FilipaRibeiro2020/Invictus2.0_Hardware/Boards/Rocket Systems/OBC/Renders/OBC_front.png

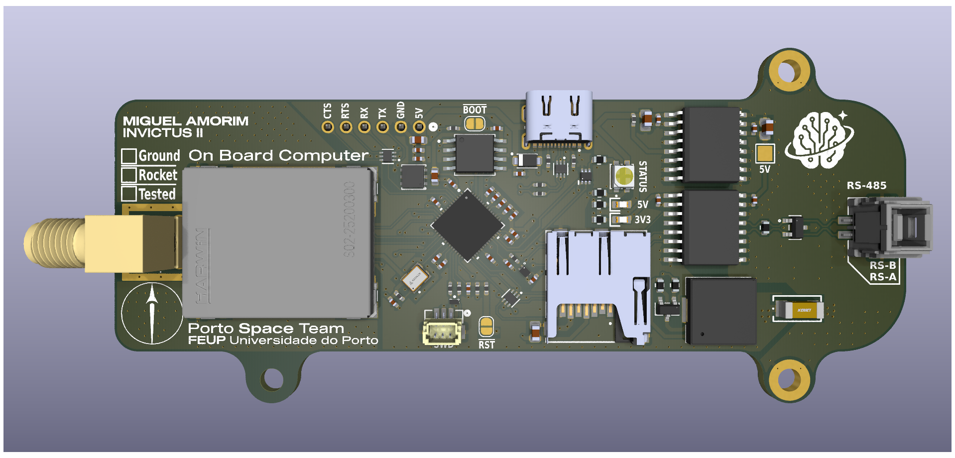
Boards/Rocket Systems/OBC/Renders/OBC_front.png
