FilipaRibeiro2020/Invictus2.0_Hardware/Boards/Rocket Systems/Elytra/Renders/Elytra_back.png

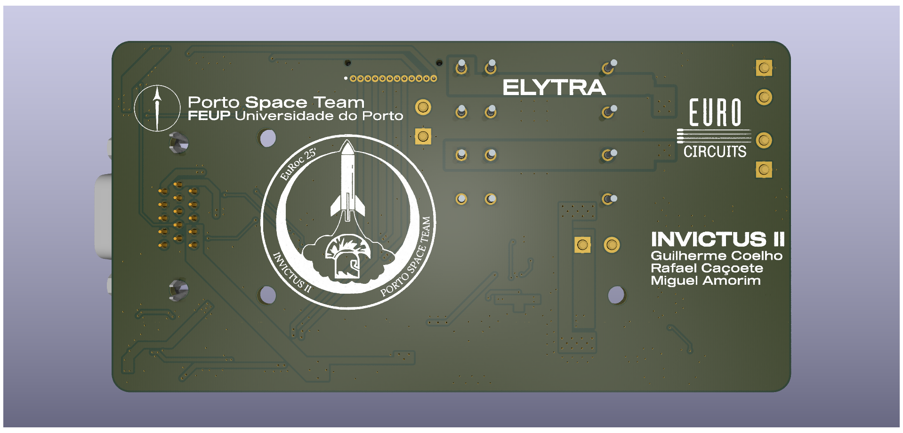
Boards/Rocket Systems/Elytra/Renders/Elytra_back.png
