FilipaRibeiro2020/Invictus2.0_Hardware/Boards/PayLoad/PocketSat/Renders/PocketSat_Front cropped.png

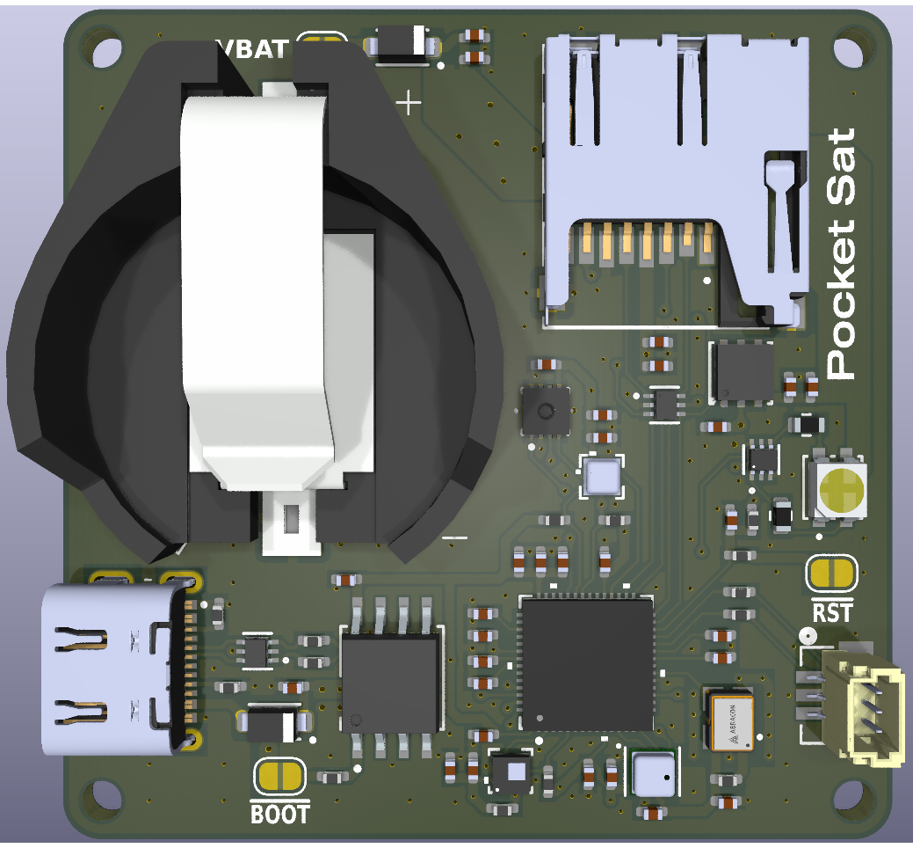
Boards/PayLoad/PocketSat/Renders/PocketSat_Front cropped.png
