FilipaRibeiro2020/Invictus2.0_Hardware/Boards/Rocket Systems/Elytra/Renders/Elytra_front.png

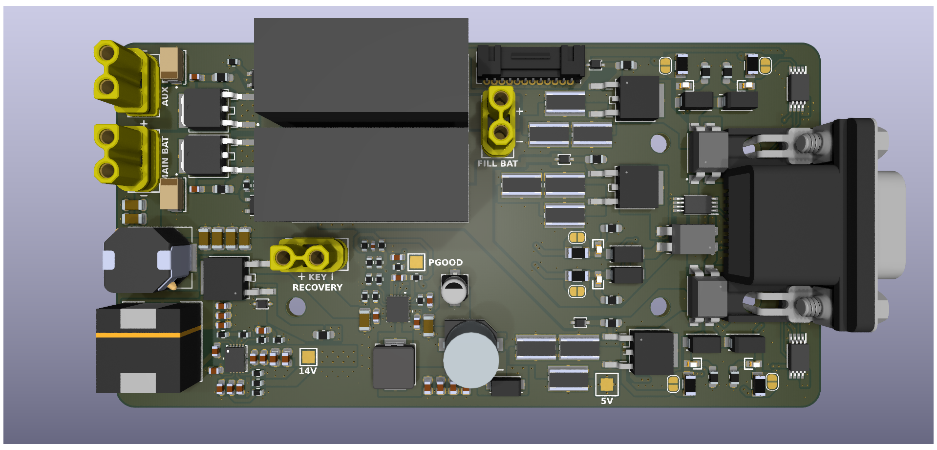
Boards/Rocket Systems/Elytra/Renders/Elytra_front.png
