FilipaRibeiro2020/Invictus2.0_Hardware/Boards/Rocket Systems/HYDRA/3D/HYDRA.png

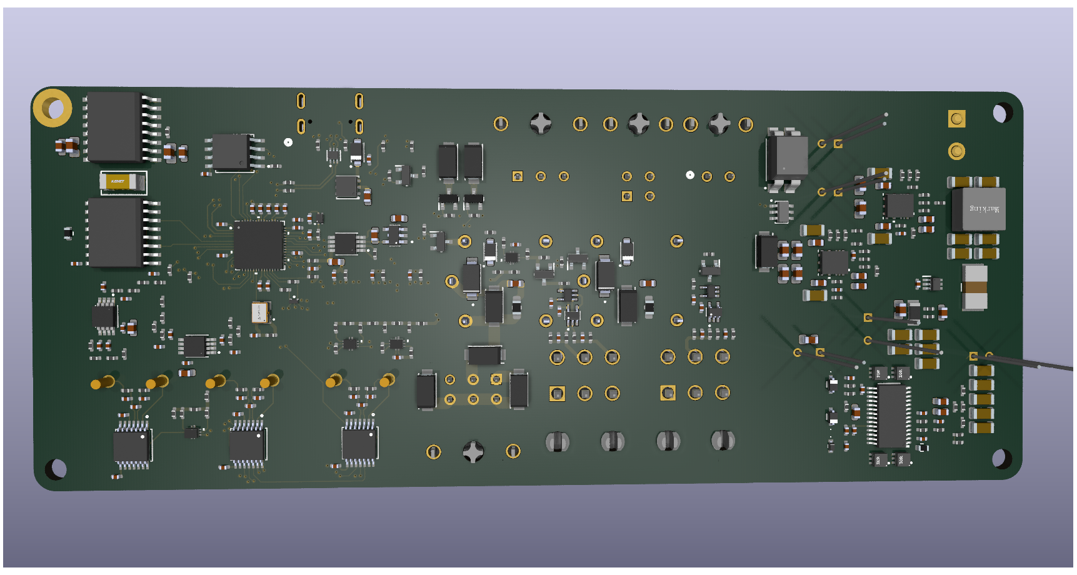
Boards/Rocket Systems/HYDRA/3D/HYDRA.png
