FilipaRibeiro2020/Invictus2.0_Hardware/Boards/Rocket Systems/Navigator/3D/Navigator_back.png

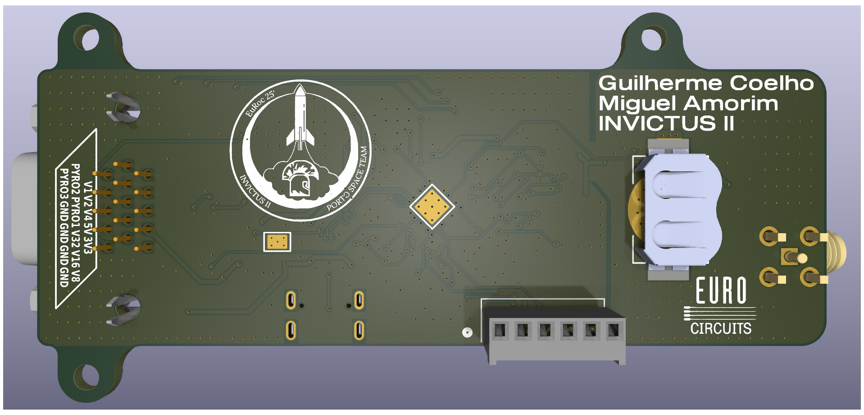
Boards/Rocket Systems/Navigator/3D/Navigator_back.png
