FilipaRibeiro2020/Invictus2.0_Hardware/Boards/Rocket Systems/Navigator/3D/Navigator_front.png

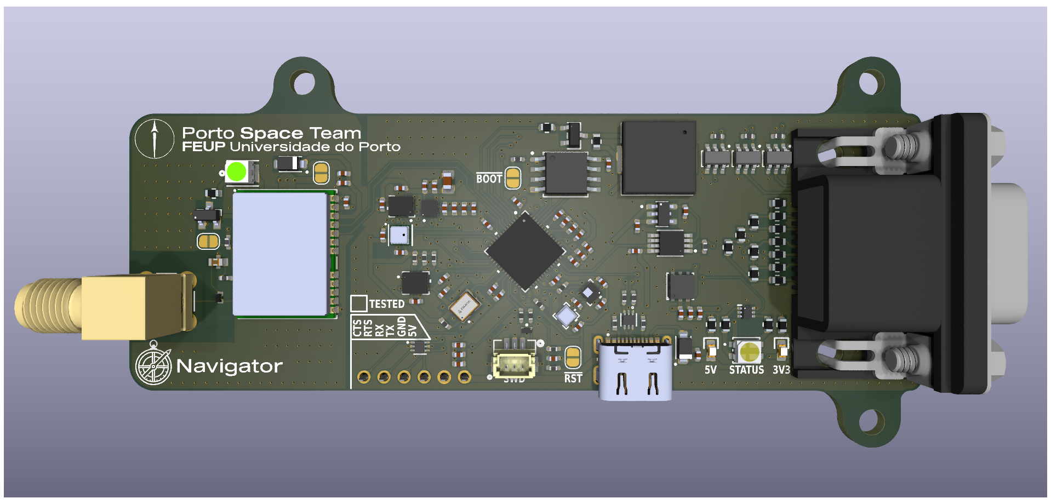
Boards/Rocket Systems/Navigator/3D/Navigator_front.png
