FilipaRibeiro2020/Invictus2.0_Hardware/Boards/Rocket Systems/OBC/Renders/OBC_back.png

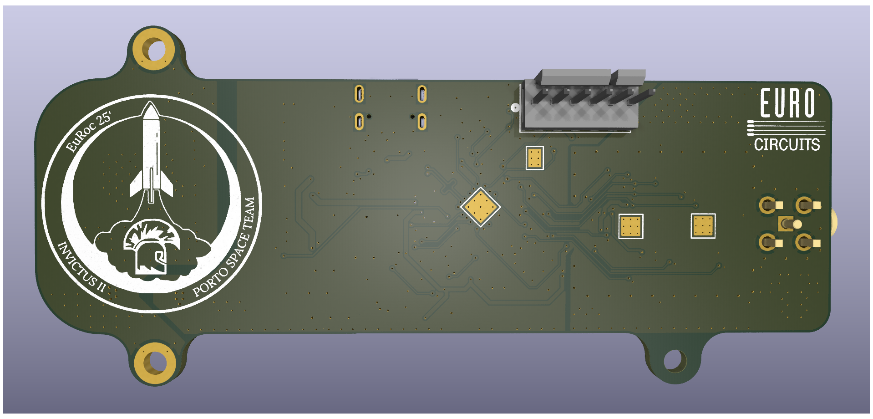
Boards/Rocket Systems/OBC/Renders/OBC_back.png
