FilipaRibeiro2020/Invictus2.0_Hardware/Boards/Rocket Systems/HYDRA/3D/HYDRA.step

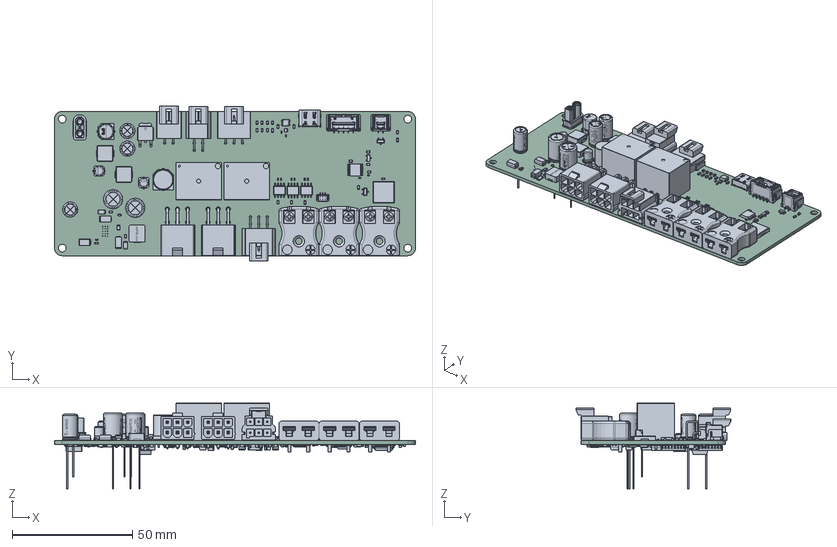
[picture p9: CAD file, 2025-10-10]
Boards/Rocket Systems/HYDRA/3D/HYDRA.step
150.0 x 64.2 x 35.6 mm
CAP_0603 x 31
FilletPin1 x 11
FilletPin2 x 11
RU-16_ADI
VLMY1300-GS08 x 5
RES_0402 x 115
標準品ケースΦ4x5.3L SIDE CODE B x 2
標準品座版Φ4 SIZE CODE B x 2
標準品リード線Φ4 SIZE CODE B x 4
BottomBlade x 6
Screw x 6
M2-Écrou x 6
TopBlade x 6
PKMCS0909E4000-R1
term1 x 14
term2 x 14
BODY-SO x 3
LEAD-SO x 24
THERMALPAD-SO x 3
STPS15L45CB
PinsArrayL x 7
FilletPinR x 6
XT30UPB-F
BZT52C8V2T-7 x 2
PR12-12V-360-1C x 2
CAP_0402 x 70
RC1206FR-0710RL x 3
VLMKG3400-GS08
Inductor-7.2mm-4u7
NSVT30010MXV6T1G
SOT23-3_LTF
BM03B-SRSS-TB-LF-SN
SRP 7028A series.stp x 2
Base
Pin1Fillet
Pin2Fillet
DX07S016JA1R1500
BC846BLT1G
EDK107M035S9HAA
CAP_0805 x 10
WQFN10_1P4X1P8_ONS x 4
QFN56_7X7_RPI
MAX31856MUD+T x 3
RES_2512
SN74AHC1G86DCKRE4 x 2
SOT23 lower body x 2
SOT23 Lead x 6
SOT23 Upper body x 2
PinsArrayR
ThermalPin
PinsArrayLR x 3
G3VM-DR_OMR
BODY-QFN_AF0 x 2
PIN1-ID x 2
ESD122DMYR
BODY-SOIC
LEAD-DW0016 x 16
PMEG2010ER x 3
SMAJ12A x 2
MSOP8_MC_MCH x 3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
