FilipaRibeiro2020/Invictus2.0_Hardware/Symbols Lib/Contacts&Switches/10-18-1041/10-18-1041.stp

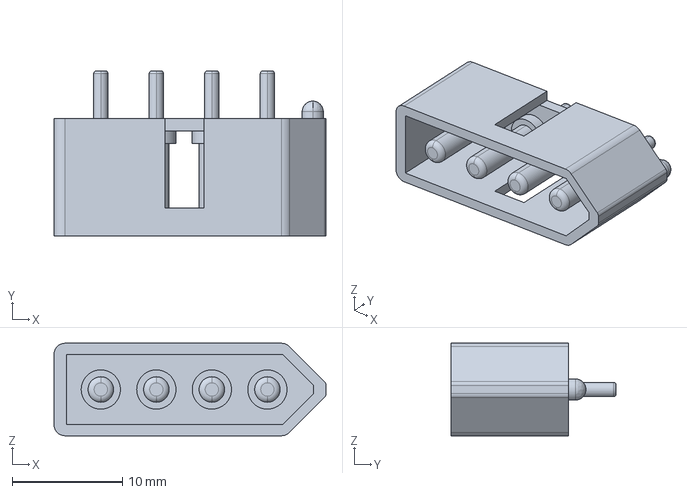
[picture p10: CAD file, 2025-10-10]
Symbols Lib/Contacts&Switches/10-18-1041/10-18-1041.stp
24.6 x 15.0 x 8.38 mm
