FilipaRibeiro2020/Invictus2.0_Hardware/Symbols Lib/Contacts&Switches/39-28-8080/39-28-8080.stp

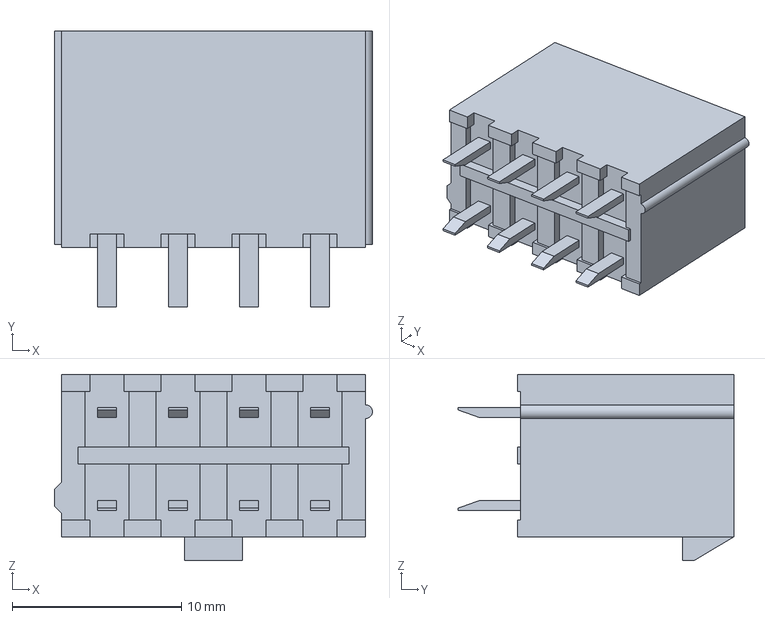
[picture p11: CAD file, 2025-10-10]
Symbols Lib/Contacts&Switches/39-28-8080/39-28-8080.stp
18.8 x 16.3 x 11.0 mm
