FilipaRibeiro2020/Invictus2.0_Hardware/Symbols Lib/Contacts&Switches/PR12-12V-360-1C/PR12-12V-360-1C.step

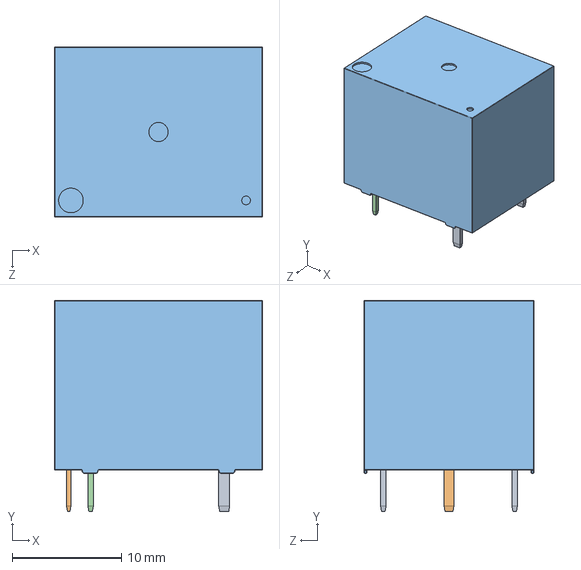
[picture p12: CAD file, 2025-10-10]
Symbols Lib/Contacts&Switches/PR12-12V-360-1C/PR12-12V-360-1C.step
19.0 x 19.3 x 15.5 mm
