FilipaRibeiro2020/Invictus2.0_Hardware/Symbols Lib/Contacts&Switches/PR30-12V-450-1C-E/PR30-12V-450-1C-E.step

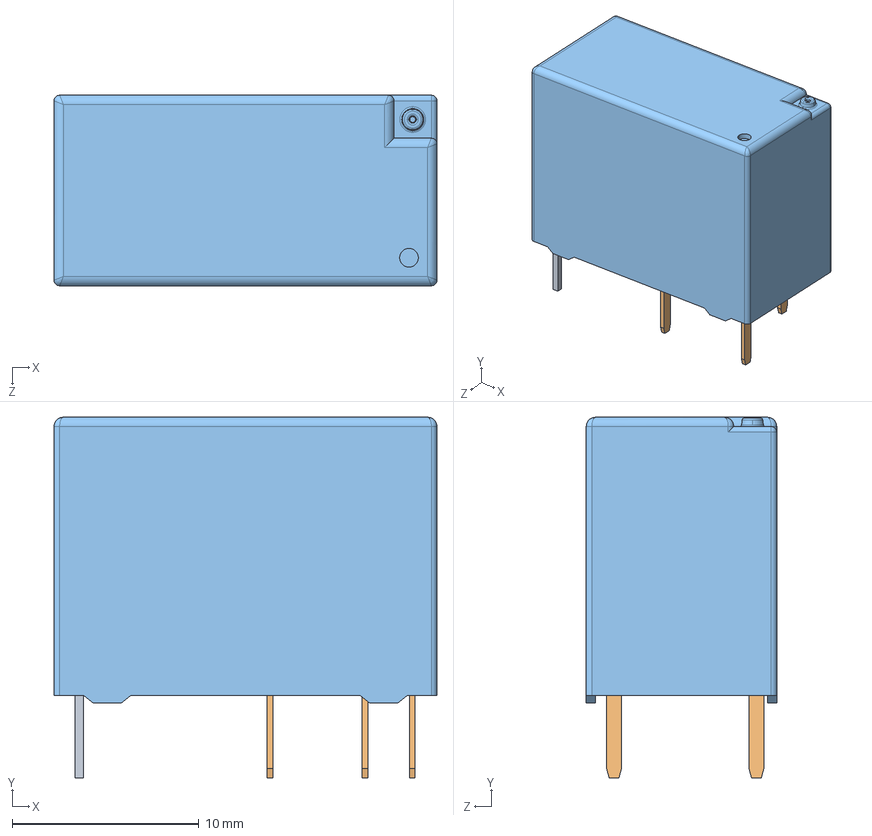
[picture p13: CAD file, 2025-10-10]
Symbols Lib/Contacts&Switches/PR30-12V-450-1C-E/PR30-12V-450-1C-E.step
20.5 x 19.3 x 10.2 mm
