FilipaRibeiro2020/Invictus2.0_Hardware/Symbols Lib/Contacts&Switches/ThermoPCBConnector/AM-K-PCB.step

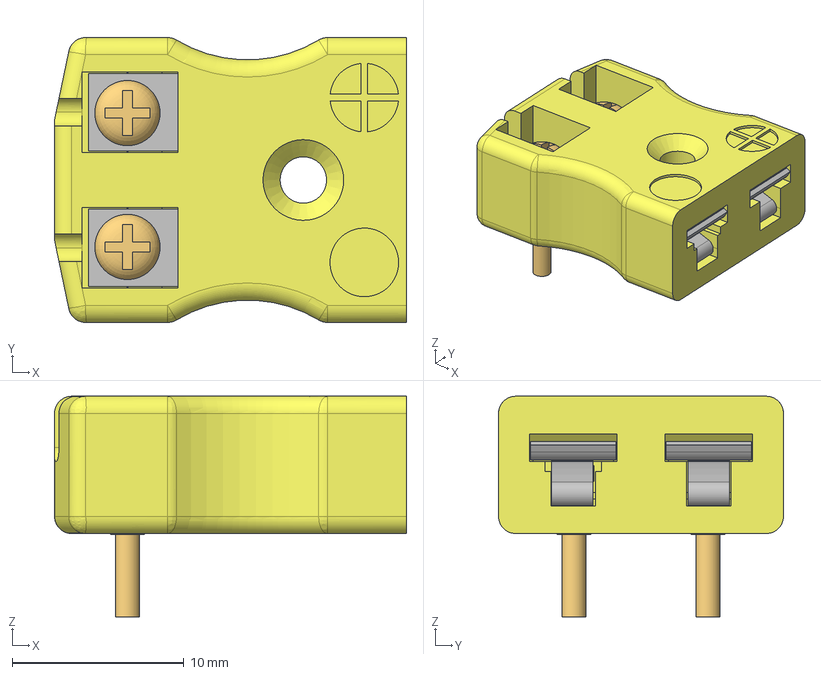
[picture p14: CAD file, 2025-08-11]
Symbols Lib/Contacts&Switches/ThermoPCBConnector/AM-K-PCB.step
20.5 x 16.6 x 12.9 mm
BottomBlade x 2
Screw x 2
M2-Écrou x 2
TopBlade x 2
