FilipaRibeiro2020/Invictus2.0_Hardware/Symbols Lib/Contacts&Switches/XT30UPB-F/XT30UPB-F.stp

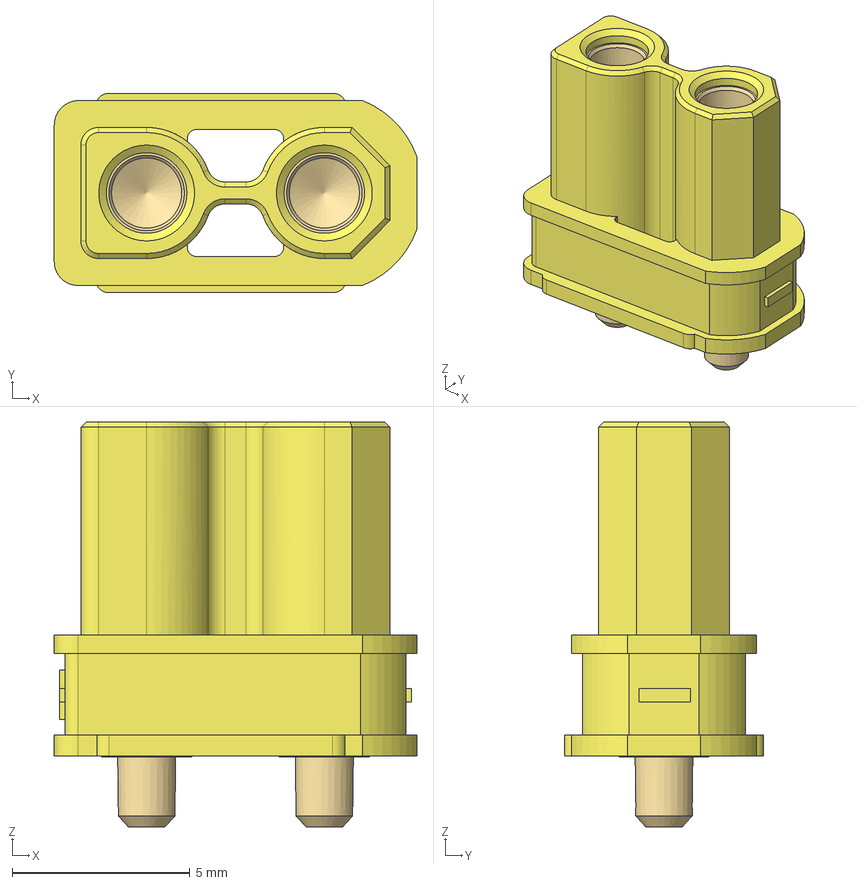
[picture p15: CAD file, 2025-08-11]
Symbols Lib/Contacts&Switches/XT30UPB-F/XT30UPB-F.stp
10.2 x 5.61 x 11.4 mm
