FilipaRibeiro2020/Invictus2.0_Hardware/Symbols Lib/ICs/2SCR375P5T100R/TRANS_2SA2071P_ROM.step

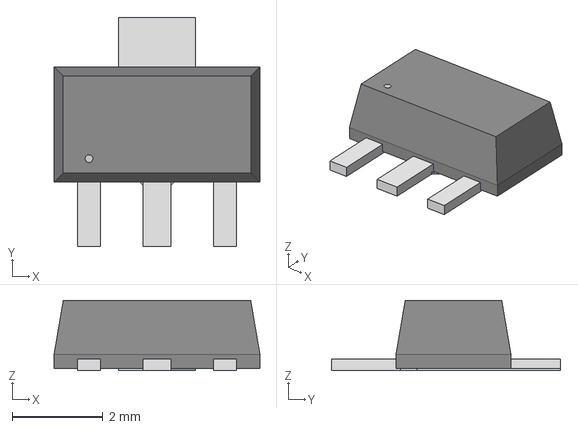
[picture p16: CAD file, 2025-10-10]
Symbols Lib/ICs/2SCR375P5T100R/TRANS_2SA2071P_ROM.step
4.55 x 5.05 x 1.55 mm
