FilipaRibeiro2020/Invictus2.0_Hardware/Symbols Lib/ICs/74AHC1G08SE-7/74AHC1G08SE-7.step

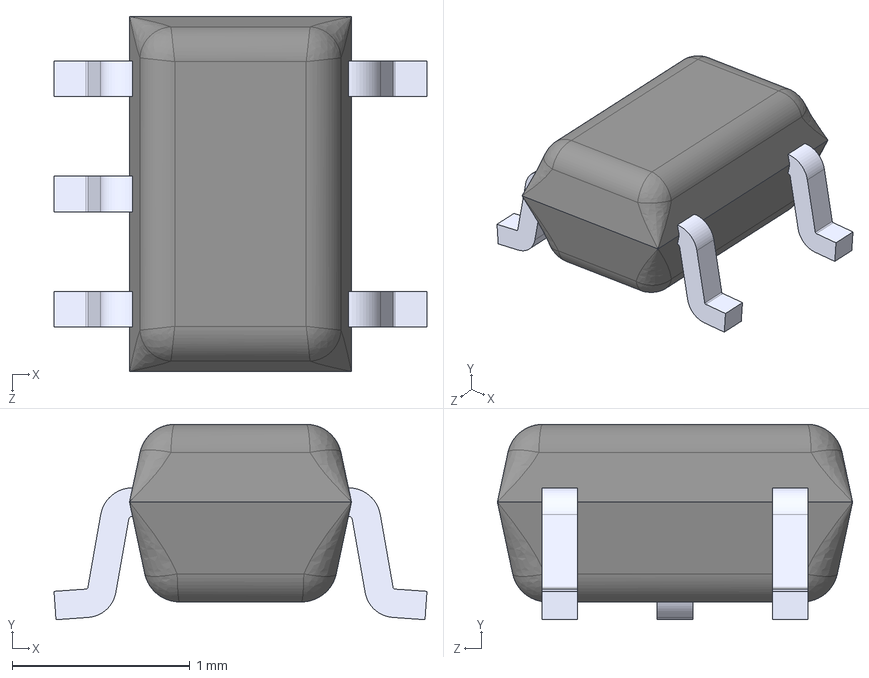
[picture p17: CAD file, 2025-10-10]
Symbols Lib/ICs/74AHC1G08SE-7/74AHC1G08SE-7.step
2.10 x 1.10 x 2.00 mm
