FilipaRibeiro2020/Invictus2.0_Hardware/Symbols Lib/ICs/BC846BLT1G/BC846BLT1G.step

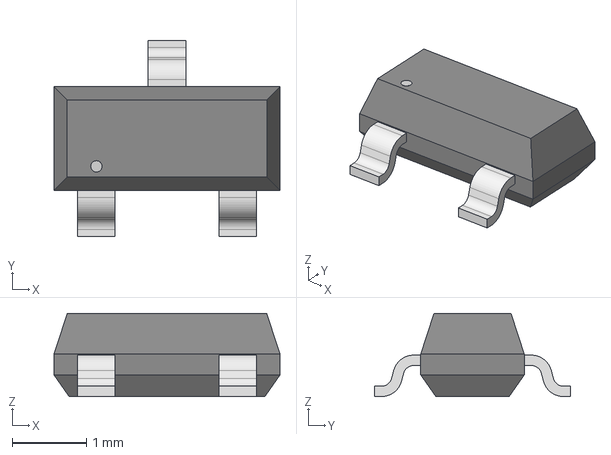
[picture p18: CAD file, 2025-08-11]
Symbols Lib/ICs/BC846BLT1G/BC846BLT1G.step
3.05 x 2.64 x 1.12 mm
