FilipaRibeiro2020/Invictus2.0_Hardware/Symbols Lib/ICs/BSS123/BSS123.stp

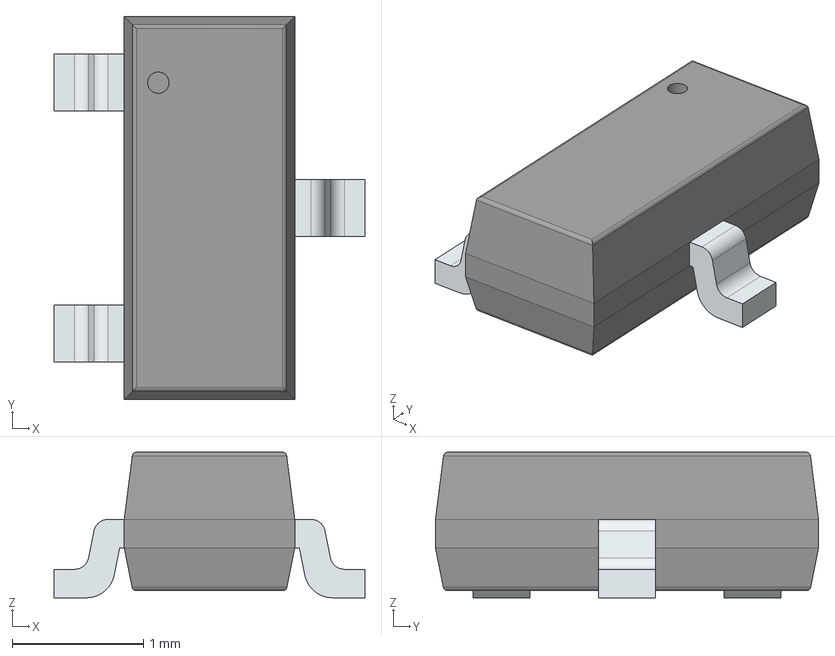
[picture p19: CAD file, 2025-10-10]
Symbols Lib/ICs/BSS123/BSS123.stp
2.37 x 2.92 x 1.11 mm
PinsArrayL
FilletPinR
