FilipaRibeiro2020/Invictus2.0_Hardware/Symbols Lib/ICs/IRLHS6242TRPBF/IRLHS6242TRPBF.stp

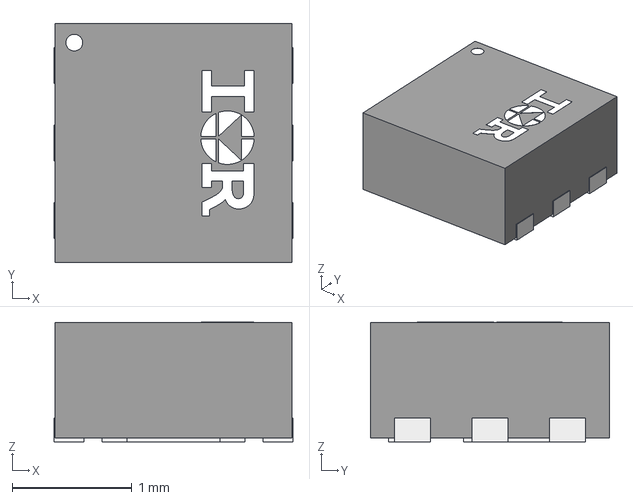
[picture p20: CAD file, 2025-10-10]
Symbols Lib/ICs/IRLHS6242TRPBF/IRLHS6242TRPBF.stp
2.00 x 2.00 x 1.00 mm
