FilipaRibeiro2020/Invictus2.0_Hardware/Symbols Lib/ICs/LM358BIPWR/LM358BIPWR.stp

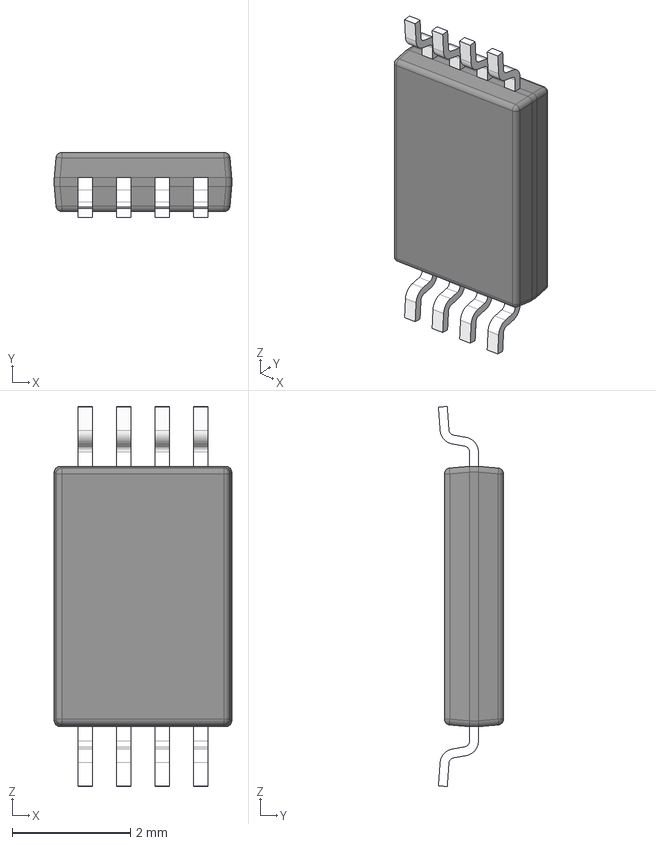
[picture p21: CAD file, 2025-08-19]
Symbols Lib/ICs/LM358BIPWR/LM358BIPWR.stp
3.00 x 1.10 x 6.42 mm
BODY-SO
LEAD-SO x 8
PIN1-ID
