FilipaRibeiro2020/Invictus2.0_Hardware/Symbols Lib/ICs/MCP6002-E-MS/MSOP8_MC_MCH.step

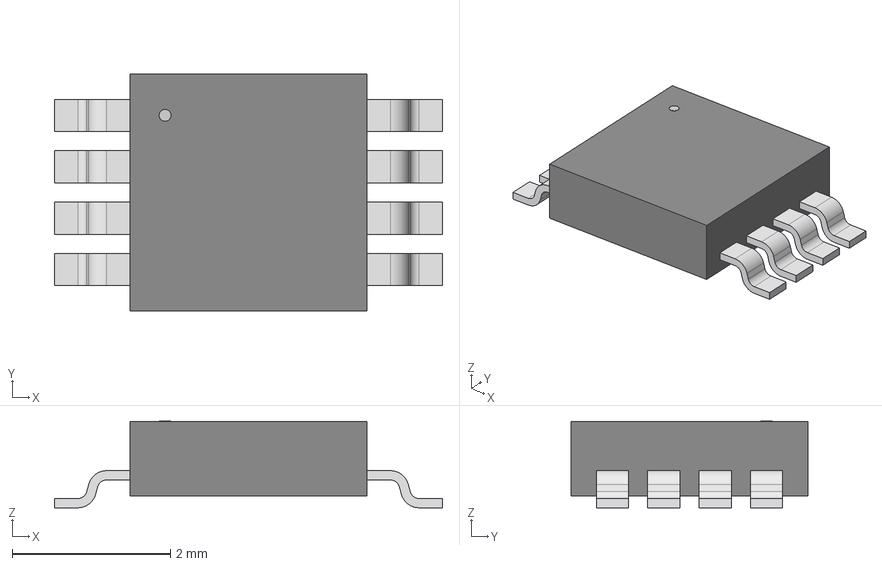
[picture p22: CAD file, 2025-08-11]
Symbols Lib/ICs/MCP6002-E-MS/MSOP8_MC_MCH.step
4.90 x 3.00 x 1.09 mm
