FilipaRibeiro2020/Invictus2.0_Hardware/Symbols Lib/ICs/NCV8114ASN165T1G/NCV8114ASN165T1G.step

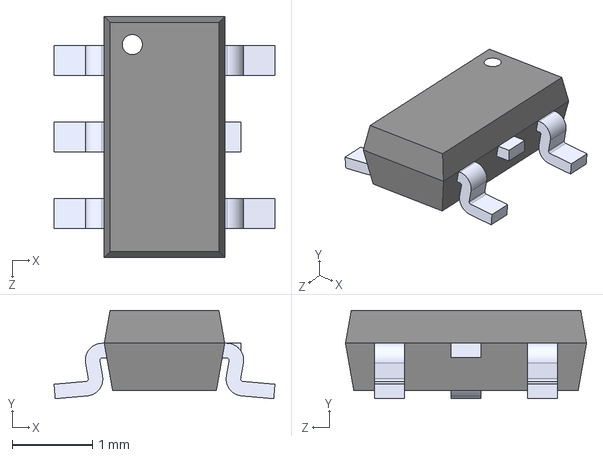
[picture p23: CAD file, 2025-08-11]
Symbols Lib/ICs/NCV8114ASN165T1G/NCV8114ASN165T1G.step
2.75 x 1.10 x 3.00 mm
