FilipaRibeiro2020/Invictus2.0_Hardware/Symbols Lib/ICs/NJD35N04T4G/DPAK-4_6P22X6P73_ONS.step

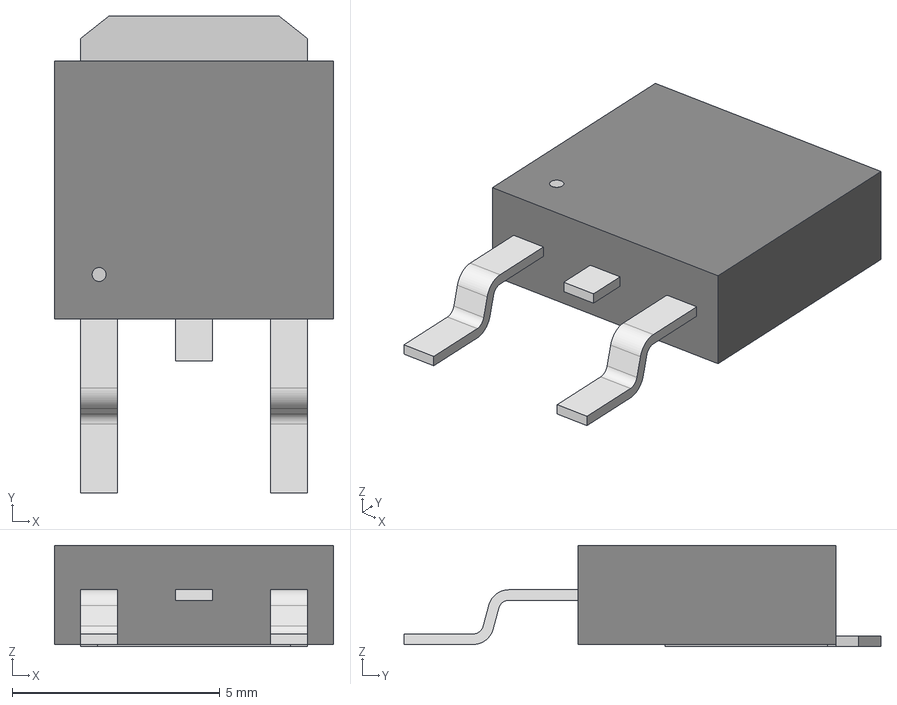
[picture p24: CAD file, 2025-08-19]
Symbols Lib/ICs/NJD35N04T4G/DPAK-4_6P22X6P73_ONS.step
6.73 x 11.5 x 2.44 mm
