FilipaRibeiro2020/Invictus2.0_Hardware/Symbols Lib/ICs/NLAS5223BMNR2G/WQFN10_1P4X1P8_ONS.step

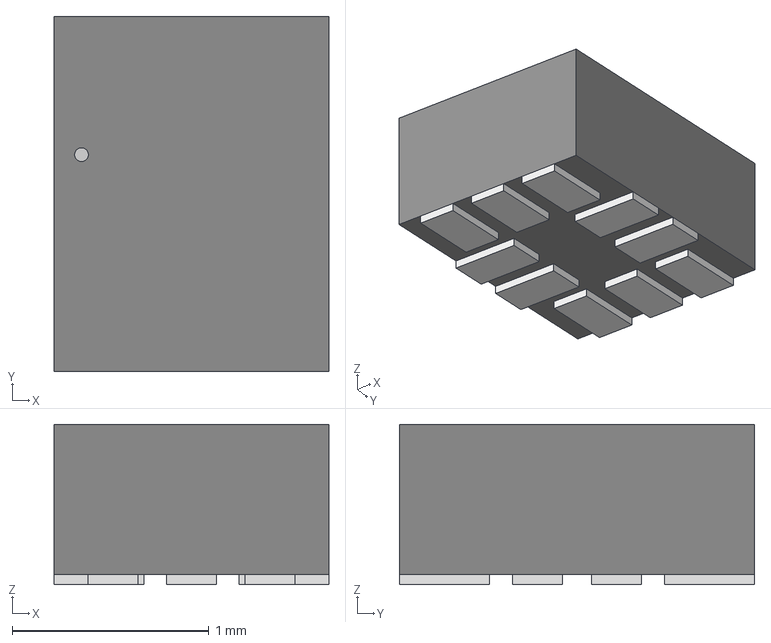
[picture p25: CAD file, 2025-08-11]
Symbols Lib/ICs/NLAS5223BMNR2G/WQFN10_1P4X1P8_ONS.step
1.40 x 1.80 x 0.815 mm
