FilipaRibeiro2020/Invictus2.0_Hardware/Symbols Lib/ICs/NSVT30010MXV6T1G/NSVT30010MXV6T1G.STEP

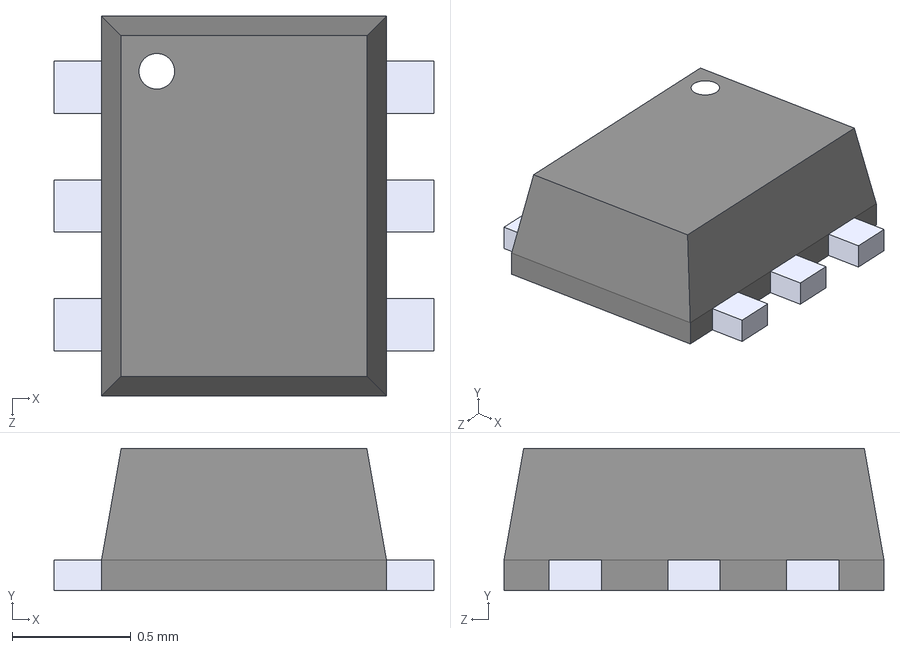
[picture p26: CAD file, 2025-08-19]
Symbols Lib/ICs/NSVT30010MXV6T1G/NSVT30010MXV6T1G.STEP
1.60 x 0.6 x 1.60 mm
