FilipaRibeiro2020/Invictus2.0_Hardware/Symbols Lib/ICs/PMV20XNER/PMV20XNER.stp

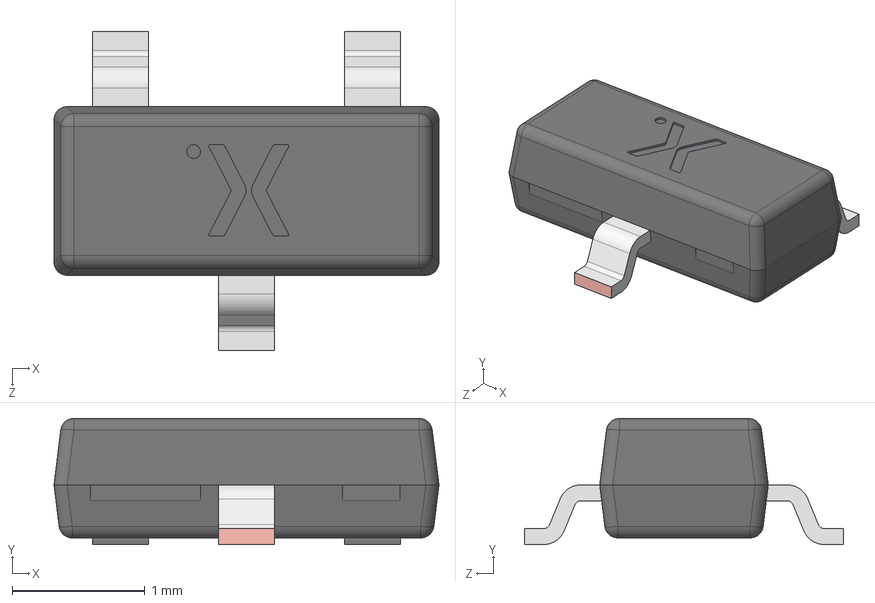
[picture p27: CAD file, 2025-10-10]
Symbols Lib/ICs/PMV20XNER/PMV20XNER.stp
2.90 x 0.95 x 2.40 mm
SOT23 lower body
SOT23 Lead x 3
SOT23 Upper body
