FilipaRibeiro2020/Invictus2.0_Hardware/Symbols Lib/ICs/SN74AHC1G86DCKRE4/SN74AHC1G86DCKRE4.step

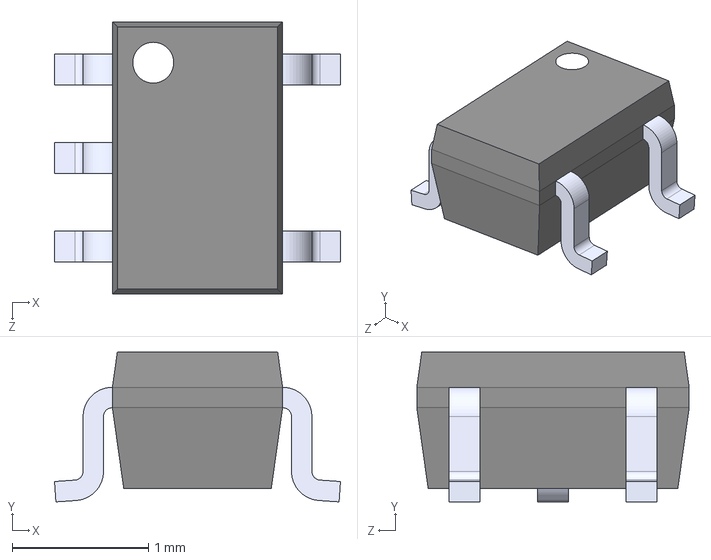
[picture p28: CAD file, 2025-10-10]
Symbols Lib/ICs/SN74AHC1G86DCKRE4/SN74AHC1G86DCKRE4.step
2.10 x 1.10 x 2.00 mm
