FilipaRibeiro2020/Invictus2.0_Hardware/Symbols Lib/ICs/STPS15L45CB/STPS15L45CB.stp

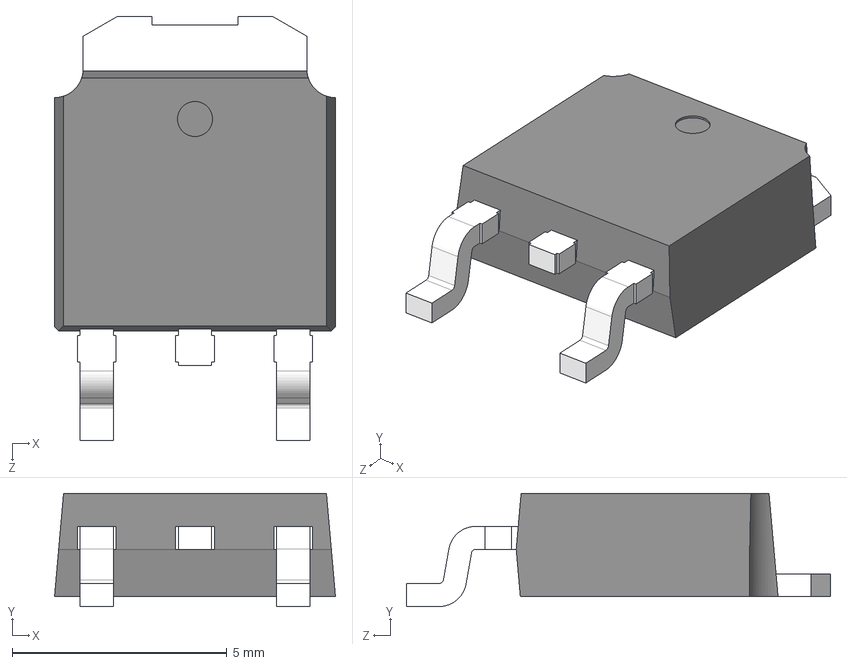
[picture p29: CAD file, 2025-08-19]
Symbols Lib/ICs/STPS15L45CB/STPS15L45CB.stp
6.54 x 2.63 x 9.88 mm
