FilipaRibeiro2020/Invictus2.0_Hardware/Symbols Lib/Passive Components/Capacitor-6.3mm/EDK107M035S9HAA.stp

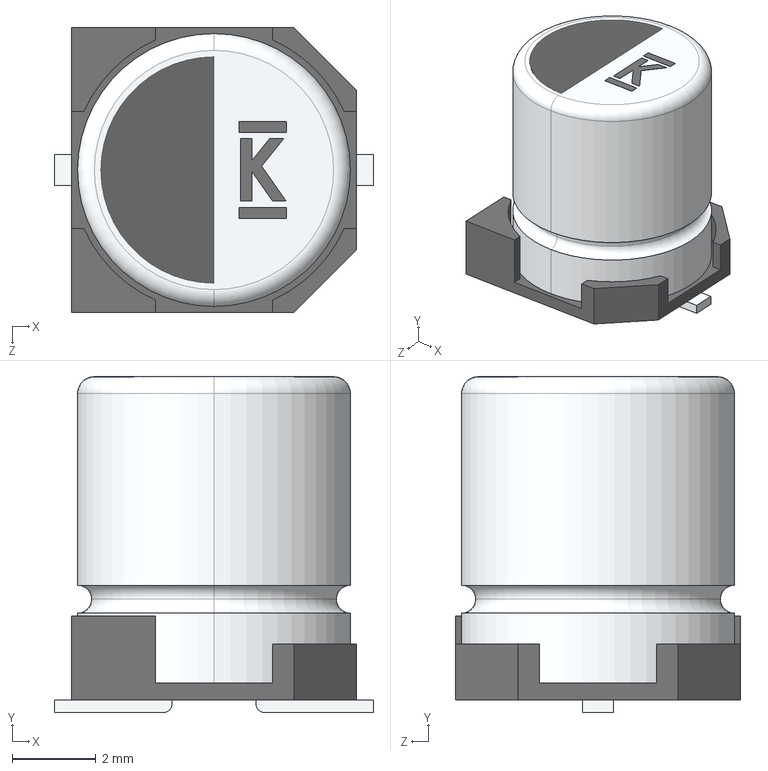
[picture p30: CAD file, 2025-10-10]
Symbols Lib/Passive Components/Capacitor-6.3mm/EDK107M035S9HAA.stp
7.60 x 8.01 x 6.80 mm
