FilipaRibeiro2020/Invictus2.0_Hardware/Symbols Lib/Passive Components/Capacitor-THT-6.3mm/Capacitor-6.3mm-THT.stp

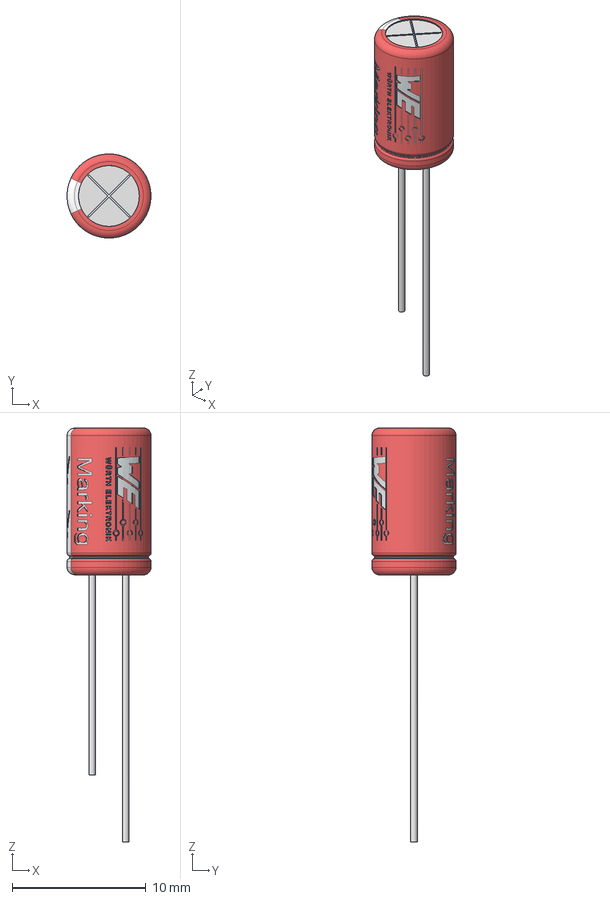
[picture p31: CAD file, 2025-08-19]
Symbols Lib/Passive Components/Capacitor-THT-6.3mm/Capacitor-6.3mm-THT.stp
6.29 x 6.30 x 31.0 mm
