FilipaRibeiro2020/Invictus2.0_Hardware/Symbols Lib/Passive Components/Capacitor-THT-8mm/Cap-8mm-THT.stp

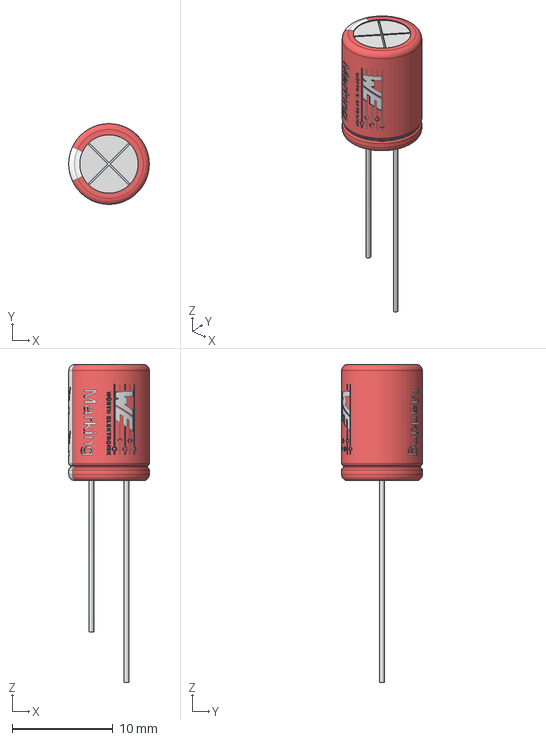
[picture p32: CAD file, 2025-08-19]
Symbols Lib/Passive Components/Capacitor-THT-8mm/Cap-8mm-THT.stp
7.99 x 8.00 x 31.5 mm
