FilipaRibeiro2020/Invictus2.0_Hardware/Symbols Lib/Passive Components/Diodo_BAS316,115/BAS316-115.STEP

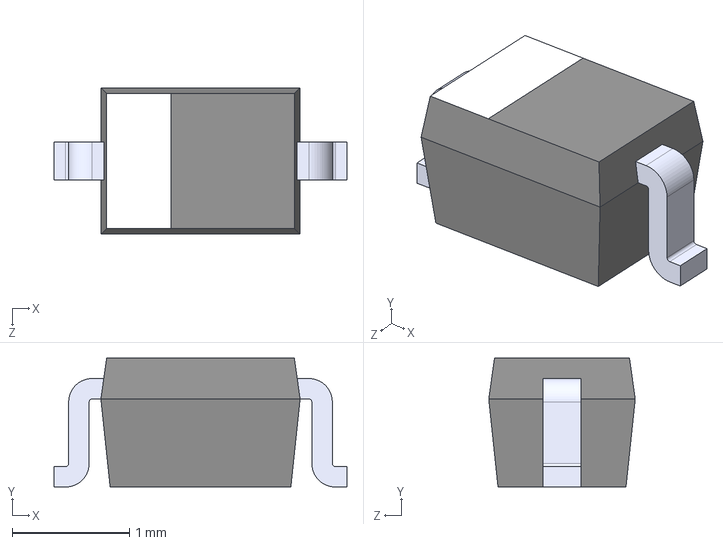
[picture p33: CAD file, 2025-10-10]
Symbols Lib/Passive Components/Diodo_BAS316,115/BAS316-115.STEP
2.50 x 1.10 x 1.25 mm
