FilipaRibeiro2020/Invictus2.0_Hardware/Symbols Lib/Passive Components/Diodo_BZT52C8V2T-7/BZT52C8V2T-7.STEP

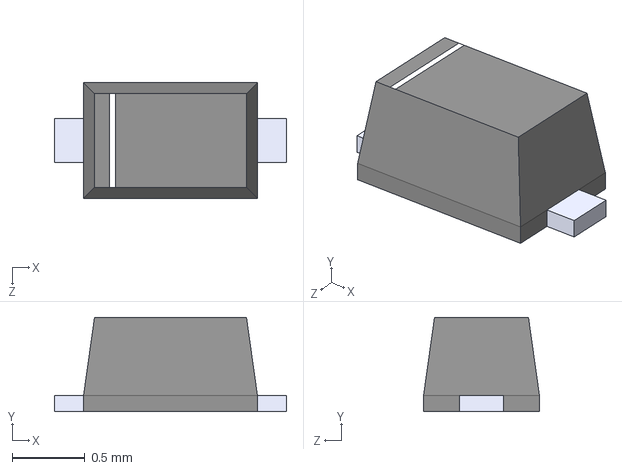
[picture p34: CAD file, 2025-10-10]
Symbols Lib/Passive Components/Diodo_BZT52C8V2T-7/BZT52C8V2T-7.STEP
1.60 x 0.65 x 0.8 mm
