FilipaRibeiro2020/Invictus2.0_Hardware/Symbols Lib/Passive Components/G2RL-1A4-E-DC12/G2RL-1A4-E-DC12.stp

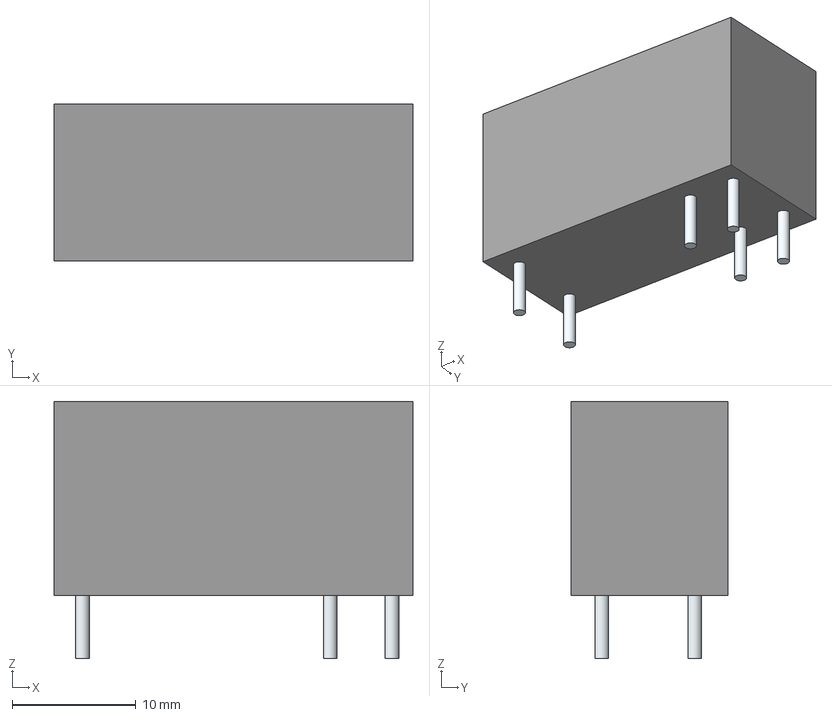
[picture p35: CAD file, 2025-08-11]
Symbols Lib/Passive Components/G2RL-1A4-E-DC12/G2RL-1A4-E-DC12.stp
29.0 x 12.7 x 20.8 mm
Leads x 6
