FilipaRibeiro2020/Invictus2.0_Hardware/Symbols Lib/Passive Components/Inductor-7.2mm-4u7/Inductor-7.2mm-4u7.step

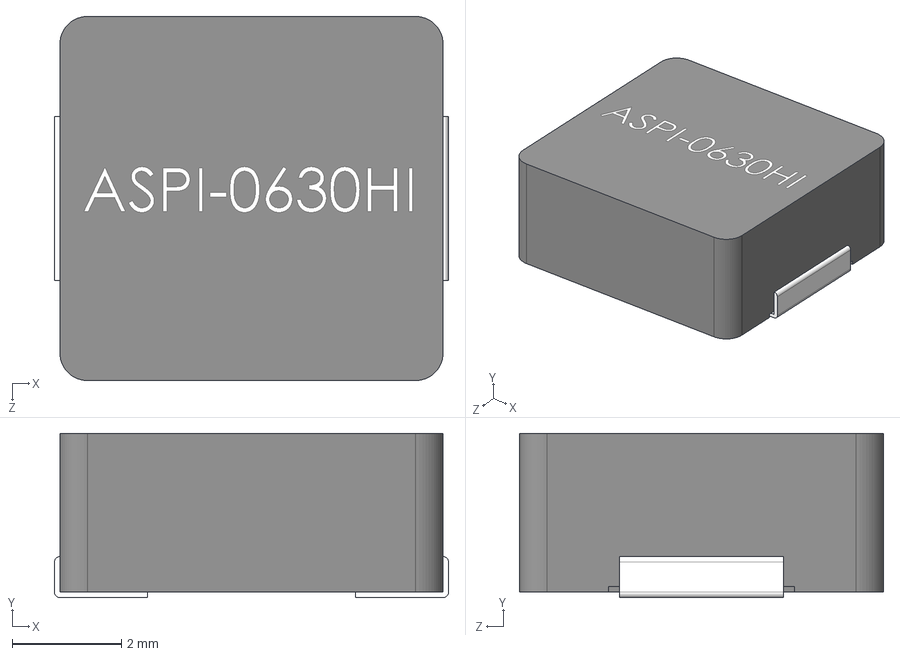
[picture p36: CAD file, 2025-10-10]
Symbols Lib/Passive Components/Inductor-7.2mm-4u7/Inductor-7.2mm-4u7.step
7.20 x 3.00 x 6.65 mm
