FilipaRibeiro2020/Invictus2.0_Hardware/Symbols Lib/Passive Components/Inductor-7.3mm-10u/Inductor-7.3mm-10u.stp

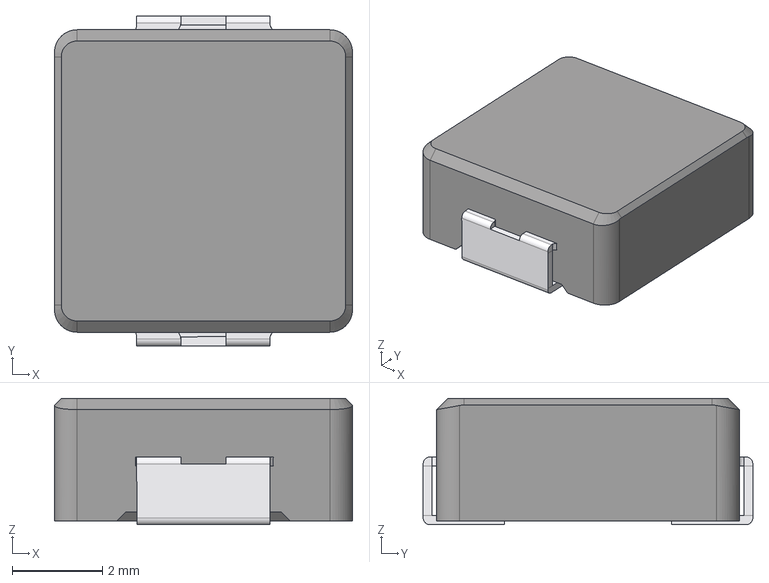
[picture p37: CAD file, 2025-10-10]
Symbols Lib/Passive Components/Inductor-7.3mm-10u/Inductor-7.3mm-10u.stp
6.60 x 7.30 x 2.80 mm
