FilipaRibeiro2020/Invictus2.0_Hardware/Symbols Lib/Passive Components/Inductor_SRP6030CA/SRP6030CA-2R2M.stp

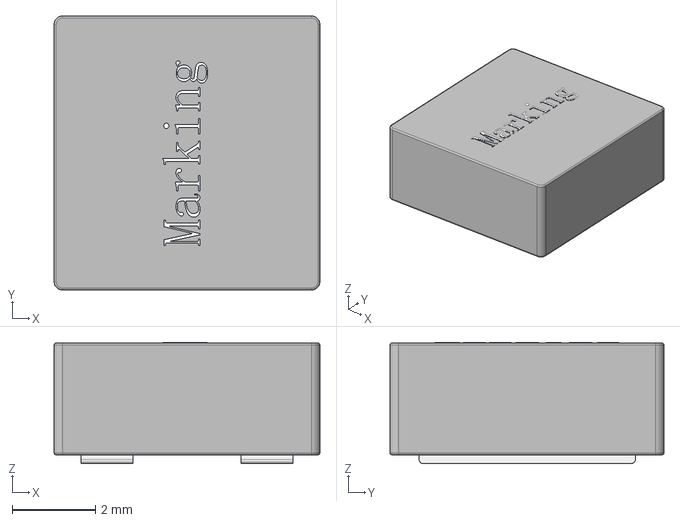
[picture p38: CAD file, 2025-10-10]
Symbols Lib/Passive Components/Inductor_SRP6030CA/SRP6030CA-2R2M.stp
6.40 x 6.60 x 2.92 mm
