FilipaRibeiro2020/Invictus2.0_Hardware/Symbols Lib/Passive Components/PFNF.035.2/PFNF.035.2.STEP

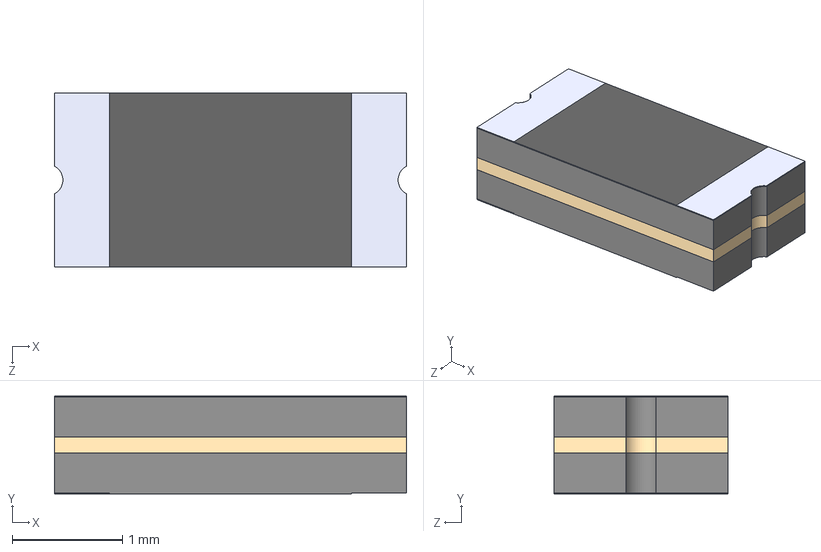
[picture p39: CAD file, 2025-08-19]
Symbols Lib/Passive Components/PFNF.035.2/PFNF.035.2.STEP
3.20 x 0.89 x 1.59 mm
