FilipaRibeiro2020/Invictus2.0_Hardware/Symbols Lib/Passive Components/Resistor-1206/RC1206FR-0710RL.stp

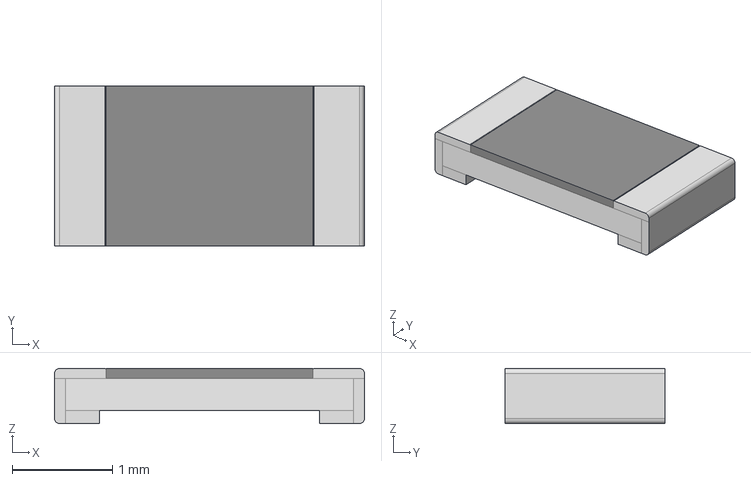
[picture p40: CAD file, 2025-08-19]
Symbols Lib/Passive Components/Resistor-1206/RC1206FR-0710RL.stp
3.10 x 1.60 x 0.55 mm
