FilipaRibeiro2020/Invictus2.0_Hardware/Symbols Lib/Passive Components/Resistor-2512/RES_2512.step

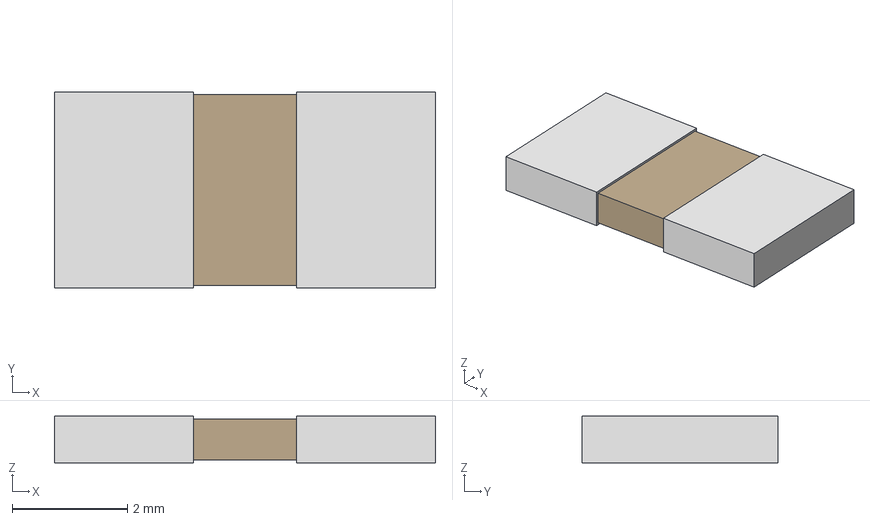
[picture p41: CAD file, 2025-10-10]
Symbols Lib/Passive Components/Resistor-2512/RES_2512.step
6.60 x 3.40 x 0.813 mm
