FilipaRibeiro2020/Invictus2.0_Hardware/Symbols Lib/Passive Components/SMAJ12A/SMAJ12A.step

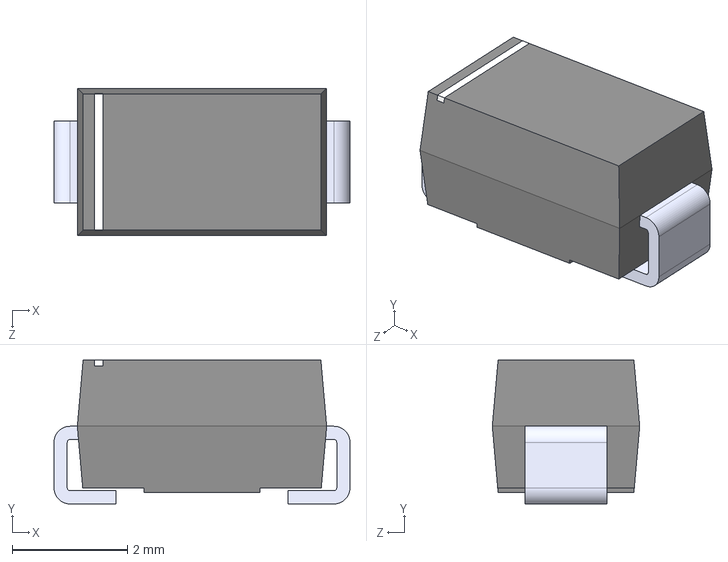
[picture p42: CAD file, 2025-10-10]
Symbols Lib/Passive Components/SMAJ12A/SMAJ12A.step
5.14 x 2.50 x 2.56 mm
