FilipaRibeiro2020/Invictus2.0_Hardware/Symbols Lib/Passive Components/SMAJ14A/SMASeries_LTF.step

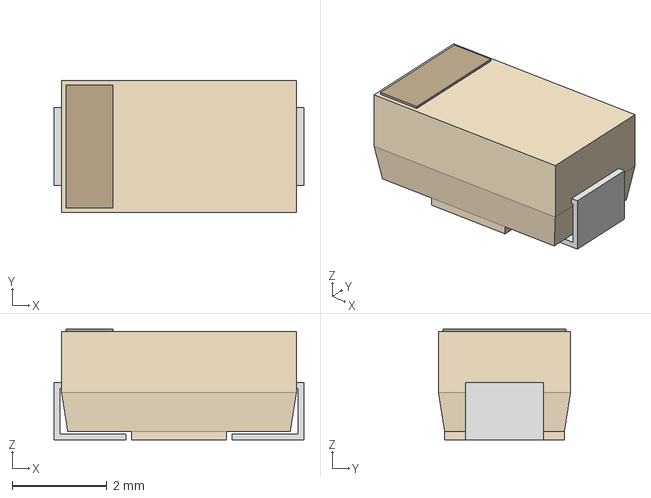
[picture p43: CAD file, 2025-08-11]
Symbols Lib/Passive Components/SMAJ14A/SMASeries_LTF.step
5.28 x 2.79 x 2.34 mm
