FilipaRibeiro2020/Invictus2.0_Hardware/Symbols Lib/Passive Components/VBT4045BP-E3-4W/DPAK_BP-E34W_VIS.step

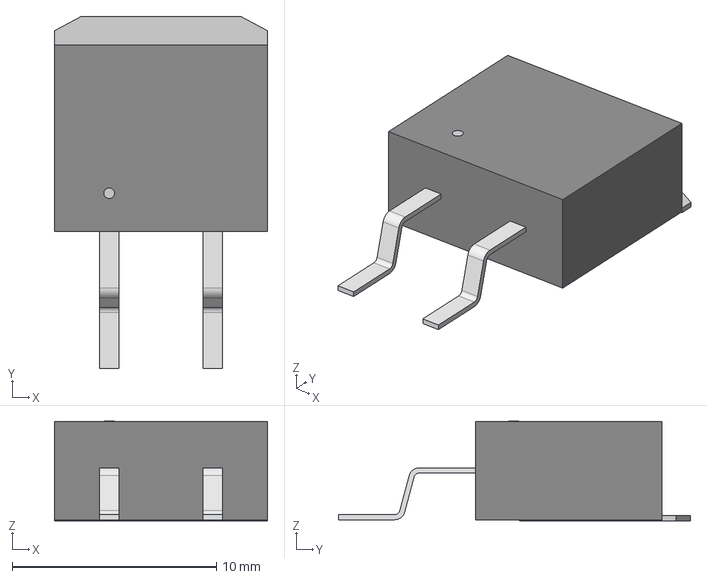
[picture p44: CAD file, 2025-08-11]
Symbols Lib/Passive Components/VBT4045BP-E3-4W/DPAK_BP-E34W_VIS.step
10.4 x 17.2 x 4.88 mm
