FilipaRibeiro2020/Invictus2.0_Hardware/(list of files, cad)

Other CAD files:
Symbols Lib/Contacts&Switches/1723103102/1723103102.step
Symbols Lib/Contacts&Switches/1723103103/1723103103.step
Symbols Lib/Contacts&Switches/1723163206/1723163206.step
Symbols Lib/Contacts&Switches/1723163304/1723163304.step
Symbols Lib/Contacts&Switches/26013116/26013116.step
Symbols Lib/Contacts&Switches/5024430270/5024430270.stp
Symbols Lib/Contacts&Switches/5024430570/5024430570.stp
Symbols Lib/Contacts&Switches/CONN02_532540270_MOL/532540270.stp
Symbols Lib/Contacts&Switches/CONN_5569-10A_MOL/0039300100.stp
Symbols Lib/Contacts&Switches/PB114012/PB114012.stp
Symbols Lib/ICs/ISL21010CFH325Z-TK/ISL21010CFH325Z-TK.stp
Symbols Lib/ICs/Thermocouple/MAX31856MUD+T.STEP
Symbols Lib/Passive Components/RES-2512 Reversed/RCL122516R0JNEG.step
