FilipaRibeiro2020/Invictus2.0_Hardware/Boards/Rocket Systems/HYDRA/Schematics/HYDRA.pdf

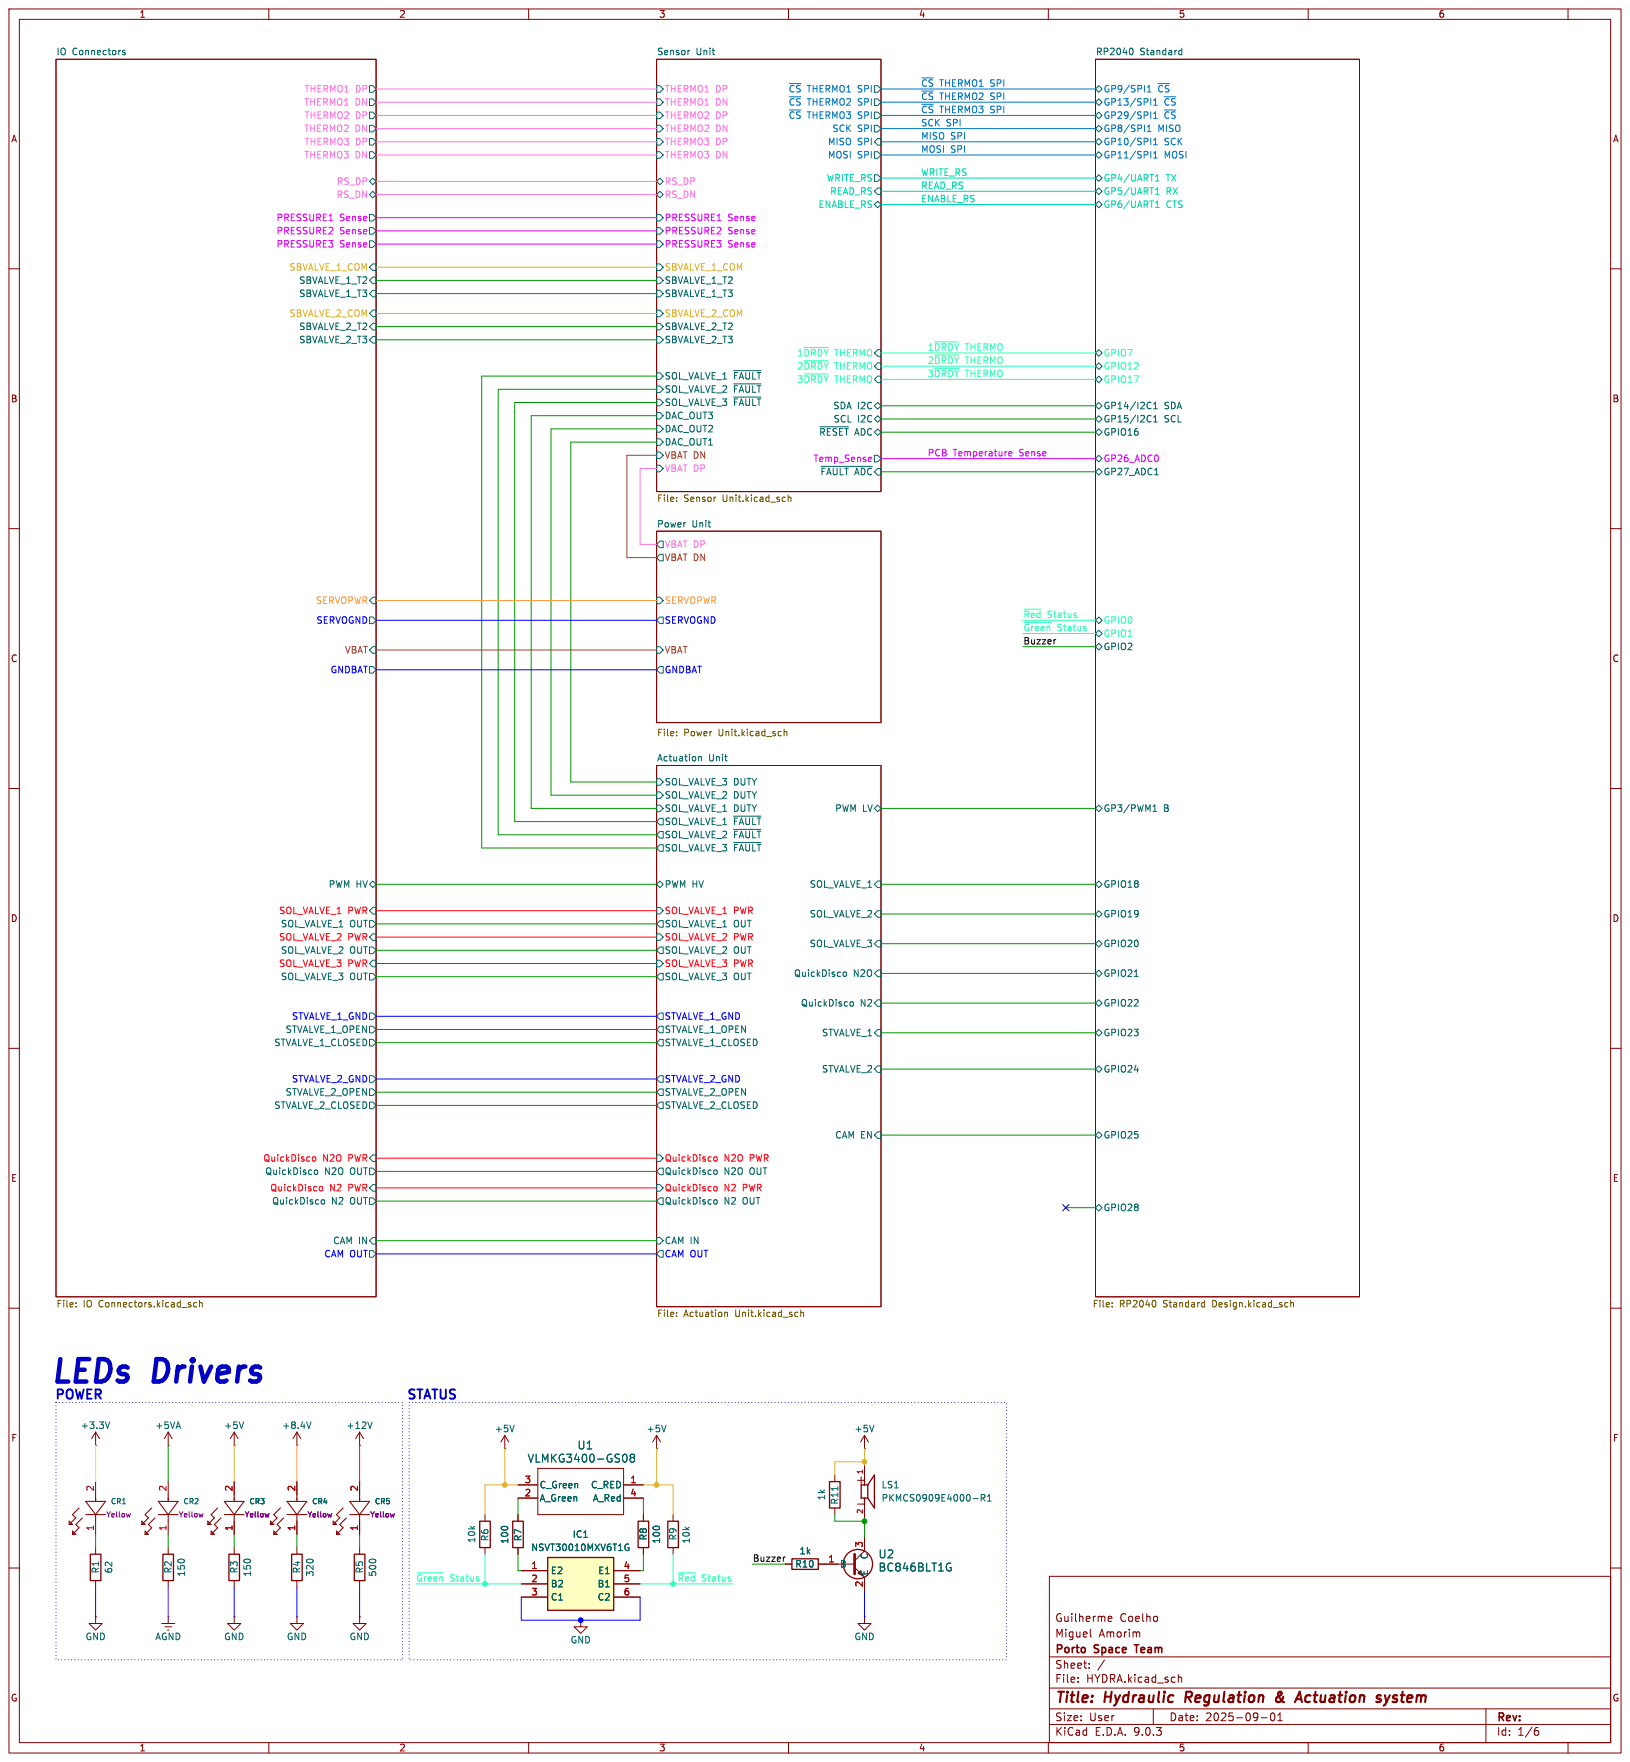
[picture p45: page 1]

SCK SPI 1~{DRDY}THERMO
~{Green}Status Buzzer WRITE_RS
SBVALVE_2_T2 SBVALVE_2_T3 SOL_VALVE_1 ~{FAULT} SOL_VALVE_2 ~{FAULT} SOL_VALVE_3 ~{FAULT} DAC_OUT1 RS_DP RS_DN

RP2040 Standard
~{CS}THERMO2 SPI ~{CS}THERMO3 SPI MISO SPI SCK SPI ~{CS}THERMO1 SPI 1~{DRDY}THERMO

~{CS}THERMO1 SPI THERMO3 DP
~{CS}THERMO2 SPI 3~{DRDY}THERMO MOSI SPI MISO SPI ~{CS}THERMO3 SPI THERMO1 DN
THERMO2 DP
THERMO2 DN

VBAT DP
VBAT GNDBAT VBAT DN

Id: 1/6 Title: Hydraulic Regulation & Actuation system

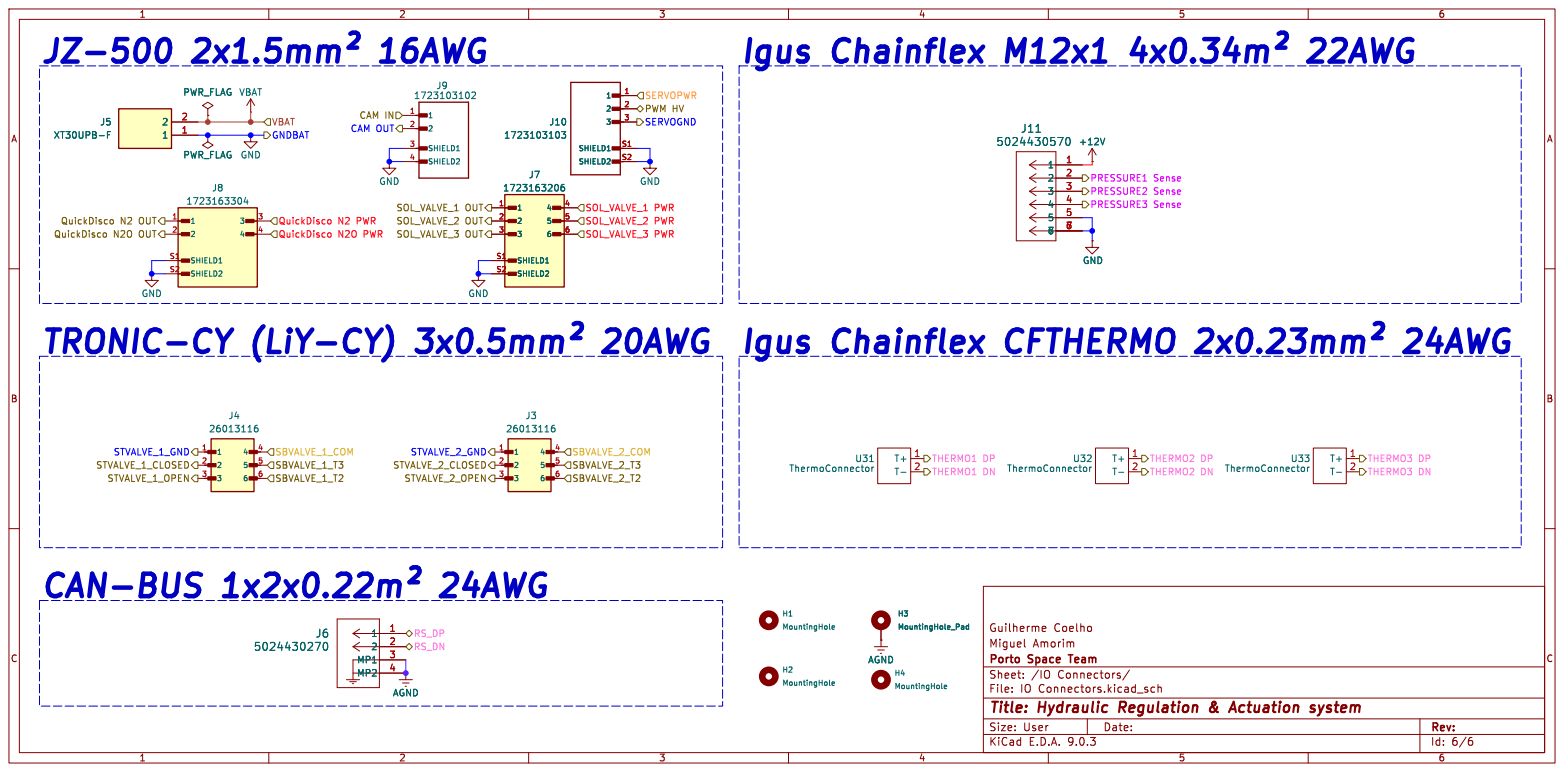
[picture p46: page 2]

Igus Chainflex CFTHERMO þÿ2x0.23mm² 24AWG

Id: 6/6 Title: Hydraulic Regulation & Actuation system

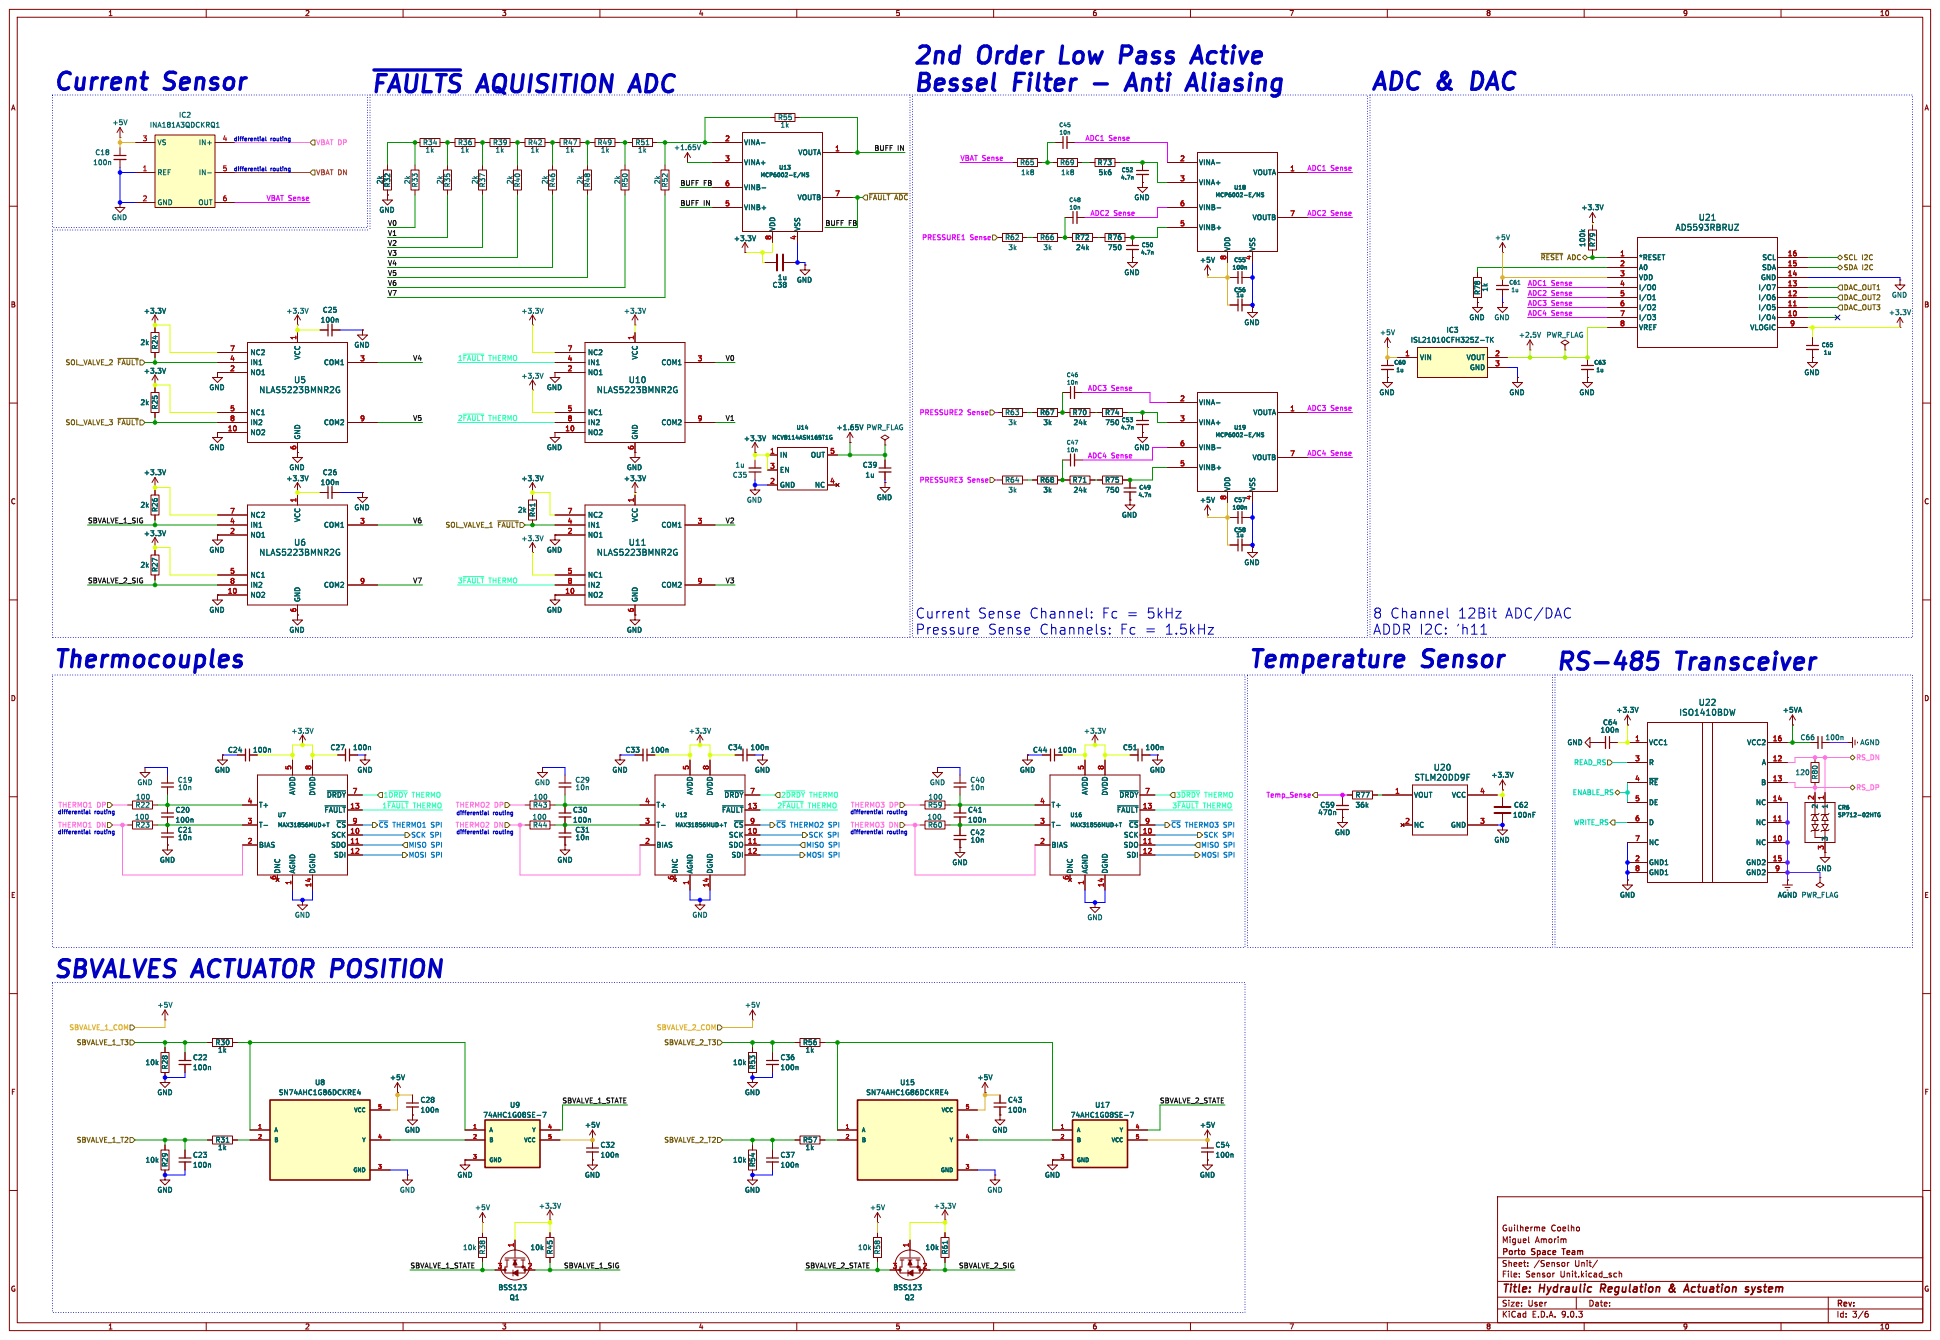
[picture p47: page 3]

2nd Order Low Pass Active
Bessel Filter - Anti Aliasing

ADC1 Sense ADC4 Sense BUFF FB

4 VOUTA 1 VOUTB 7 U18 MCP6002-E/MS GND

Current Sense Channel: Fc = 5kHz
Pressure Sense Channels: Fc = 1.5kHz

~{DRDY}7 ~{FAULT}13 ~{CS}9 SCK 10 SDO 11 SDI 12 U7 MAX31856MUD+T C20

~{DRDY}7 ~{FAULT}13 ~{CS}9 SCK 10 SDO 11 SDI 12 C20

~{DRDY}7 ~{FAULT}13 ~{CS}9 SCK 10 SDO 11 SDI 12 C31

6 AVDD
~{DRDY}7 ~{FAULT}13 ~{CS}9 SCK 10 SDO 11 SDI 12 U12 MAX31856MUD+T

~{DRDY}7 ~{FAULT}13 ~{CS}9 SCK 10 SDO 11 SDI 12 U16 MAX31856MUD+T

3~{DRDY}THERMO MISO SPI THERMO1 DN

Id: 3/6 Title: Hydraulic Regulation & Actuation system

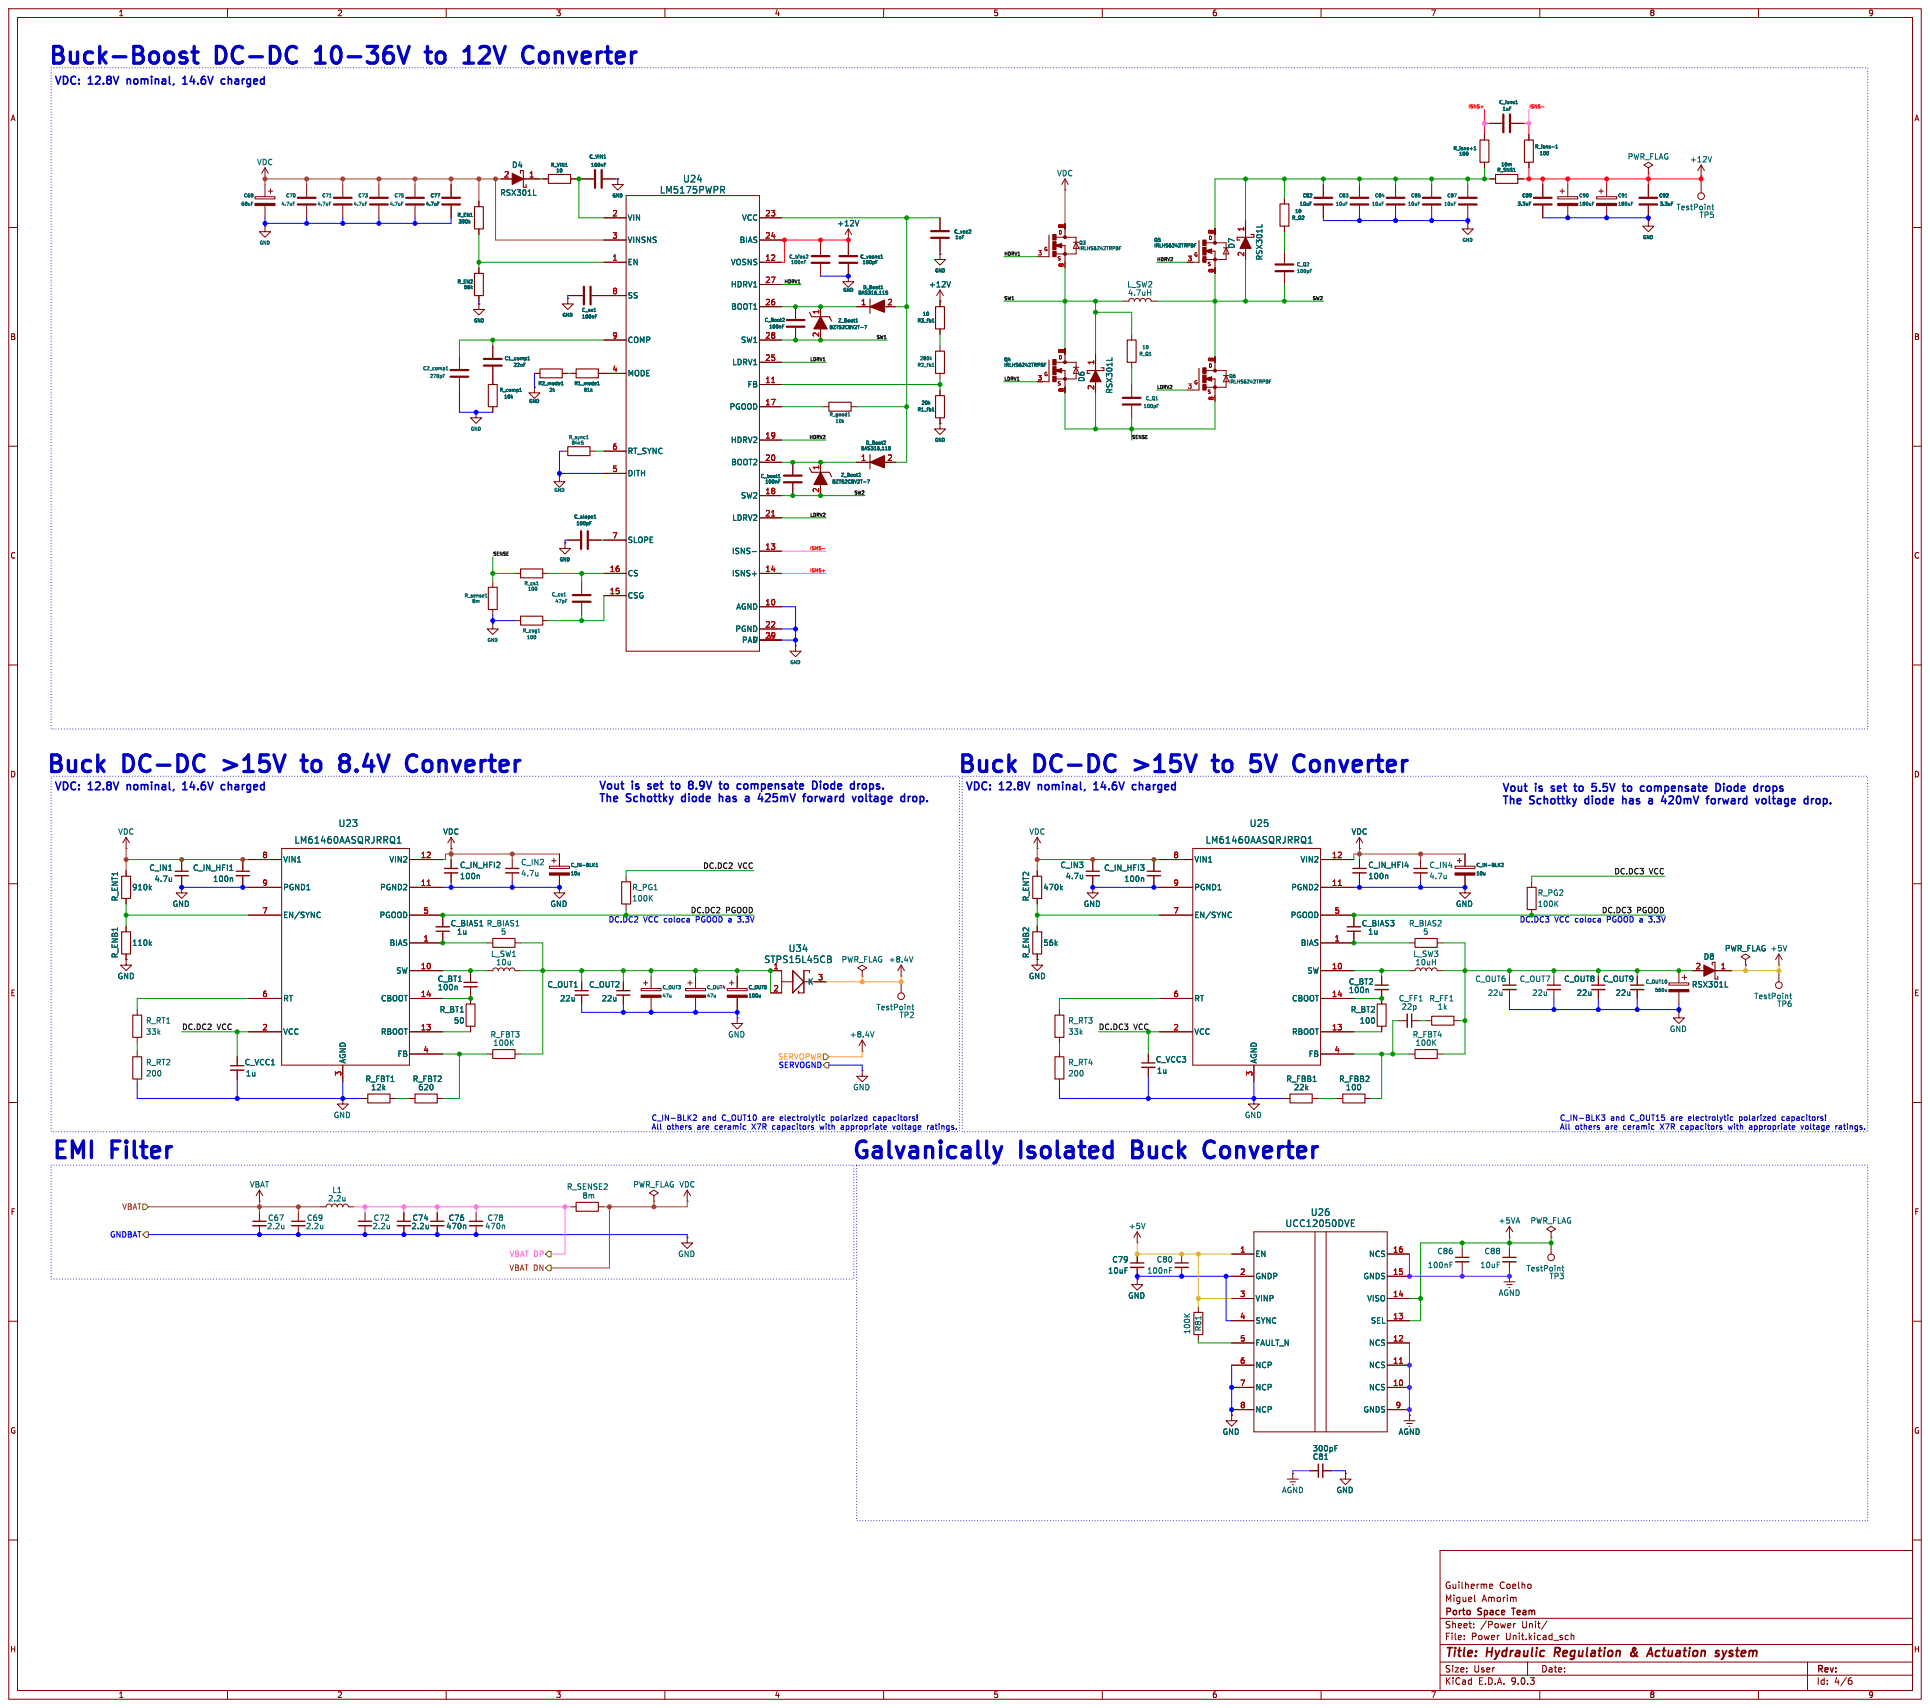
[picture p48: page 4]

Vout is set to 8.9V to compensate Diode drops.
The Schottky diode has a 425mV forward voltage drop.

Vout is set to 5.5V to compensate Diode drops
The Schottky diode has a 420mV forward voltage drop. C_OUT8

Id: 4/6 Title: Hydraulic Regulation & Actuation system

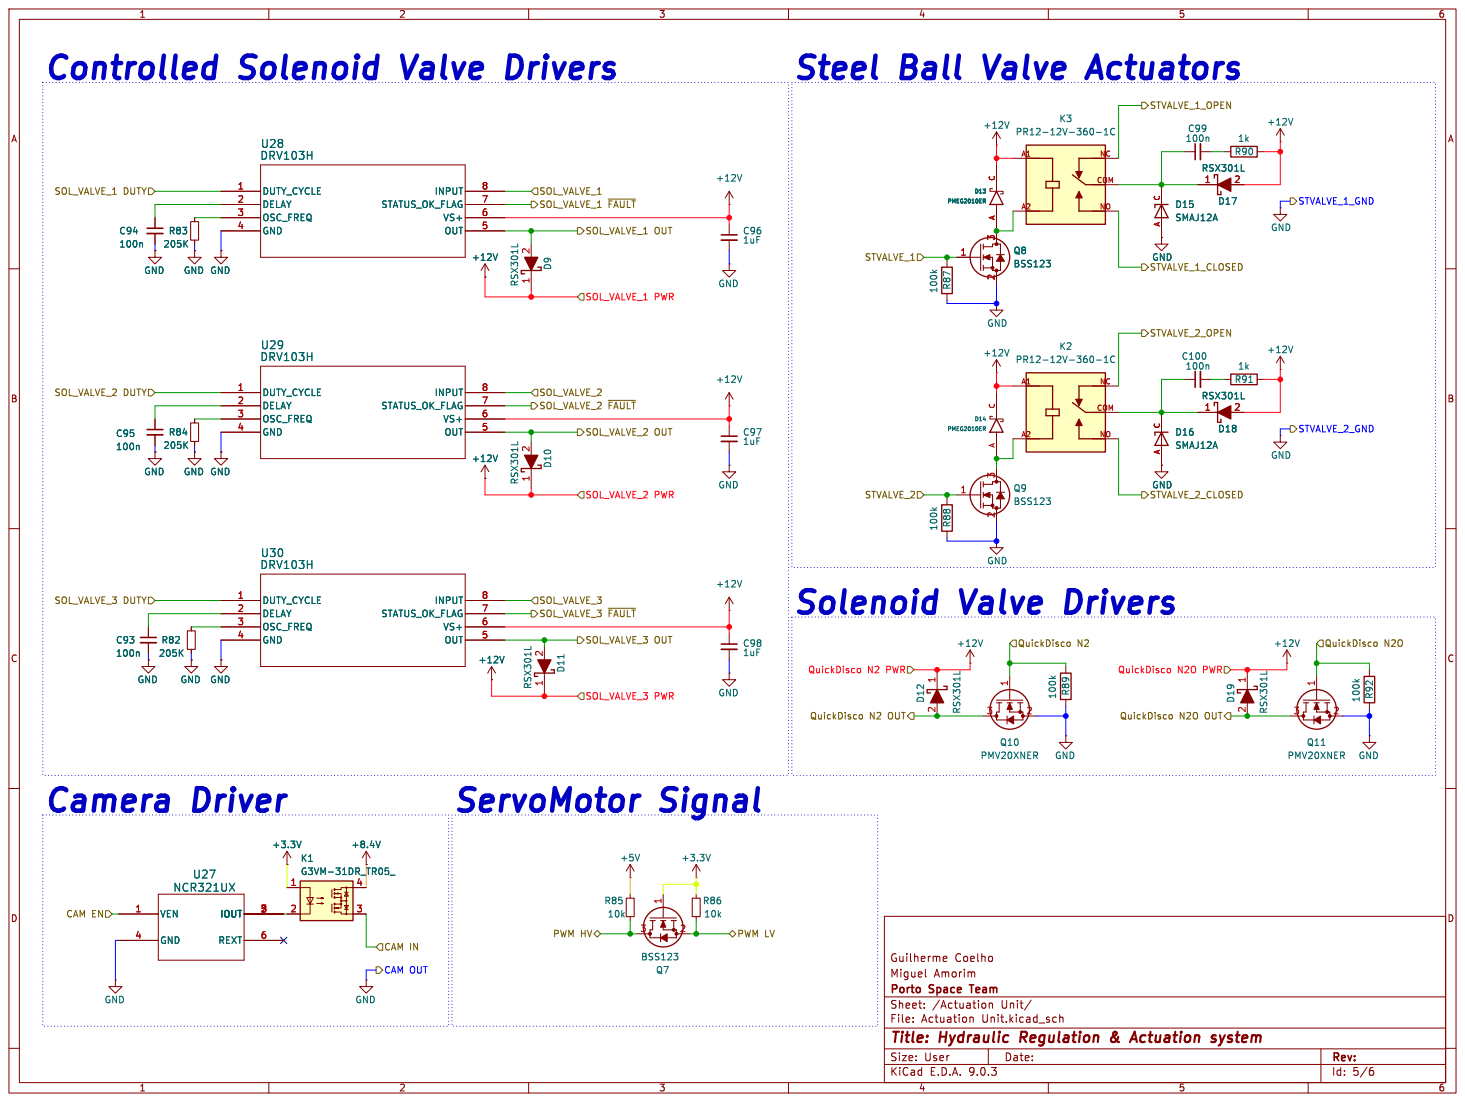
[picture p49: page 5]

PWM HV CAM IN

Id: 5/6 Title: Hydraulic Regulation & Actuation system

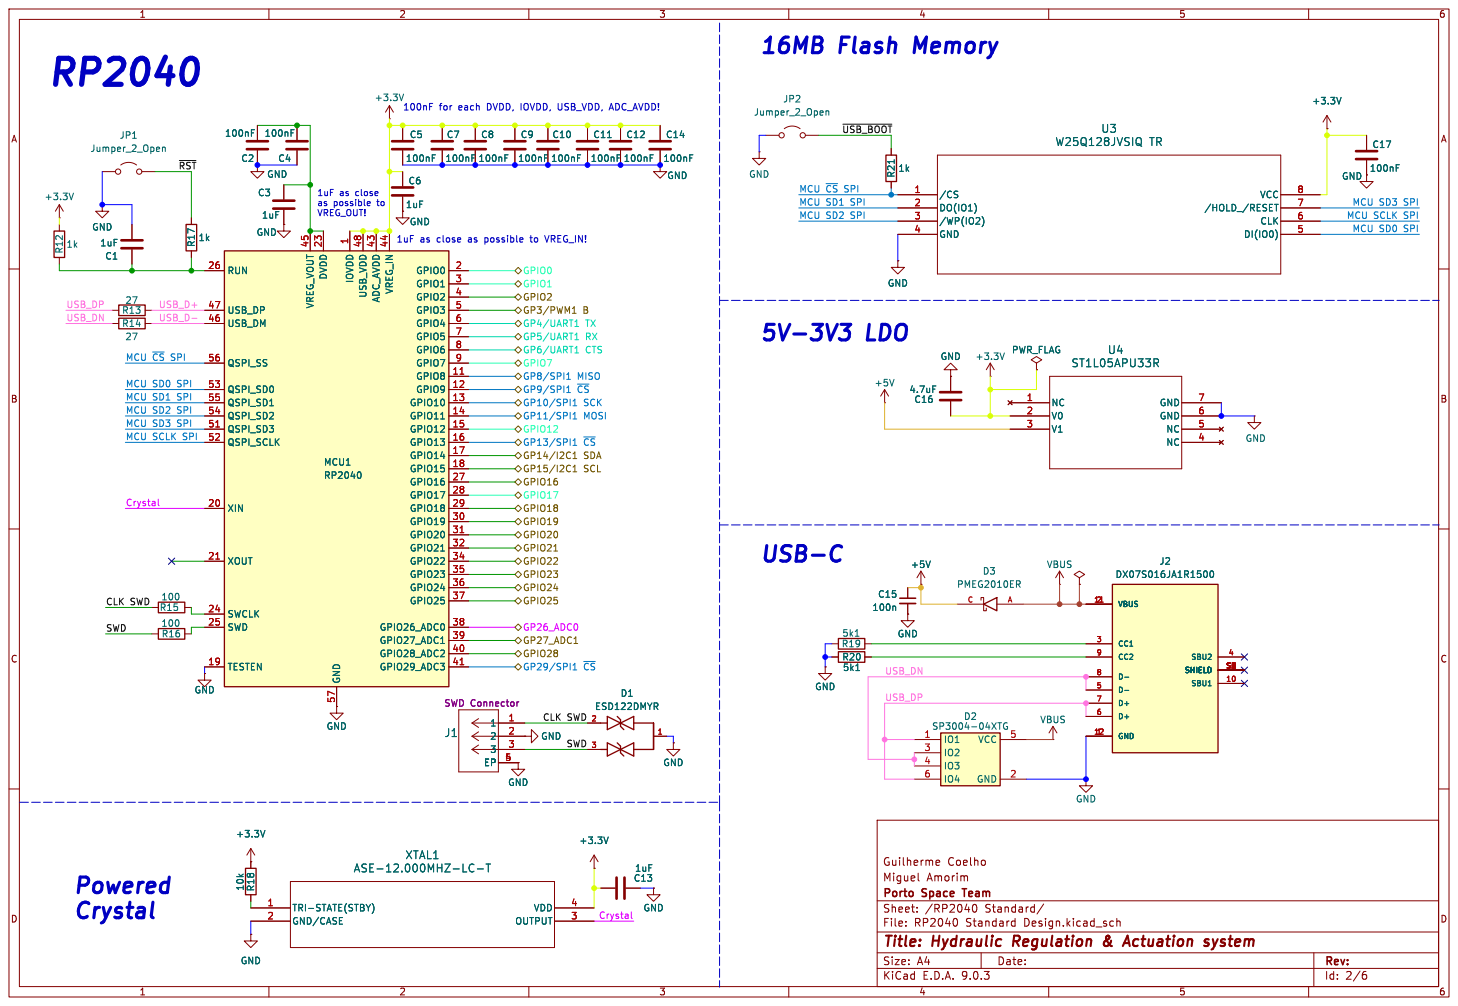
[picture p50: page 6]

Id: 2/6 Title: Hydraulic Regulation & Actuation system
