FilipaRibeiro2020/Invictus2.0_Hardware/Boards/Rocket Systems/HYDRA/HYDRA.kicad_pcb

## KiCad design Boards/Rocket Systems/HYDRA/HYDRA.kicad_pcb (2025-10-10)

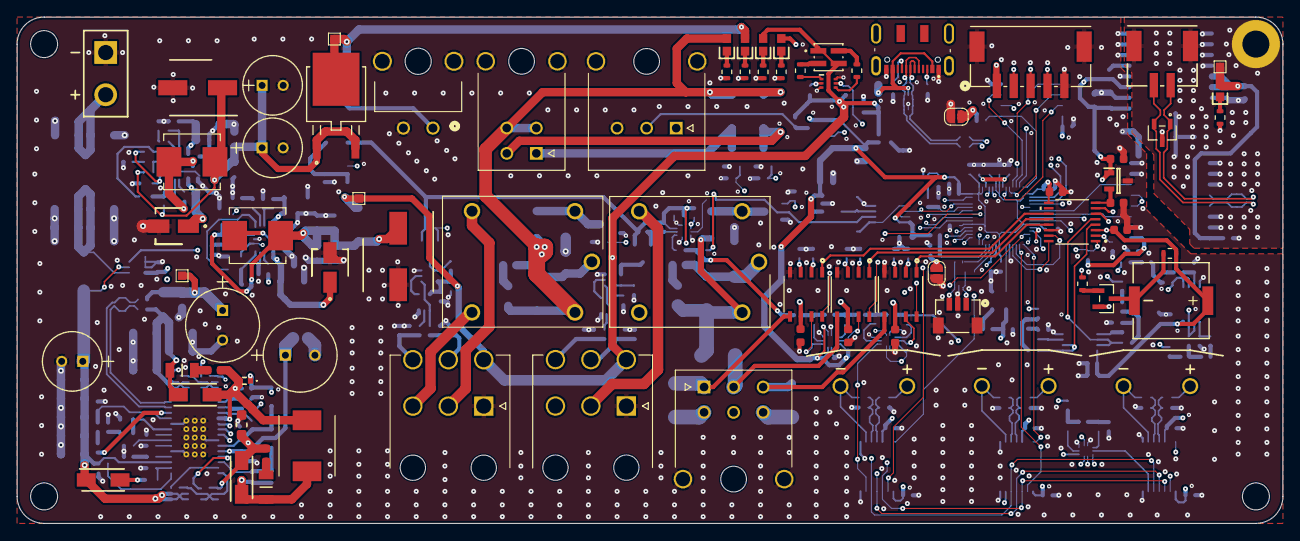
[picture p51: board HYDRA.kicad_pcb from above]

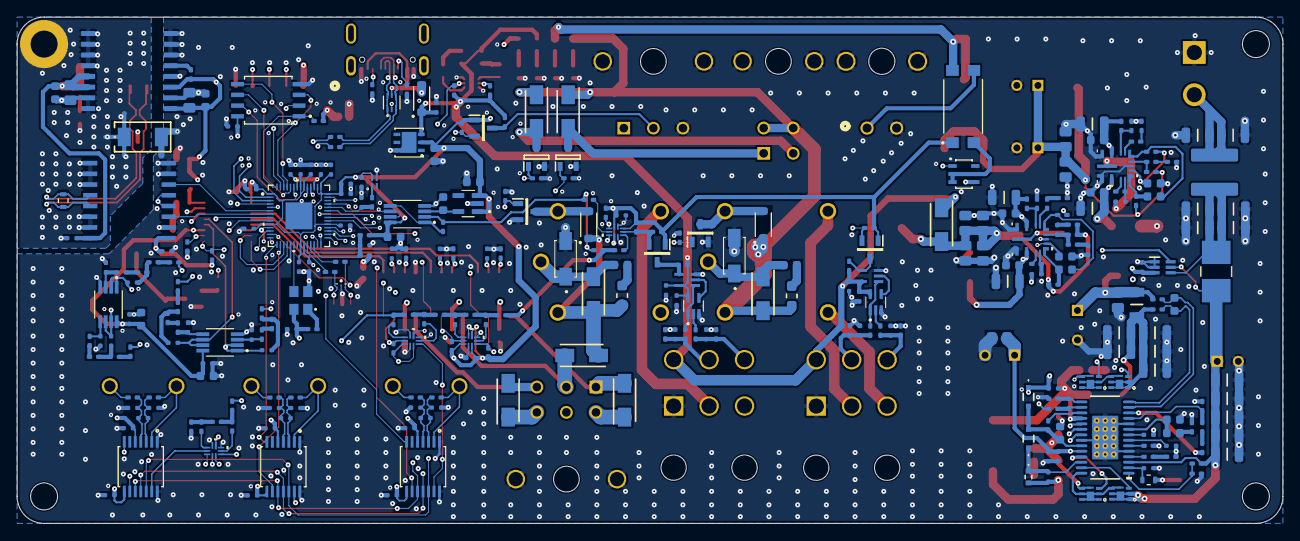
[picture p52: board HYDRA.kicad_pcb from below]

Board: 6 copper layers, 150.0 x 60.0 mm, 381 parts (302 on the bottom side), 234 nets.

Parts:
C1, C3, C6, C13: 1uF; Capacitor_0402
C1_comp1: 22nF; Capacitor_0603
C2, C4, C5, C7, C8, C9, C10, C11, C12, C14, C17, C62: 100nF; Capacitor_0402
C2_comp1: 270pF; Capacitor_0603
C15, C18, C20, C22, C23, C24, C25, C26, C27, C28, C30, C32, C33, C34, C36, C37, C41, C43, C44, C51, C54, C55, C57, C64, C66, C93, C94, C95: 100n; Capacitor_0402
C16: 4.7uF; Capacitor_0603
C19, C21, C29, C31, C40, C42, C45, C46, C47, C48: 10n; Capacitor_0402
C35, C38, C39, C56, C58, C60, C61, C63, C65: 1u; Capacitor_0603
C49, C50, C52, C53: 4.7n; Capacitor_0402
C59: 470n; Capacitor_0402
C67, C69, C72, C74: 2.2u; Capacitor_1206
C68: 68uF; CAP_WCAP-ATG8_6.3x11_WRE
C70, C71, C73, C75, C77: 4.7uF; Capacitor_1206
C76, C78: 470n; Capacitor_1206
C79, C88: 10uF; Capacitor_0805
C80, C86: 100nF; Capacitor_0603
C81: 300pF; C1808
C82, C83, C84, C85, C87: 10uF; Capacitor_1206
C89, C92: 3.3uF; Capacitor_0805
C90, C91: 180uF; CAP_WCAP-ATG8_8x11.5_WRE
C96, C97, C98: 1uF; Capacitor_0603
C99, C100: 100n; Capacitor_0603
CR1, CR2, CR3, CR4, CR5: VLMY1300-GS08; LEDC1608X100N
CR6: SP712-02HTG; SOT23-3_LTF
C_BIAS1, C_BIAS3: 1u; Capacitor_0603
C_BT1, C_BT2: 100n; Capacitor_0402
C_Boot2: 100nF; Capacitor_0402
C_FF1: 22p; Capacitor_0402
C_IN1, C_IN2, C_IN3, C_IN4: 4.7u; Capacitor_1206
C_IN-BLK1, C_IN-BLK2: 10u; Capacitor_4mm
C_IN_HFI1, C_IN_HFI2, C_IN_HFI3, C_IN_HFI4: 100n; Capacitor_0603
C_OUT1, C_OUT2, C_OUT6, C_OUT7, C_OUT8, C_OUT9: 22u; Capacitor_0805
C_OUT3, C_OUT4: 47u; CAP_WCAP-ATG8_6.3x11_WRE
C_OUT5: 100u; Capacitor-6.3mm
C_OUT10: 560u; Capacitor_8mm
C_Q1, C_Q2: 100pF; Capacitor_0603
C_VCC1, C_VCC3: 1u; Capacitor_0603
C_VIN1: 100nF; Capacitor_0402
C_bias2: 100nF; Capacitor_0402
C_boot1: 100nF; Capacitor_0402
C_cs1: 47pF; Capacitor_0402
C_isns1: 1uF; Capacitor_0603
C_slope1: 100pF; Capacitor_0402
C_ss1: 100nF; Capacitor_0402
C_vcc2: 1uF; Capacitor_0603
C_vosns1: 100pF; Capacitor_0402
D1: ESD122DMYR; DIO_ESD122DMYR
D2: SP3004-04XTG; SOT563_LTF
D3, D13, D14: PMEG2010ER; SODFL3517X110N
D4, D6, D7, D8, D9, D10, D11, D12, D17, D18, D19: RSX301L; DIOM5026X220N
D15, D16: SMAJ12A; DIOM4325X250N
D_Boot1, D_Boot2: BAS316,115; BAS316115
H1, H2, H4: MountingHole; MountingHole_3.2mm_M3_ISO7380
H3: MountingHole_Pad; MountingHole_3.2mm_M3_ISO7380_Pad
IC1: NSVT30010MXV6T1G; SOTFL50P160X60-6N
IC2: INA181A3QDCKRQ1; SOT65P210X110-6N
IC3: ISL21010CFH325Z-TK; SOT95P237X112-3N
J1: BM03B-SRSS-TBLFSN; CONN_BM03B-SRSS-TBLFSN_JST
J2: DX07S016JA1R1500; JAE_DX07S016JA1R1500
J3, J4: 26013116; MOLEX_26013116
J5: XT30UPB-F; XT30UPBF
J6: 5024430270; CONN_502443-02xx_MOL
J7: 1723163206; MOLEX_1723163206
J8: 1723163304; MOLEX_1723163304
J9: 1723103102; CONN02_1723103102_MOL
J10: 1723103103; MOLEX_1723103103
J11: 5024430570; CONN_502443-05xx_MOL
JP1, JP2: Jumper_2_Open; SolderJumper-2_P1.3mm_Open_RoundedPad1.0x1.5mm
K1: G3VM-31DR_TR05_; G3VM31DRTR05
K2, K3: PR12-12V-360-1C; RELAY_PR12-12V-360-1C
L1: 2.2u; SRP6030CA-2R2M
LS1: PKMCS0909E4000-R1; SPKR_PKMCS0909E4000-R1
L_SW1: 10u; Inductor-7.3mm-10u
L_SW2: 4.7uH; Inductor-7.2mm-4u7
L_SW3: 10uH; Inductor-7.3mm-10u
MCU1: RP2040; QFN56_7X7_RPI
Q1, Q2, Q7, Q8, Q9: BSS123; SOT96P237X111-3N
Q3, Q4, Q5, Q6: IRLHS6242TRPBF; QFN65P200X200X100-8N
Q10, Q11: PMV20XNER; SOT95P230X110-3N
R1: 62; RES_0603
R1_fb1: 20k; RES_0402
R1_mode1: 91k; RES_0402
R2, R3: 150; RES_0603
R2_fb1: 280k; RES_0402
R2_mode1, R24, R25, R26, R27, R32, R33, R35, R37, R40, R41, R46, R48, R50, R52: 2k; RES_0402
R3_fb1: 10; RES_0402
R4: 320; RES_0603
R5: 500; RES_0603
R6, R9, R18, R28, R29, R38, R45, R53, R54, R58, R61, R85, R86: 10k; RES_0402
R7, R8: 100; RES_0603
R10, R11: 1k; RES_0603
R12, R17, R21, R30, R31, R34, R36, R39, R42, R47, R49, R51, R55, R56, R57, R78: 1k; RES_0402
R13, R14: 27; RES_0402
R15, R16, R22, R23, R43, R44, R59, R60: 100; RES_0402
R19, R20: 5k1; RES_0402
R62, R63, R64, R66, R67, R68: 3k; RES_0402
R65, R69: 1k8; RES_0402
R70, R71, R72: 24k; RES_0402
R73: 5k6; RES_0402
R74, R75, R76: 750; RES_0402
R77: 36k; RES_0402
R79, R87, R88, R89, R92: 100k; RES_0402
R80: 120; RES_0603
R81: 100K; RES_0402
R82, R83, R84: 205K; RES_0402
R90, R91: 1k; RES_0805
R_BIAS1, R_BIAS2: 5; RES_0402
R_BT1: 50; RES_0402
R_BT2: 100; RES_0402
R_EN1: 390k; RES_0402
R_EN2: 56k; RES_0402
R_ENB1: 110k; RES_0402
R_ENB2: 56k; RES_0402
R_ENT1: 910k; RES_0402
R_ENT2: 470k; RES_0402
R_FBB1: 22k; RES_0402
R_FBB2: 100; RES_0402
R_FBT1: 12k; RES_0402
R_FBT2: 620; RES_0402
R_FBT3, R_FBT4: 100K; RES_0402
R_FF1: 1k; RES_0402
R_PG1, R_PG2: 100K; RES_0402
R_Q1, R_Q2: 10; RES_1206
R_RT1, R_RT3: 33k; RES_0402
R_RT2, R_RT4: 200; RES_0402
R_SENSE2: 8m; RES_2512
R_SNS1: 10m; RES_1206
R_VIN1: 10; RES_0603
R_comp1: 10k; RES_0402
R_cs1: 100; RES_0402
R_csg1: 100; RES_0402
R_good1: 10k; RES_0402
R_isns+1: 100; RES_0402
R_isns-1: 100; RES_0402
R_sense1: 8m; RES_0805
R_sync1: 84k5; RES_0402
TP2, TP3, TP5, TP6: TestPoint; TestPoint_Pad_1.0x1.0mm
U1: VLMKG3400-GS08; SMT_00-GS08_VIS
U2: BC846BLT1G; SOT-23_ONS
U3: W25Q128JVSIQ TR; SOIC_208MIL_WIN
U4: ST1L05APU33R; DFN_5APU33R_STM
U5, U6, U10, U11: NLAS5223BMNR2G; WQFN10_1P4X1P8_ONS
U7, U12, U16: MAX31856MUD+T; 21-0066J_14_MXM
U8, U15: SN74AHC1G86DCKRE4; SOT65P210X110-5N
U9, U17: 74AHC1G08SE-7; SOT65P210X110-5N
U13, U18, U19: MCP6002-E/MS; MSOP8_MC_MCH
U14: NCV8114ASN165T1G; SOT95P275X120-5N
U20: STLM20DD9F; UDFN-4L_STM
U21: AD5593RBRUZ; RU-16_ADI-L
U22: ISO1410BDW; DW0016B_L
U23, U25: LM61460AASQRJRRQ1; VQFN-HR14_RJR_TEX
U24: LM5175PWPR; PWP0028F_L
U26: UCC12050DVE; DVE0016A
U27: NCR321UX; TSOP6_SOT457_NEX
U28, U29, U30: DRV103H; DDA8-L
U31, U32, U33: ThermoConnector; Thermo Type K PCB Connector
U34: STPS15L45CB; DPAK_STM
XTAL1: ASE-12.000MHZ-LC-T; ASE24576MHZLCT
Z_Boot1, Z_Boot2: BZT52C8V2T-7; BZT52C8V2T7

Connections:
+1.65V: C39.1, U13.3 (VINA+), U14.5 (OUT)
+2.5V: C63.1, IC3.2 (VOUT), U21.8 (VREF)
+3.3V: C5.1, C6.1, C7.1, C8.1, C9.1, C10.1, C11.1, C12.1, C13.1, C14.1, C16.2, C17.1, C24.1, C25.1, C26.1, C27.2, C33.1, C34.2, C35.2, C38.1, C44.1, C51.2, C62.1, C64.1, C65.1, CR1.2, K1.1, MCU1.1 (IOVDD), MCU1.10 (IOVDD), MCU1.22 (IOVDD), MCU1.33 (IOVDD), MCU1.42 (IOVDD), MCU1.43 (ADC_AVDD), MCU1.44 (VREG_IN), MCU1.48 (USB_VDD), MCU1.49 (IOVDD), Q1.1 (G), Q2.1 (G), Q7.1 (G), R12.1, R18.2, R24.1, R25.1, R26.1, R27.1, R41.1, R45.1, R61.1, R79.1, R86.1, U3.8 (VCC), U4.2 (V0), U5.1 (VCC), U5.5 (NC1), U5.7 (NC2), U6.1 (VCC), U6.5 (NC1), U6.7 (NC2), U7.5 (AVDD), U7.8 (DVDD), U10.1 (VCC), U10.5 (NC1), U10.7 (NC2), U11.1 (VCC), U11.5 (NC1), U11.7 (NC2), U12.5 (AVDD), U12.8 (DVDD), U13.8 (VDD), U14.1 (IN), U14.3 (EN), U16.5 (AVDD), U16.8 (DVDD), U20.4 (VCC), U21.9 (VLOGIC), U22.1 (VCC1), XTAL1.4 (VDD)
+5V: C15.1, C18.1, C28.1, C32.1, C43.1, C54.1, C55.2, C56.1, C57.2, C58.1, C60.1, C61.1, C79.1, C80.1, CR3.2, D3.C, D8.1 (K), IC2.3 (VS), IC3.1 (VIN), J3.4, J4.4, LS1.1, R6.1, R9.2, R11.1, R38.1, R58.1, R81.1, R85.1, TP6.1, U1.1 (C_RED), U1.3 (C_Green), U4.3 (V1), U8.5 (VCC), U9.5 (VCC), U15.5 (VCC), U17.5 (VCC), U18.8 (VDD), U19.8 (VDD), U21.3 (VDD), U26.1 (EN), U26.3 (VINP)
+5VA: C66.2, C86.1, C88.1, CR2.2, TP3.1, U22.16 (VCC2), U26.13 (SEL), U26.14 (VISO)
+8.4V: CR4.2, J10.1, K1.4, TP2.1, U34.3 (K)
+12V: C89.2, C90.1, C91.1, C92.2, C96.1, C97.1, C98.1, CR5.2, C_bias2.1, C_vosns1.1, D9.1 (K), D10.1 (K), D11.1 (K), D12.1 (K), D13.C, D14.C, D17.2 (A), D18.2 (A), D19.1 (K), J7.4, J7.5, J7.6, J8.3, J8.4, J11.1, K2.A1, K3.A1, R3_fb1.1, R90.1, R91.1, R_SNS1.2, R_isns-1.1, TP5.1, U24.12 (VOSNS), U24.24 (BIAS), U28.6 (VS+), U29.6 (VS+), U30.6 (VS+)
/1~DRDY THERMO: MCU1.9 (GPIO7), U7.7 (~DRDY)
/2~DRDY THERMO: MCU1.15 (GPIO12), U12.7 (~DRDY)
/3~DRDY THERMO: MCU1.28 (GPIO17), U16.7 (~DRDY)
/Actuation Unit/CAM EN: MCU1.37 (GPIO25), U27.1 (VEN)
/Actuation Unit/CAM IN: J9.1, K1.3
/Actuation Unit/PWM HV: J10.2, Q7.3 (D), R85.2
/Actuation Unit/PWM LV: MCU1.5 (GPIO3), Q7.2 (S), R86.2
/Actuation Unit/QuickDisco N2: MCU1.34 (GPIO22), Q10.1 (G), R89.1
/Actuation Unit/QuickDisco N2 OUT: D12.2 (A), J8.1, Q10.3 (D)
/Actuation Unit/QuickDisco N2O: MCU1.32 (GPIO21), Q11.1 (G), R92.1
/Actuation Unit/QuickDisco N2O OUT: D19.2 (A), J8.2, Q11.3 (D)
/Actuation Unit/SOL_VALVE_1: MCU1.29 (GPIO18), U28.8 (INPUT)
/Actuation Unit/SOL_VALVE_1 DUTY: U21.11 (I/O5), U28.1 (DUTY_CYCLE)
/Actuation Unit/SOL_VALVE_1 OUT: D9.2 (A), J7.1, U28.5 (OUT)
/Actuation Unit/SOL_VALVE_1 ~FAULT: R25.2, U5.8 (IN2), U28.7 (STATUS_OK_FLAG)
/Actuation Unit/SOL_VALVE_2: MCU1.30 (GPIO19), U29.8 (INPUT)
/Actuation Unit/SOL_VALVE_2 DUTY: U21.12 (I/O6), U29.1 (DUTY_CYCLE)
/Actuation Unit/SOL_VALVE_2 OUT: D10.2 (A), J7.2, U29.5 (OUT)
/Actuation Unit/SOL_VALVE_2 ~FAULT: R24.2, U5.4 (IN1), U29.7 (STATUS_OK_FLAG)
/Actuation Unit/SOL_VALVE_3: MCU1.31 (GPIO20), U30.8 (INPUT)
/Actuation Unit/SOL_VALVE_3 DUTY: U21.13 (I/O7), U30.1 (DUTY_CYCLE)
/Actuation Unit/SOL_VALVE_3 OUT: D11.2 (A), J7.3, U30.5 (OUT)
/Actuation Unit/SOL_VALVE_3 ~FAULT: R41.2, U11.4 (IN1), U30.7 (STATUS_OK_FLAG)
/Actuation Unit/STVALVE_1: MCU1.35 (GPIO23), Q8.1 (G), R87.1
/Actuation Unit/STVALVE_1_CLOSED: J4.2, K3.NO
/Actuation Unit/STVALVE_1_OPEN: J4.3, K3.NC
/Actuation Unit/STVALVE_2: MCU1.36 (GPIO24), Q9.1 (G), R88.1
/Actuation Unit/STVALVE_2_CLOSED: J3.2, K2.NO
/Actuation Unit/STVALVE_2_OPEN: J3.3, K2.NC
/Buzzer: MCU1.4 (GPIO2), R10.2
/ENABLE_RS: MCU1.8 (GPIO6), U22.4 (~RE), U22.5 (DE)
/IO Connectors/PRESSURE1 Sense: J11.2, R62.1
/IO Connectors/PRESSURE2 Sense: J11.3, R63.1
/IO Connectors/PRESSURE3 Sense: J11.4, R64.1
/IO Connectors/RS_DN: CR6.1, J6.2, R80.1, U22.12 (A)
/IO Connectors/RS_DP: CR6.2, J6.1, R80.2, U22.13 (B)
/IO Connectors/SBVALVE_1_T2: C23.1, J4.6, R29.1, R31.2
/IO Connectors/SBVALVE_1_T3: C22.1, J4.5, R28.1, R30.2
/IO Connectors/SBVALVE_2_T2: C37.1, J3.6, R54.1, R57.2
/IO Connectors/SBVALVE_2_T3: C36.1, J3.5, R53.1, R56.2
/IO Connectors/THERMO1 DN: R23.2, U7.2 (BIAS), U31.2 (T-)
/IO Connectors/THERMO1 DP: R22.2, U31.1 (T+)
/IO Connectors/THERMO2 DN: R44.2, U12.2 (BIAS), U32.2 (T-)
/IO Connectors/THERMO2 DP: R43.2, U32.1 (T+)
/IO Connectors/THERMO3 DN: R60.2, U16.2 (BIAS), U33.2 (T-)
/IO Connectors/THERMO3 DP: R59.2, U33.1 (T+)
/MISO SPI: MCU1.11 (GPIO8), U7.11 (SDO), U12.11 (SDO), U16.11 (SDO)
/MOSI SPI: MCU1.14 (GPIO11), U7.12 (SDI), U12.12 (SDI), U16.12 (SDI)
/PCB Temperature Sense: C59.2, MCU1.38 (GPIO26_ADC0), R77.1
/Power Unit/DC.DC2 PGOOD: C_BIAS1.2, R_PG1.2, U23.5 (PGOOD)
/Power Unit/DC.DC2 VCC: C_VCC1.1, R_PG1.1, U23.2 (VCC)
/Power Unit/DC.DC3 PGOOD: C_BIAS3.2, R_PG2.2, U25.5 (PGOOD)
/Power Unit/DC.DC3 VCC: C_VCC3.1, R_PG2.1, U25.2 (VCC)
/Power Unit/HDRV1: Q3.3, U24.27 (HDRV1)
/Power Unit/HDRV2: Q5.3, U24.19 (HDRV2)
/Power Unit/ISNS+: C_isns1.2, R_isns+1.2, U24.14 (ISNS+)
/Power Unit/ISNS-: C_isns1.1, R_isns-1.2, U24.13 (ISNS-)
/Power Unit/LDRV1: Q4.3, U24.25 (LDRV1)
/Power Unit/LDRV2: Q6.3, U24.21 (LDRV2)
/Power Unit/SENSE: C_Q1.2, D6.2 (A), Q4.4, Q4.8, Q6.4, Q6.8, R_cs1.1, R_sense1.2
/Power Unit/SW1: C_Boot2.2, D6.1 (K), L_SW2.1, Q3.4, Q3.8, Q4.1, Q4.2, Q4.5, Q4.6, Q4.7, R_Q1.1, U24.28 (SW1), Z_Boot1.2 (A)
/Power Unit/SW2: C_Q2.2, C_boot1.2, D7.2 (A), L_SW2.2, Q5.4, Q5.8, Q6.1, Q6.2, Q6.5, Q6.6, Q6.7, U24.18 (SW2), Z_Boot2.2 (A)
/Power Unit/VBAT DP: C72.1, C74.1, C76.1, C78.1, IC2.4 (IN+), L1.2, R_SENSE2.1
/READ_RS: MCU1.7 (GPIO5), U22.3 (R)
/RP2040 Standard/CLK SWD: D1.2, J1.1, R15.1
/RP2040 Standard/Crystal: MCU1.20 (XIN), XTAL1.3 (OUTPUT)
/RP2040 Standard/GP14/I2C1 SDA: MCU1.17 (GPIO14), U21.15 (SDA)
/RP2040 Standard/GP15/I2C1 SCL: MCU1.18 (GPIO15), U21.16 (SCL)
/RP2040 Standard/GPIO16: MCU1.27 (GPIO16), R79.2, U21.1 (*RESET)
/RP2040 Standard/MCU SCLK SPI: MCU1.52 (QSPI_SCLK), U3.6 (CLK)
/RP2040 Standard/MCU SD0 SPI: MCU1.53 (QSPI_SD0), U3.5 (DI(IO0))
/RP2040 Standard/MCU SD1 SPI: MCU1.55 (QSPI_SD1), U3.2 (DO(IO1))
/RP2040 Standard/MCU SD2 SPI: MCU1.54 (QSPI_SD2), U3.3 (/WP(IO2))
/RP2040 Standard/MCU SD3 SPI: MCU1.51 (QSPI_SD3), U3.7 (/HOLD_/RESET)
/RP2040 Standard/MCU ~CS SPI: MCU1.56 (QSPI_SS), R21.2, U3.1 (/CS)
/RP2040 Standard/SWD: D1.3, J1.3, R16.1
/RP2040 Standard/USB_D+: MCU1.47 (USB_DP), R13.2
/RP2040 Standard/USB_D-: MCU1.46 (USB_DM), R14.2
/RP2040 Standard/USB_DN: D2.3 (IO2), D2.4 (IO3), J2.5 (D-), J2.8 (D-), R14.1
/RP2040 Standard/USB_DP: D2.1 (IO1), D2.6 (IO4), J2.6 (D+), J2.7 (D+), R13.1
/RP2040 Standard/~RST: JP1.2 (B), R17.1
/RP2040 Standard/~USB_BOOT: JP2.2 (B), R21.1
/SCK SPI: MCU1.13 (GPIO10), U7.10 (SCK), U12.10 (SCK), U16.10 (SCK)
/Sensor Unit/1~FAULT THERMO: U7.13 (~FAULT), U10.4 (IN1)
/Sensor Unit/2~FAULT THERMO: U10.8 (IN2), U12.13 (~FAULT)
/Sensor Unit/3~FAULT THERMO: U11.8 (IN2), U16.13 (~FAULT)
/Sensor Unit/ADC1 Sense: C45.2, U18.1 (VOUTA), U18.2 (VINA-), U21.4 (I/O0)
/Sensor Unit/ADC2 Sense: C48.2, U18.6 (VINB-), U18.7 (VOUTB), U21.5 (I/O1)
/Sensor Unit/ADC3 Sense: C46.2, U19.1 (VOUTA), U19.2 (VINA-), U21.6 (I/O2)
/Sensor Unit/ADC4 Sense: C47.2, U19.6 (VINB-), U19.7 (VOUTB), U21.7 (I/O3)
/Sensor Unit/BUFF FB: MCU1.39 (GPIO27_ADC1), U13.6 (VINB-), U13.7 (VOUTB)
/Sensor Unit/BUFF IN: R55.1, U13.1 (VOUTA), U13.5 (VINB+)
/Sensor Unit/SBVALVE_1_SIG: Q1.2 (S), R26.2, R45.2, U6.4 (IN1)
/Sensor Unit/SBVALVE_1_STATE: Q1.3 (D), R38.2, U9.4 (Y)
/Sensor Unit/SBVALVE_2_SIG: Q2.2 (S), R27.2, R61.2, U6.8 (IN2)
/Sensor Unit/SBVALVE_2_STATE: Q2.3 (D), R58.2, U17.4 (Y)
/Sensor Unit/V0: R33.1, U10.3 (COM1)
/Sensor Unit/V1: R35.1, U10.9 (COM2)
/Sensor Unit/V2: R37.1, U11.3 (COM1)
/Sensor Unit/V3: R40.1, U11.9 (COM2)
/Sensor Unit/V4: R46.1, U5.3 (COM1)
/Sensor Unit/V5: R48.1, U5.9 (COM2)
/Sensor Unit/V6: R50.1, U6.3 (COM1)
/Sensor Unit/V7: R52.1, U6.9 (COM2)
/Sensor Unit/VBAT Sense: IC2.6 (OUT), R65.1
/WRITE_RS: MCU1.6 (GPIO4), U22.6 (D)
/~CS THERMO1 SPI: MCU1.12 (GPIO9), U7.9 (~CS)
/~CS THERMO2 SPI: MCU1.16 (GPIO13), U12.9 (~CS)
/~CS THERMO3 SPI: MCU1.41 (GPIO29_ADC3), U16.9 (~CS)
/~Green Status: IC1.2 (B2), MCU1.3 (GPIO1), R6.2
/~Red Status: IC1.5 (B1), MCU1.2 (GPIO0), R9.1
AGND: C66.1, C81.1, C86.2, C88.2, CR6.3, H3.1, J6.3 (MP1), J6.4 (MP2), R2.1, U22.9 (GND2), U22.10 (NC), U22.11 (NC), U22.14 (NC), U22.15 (GND2), U26.9 (GNDS), U26.10 (NCS), U26.11 (NCS), U26.12 (NCS), U26.15 (GNDS), U26.16 (NCS)
GND: C1.2, C2.1, C2_comp1.1, C3.2, C4.1, C5.2, C6.2, C7.2, C8.2, C9.2, C10.2, C11.2, C12.2, C13.2, C14.2, C15.2, C16.1, C17.2, C18.2, C19.1, C21.2, C22.2, C23.2, C24.2, C25.2, C26.2, C27.1, C28.2, C29.1, C31.2, C32.2, C33.2, C34.1, C35.1, C36.2, C37.2, C38.2, C39.2, C40.1, C42.2, C43.2, C44.2, C49.2, C50.2, C51.1, C52.2, C53.2, C54.2, C55.1, C56.2, C57.1, C58.2, C59.1, C60.2, C61.2, C62.2, C63.2, C64.2, C65.2, C67.2, C68.2, C69.2, C70.1, C71.1, C72.2, C73.1, C74.2, C75.1, C76.2, C77.1, C78.2, C79.2, C80.2, C81.2, C82.1, C83.1, C84.1, C85.1, C87.1, C89.1, C90.2, C91.2, C92.1, C93.2, C94.2, C95.2, C96.2, C97.2, C98.2, C_IN1.2, C_IN2.2, C_IN3.2, C_IN4.2, C_IN-BLK1.2, C_IN-BLK2.2, C_IN_HFI1.2, C_IN_HFI2.2, C_IN_HFI3.2, C_IN_HFI4.2, C_OUT1.2, C_OUT2.2, C_OUT3.2, C_OUT4.2, C_OUT5.2, C_OUT6.2, C_OUT7.2, C_OUT8.2, C_OUT9.2, C_OUT10.2, C_VCC1.2, C_VCC3.2, C_VIN1.2, C_bias2.2, C_slope1.2, C_ss1.2, C_vcc2.2, C_vosns1.2, D1.1, D2.2 (GND), D15.A, D16.A, IC1.3 (C1), IC1.6 (C2), IC2.1 (REF), IC2.2 (GND), IC3.3 (GND), J1.2, J1.4 (EP), J1.5 (EP), J2.1 (GND), J2.12 (GND), J3.1, J4.1, J5.1, J7.S1 (SHIELD1), J7.S2 (SHIELD2), J8.S1 (SHIELD1), J8.S2 (SHIELD2), J9.2, J9.3 (SHIELD1), J9.4 (SHIELD2), J10.3, J10.S1 (SHIELD1), J10.S2 (SHIELD2), J11.5, J11.6, J11.7, JP1.1 (A), JP2.1 (A), MCU1.19 (TESTEN), MCU1.57 (GND), Q8.2 (S), Q9.2 (S), Q10.2 (S), Q11.2 (S), R1.1, R1_fb1.2, R2_mode1.1, R3.1, R4.1, R5.1, R19.1, R20.2, R28.2, R29.2, R32.1, R53.2, R54.2, R78.1, R82.2, R83.2, R84.2, R87.2, R88.2, R89.2, R92.2, R_EN2.2, R_ENB1.1, R_ENB2.1, R_FBB1.1, R_FBT1.2, R_RT2.1, R_RT4.1, R_comp1.2, R_csg1.1, R_sense1.1, R_sync1.2, U2.2 (E), U3.4 (GND), U4.6 (GND), U4.7 (GND), U5.2 (NO1), U5.6 (GND), U5.10 (NO2), U6.2 (NO1), U6.6 (GND), U6.10 (NO2), U7.1 (AGND), U7.14 (DGND), U8.3 (GND), U9.3 (GND), U10.2 (NO1), U10.6 (GND), U10.10 (NO2), U11.2 (NO1), U11.6 (GND), U11.10 (NO2), U12.1 (AGND), U12.14 (DGND), U13.4 (VSS), U14.2 (GND), U15.3 (GND), U16.1 (AGND), U16.14 (DGND), U17.3 (GND), U18.4 (VSS), U19.4 (VSS), U20.3 (GND), U21.14 (GND), U22.2 (GND1), U22.7 (NC), U22.8 (GND1), U23.3 (AGND), U23.9 (PGND1), U23.11 (PGND2), U24.5 (DITH), U24.10 (AGND), U24.22 (PGND), U24.29 (PAD), U24.V, U25.3 (AGND), U25.9 (PGND1), U25.11 (PGND2), U26.2 (GNDP), U26.4 (SYNC), U26.6 (NCP), U26.7 (NCP), U26.8 (NCP), U27.4 (GND), U28.4 (GND), U29.4 (GND), U30.4 (GND), XTAL1.2 (GND/CASE)
unnamed: C1_comp1.1, R_comp1.1
unnamed: C45.1, R65.2, R69.1
unnamed: C46.1, R67.2, R70.1
unnamed: C47.1, R68.2, R71.1
unnamed: C48.1, R66.2, R72.1
unnamed: C99.2, R90.2
unnamed: C100.2, R91.2
unnamed: CR1.1, R1.2
unnamed: CR2.1, R2.2
unnamed: CR3.1, R3.2
unnamed: CR4.1, R4.2
unnamed: CR5.1, R5.2
unnamed: C_FF1.1, R_FF1.2
unnamed: C_OUT1.1, C_OUT2.1, C_OUT3.1, C_OUT4.1, C_OUT5.1, L_SW1.2, R_BIAS1.2, R_FBT3.1, U34.1, U34.2
unnamed: C_Q1.1, R_Q1.2
unnamed: C_Q2.1, R_Q2.2
unnamed: D4.2 (A), R_VIN1.1
unnamed: C82.2, C83.2, C84.2, C85.2, C87.2, D7.1 (K), Q5.1, Q5.2, Q5.5, Q5.6, Q5.7, R_Q2.1, R_SNS1.1, R_isns+1.1
unnamed: C_OUT6.1, C_OUT7.1, C_OUT8.1, C_OUT9.1, C_OUT10.1, D8.2 (A), L_SW3.2, R_BIAS2.2, R_FBT4.1, R_FF1.1
unnamed: C99.1, D15.C, D17.1 (K), K3.COM
unnamed: C100.1, D16.C, D18.1 (K), K2.COM
unnamed: C_vcc2.1, D_Boot1.2 (A), D_Boot2.2 (A), R_good1.2, U24.23 (VCC)
unnamed: C_Boot2.1, D_Boot1.1 (K), U24.26 (BOOT1), Z_Boot1.1 (K)
unnamed: C_boot1.1, D_Boot2.1 (K), U24.20 (BOOT2), Z_Boot2.1 (K)
unnamed: IC1.4 (E1), R8.1
unnamed: IC1.1 (E2), R7.2
unnamed: J2.3 (CC1), R19.2
unnamed: J2.9 (CC2), R20.1
unnamed: K1.2, U27.2 (IOUT), U27.3 (IOUT), U27.5 (IOUT)
unnamed: C1.1, MCU1.26 (RUN), R12.2, R17.2
unnamed: MCU1.24 (SWCLK), R15.2
unnamed: MCU1.25 (SWD), R16.2
unnamed: C2.2, C3.1, C4.2, MCU1.23 (DVDD), MCU1.45 (VREG_VOUT), MCU1.50 (DVDD)
unnamed: D13.A, K3.A2, Q8.3 (D)
unnamed: D14.A, K2.A2, Q9.3 (D)
unnamed: R1_mode1.1, R2_mode1.2
unnamed: R2_fb1.1, R3_fb1.2
unnamed: R32.2, R33.2, R34.2
unnamed: R34.1, R35.2, R36.2
unnamed: R36.1, R37.2, R39.2
unnamed: R39.1, R40.2, R42.2
unnamed: R42.1, R46.2, R47.2
unnamed: R47.1, R48.2, R49.1
unnamed: R49.2, R50.2, R51.2
unnamed: R62.2, R66.1
unnamed: R63.2, R67.1
unnamed: R64.2, R68.1
unnamed: R69.2, R73.1
unnamed: R70.2, R74.1
unnamed: R71.2, R75.1
unnamed: R72.2, R76.1
unnamed: R_FBB1.2, R_FBB2.1
unnamed: R_FBT1.1, R_FBT2.2
unnamed: R_RT1.1, R_RT2.2
unnamed: R_RT3.1, R_RT4.2
unnamed: R7.1, U1.2 (A_Green)
unnamed: R8.2, U1.4 (A_Red)
unnamed: R10.1, U2.1 (B)
unnamed: LS1.2, R11.2, U2.3 (C)
unnamed: C19.2, C20.1, R22.1, U7.4 (T+)
unnamed: C20.2, C21.1, R23.1, U7.3 (T-)
unnamed: R30.1, U8.1 (A), U9.1 (A)
unnamed: R31.1, U8.2 (B)
unnamed: U8.4 (Y), U9.2 (B)
unnamed: C29.2, C30.1, R43.1, U12.4 (T+)
unnamed: C30.2, C31.1, R44.1, U12.3 (T-)
unnamed: R51.1, R52.2, R55.2, U13.2 (VINA-)
unnamed: R56.1, U15.1 (A), U17.1 (A)
unnamed: R57.1, U15.2 (B)
unnamed: U15.4 (Y), U17.2 (B)
unnamed: C40.2, C41.1, R59.1, U16.4 (T+)
unnamed: C41.2, C42.1, R60.1, U16.3 (T-)
unnamed: C52.1, R73.2, U18.3 (VINA+)
unnamed: C50.1, R76.2, U18.5 (VINB+)
unnamed: C53.1, R74.2, U19.3 (VINA+)
unnamed: C49.1, R75.2, U19.5 (VINB+)
unnamed: R77.2, U20.1 (VOUT)
unnamed: R78.2, U21.2 (A0)
unnamed: C_BIAS1.1, R_BIAS1.1, U23.1 (BIAS)
unnamed: C_BT1.2, R_BT1.1, U23.14 (CBOOT)
unnamed: R_ENB1.2, R_ENT1.1, U23.7 (EN/SYNC)
unnamed: R_FBT2.1, R_FBT3.2, U23.4 (FB)
unnamed: R_BT1.2, U23.13 (RBOOT)
unnamed: R_RT1.2, U23.6 (RT)
unnamed: C_BT1.1, L_SW1.1, U23.10 (SW)
unnamed: C1_comp1.2, C2_comp1.2, U24.9 (COMP)
unnamed: C_cs1.2, R_cs1.2, U24.16 (CS)
unnamed: C_cs1.1, R_csg1.2, U24.15 (CSG)
unnamed: R_EN1.2, R_EN2.1, U24.1 (EN)
unnamed: R1_fb1.1, R2_fb1.2, U24.11 (FB)
unnamed: R1_mode1.2, U24.4 (MODE)
unnamed: R_good1.1, U24.17 (PGOOD)
unnamed: R_sync1.1, U24.6 (RT_SYNC)
unnamed: C_slope1.1, U24.7 (SLOPE)
unnamed: C_ss1.1, U24.8 (SS)
unnamed: C_VIN1.1, R_VIN1.2, U24.2 (VIN)
unnamed: C_BIAS3.1, R_BIAS2.1, U25.1 (BIAS)
unnamed: C_BT2.2, R_BT2.1, U25.14 (CBOOT)
unnamed: R_ENB2.2, R_ENT2.1, U25.7 (EN/SYNC)
unnamed: C_FF1.2, R_FBB2.2, R_FBT4.2, U25.4 (FB)
unnamed: R_BT2.2, U25.13 (RBOOT)
unnamed: R_RT3.2, U25.6 (RT)
unnamed: C_BT2.1, L_SW3.1, U25.10 (SW)
unnamed: R81.2, U26.5 (FAULT_N)
unnamed: C94.1, U28.2 (DELAY)
unnamed: R83.1, U28.3 (OSC_FREQ)
unnamed: C95.1, U29.2 (DELAY)
unnamed: R84.1, U29.3 (OSC_FREQ)
unnamed: C93.1, U30.2 (DELAY)
unnamed: R82.1, U30.3 (OSC_FREQ)
unnamed: R18.1, XTAL1.1 (TRI-STATE(STBY))
VBAT: C67.1, C69.1, J5.2, L1.1
VBUS: D2.5 (VCC), D3.A, J2.2 (VBUS), J2.11 (VBUS)
VDC: C68.1, C70.2, C71.2, C73.2, C75.2, C77.2, C_IN1.1, C_IN2.1, C_IN3.1, C_IN4.1, C_IN-BLK1.1, C_IN-BLK2.1, C_IN_HFI1.1, C_IN_HFI2.1, C_IN_HFI3.1, C_IN_HFI4.1, D4.1 (K), IC2.5 (IN-), Q3.1, Q3.2, Q3.5, Q3.6, Q3.7, R_EN1.1, R_ENT1.2, R_ENT2.2, R_SENSE2.2, U23.8 (VIN1), U23.12 (VIN2), U24.3 (VINSNS), U25.8 (VIN1), U25.12 (VIN2)
