FilipaRibeiro2020/Invictus2.0_Hardware/Boards/Electrical Harness/Electrical Harness.kicad_pcb

## KiCad design Boards/Electrical Harness/Electrical Harness.kicad_pcb (2025-10-10)

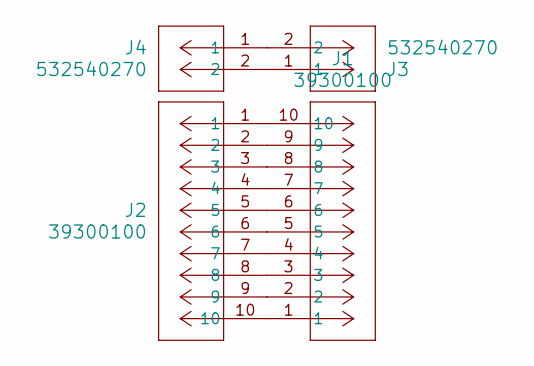
[picture p53: schematic Electrical Harness.kicad_sch]

Parts:
J1, J2: 39300100; CONN_5569-10A_MOL
J3, J4: 532540270; CONN02_532540270_MOL

Connections:
unnamed: J1.1, J2.10
unnamed: J1.2, J2.9
unnamed: J1.3, J2.8
unnamed: J1.4, J2.7
unnamed: J1.5, J2.6
unnamed: J1.6, J2.5
unnamed: J1.7, J2.4
unnamed: J1.8, J2.3
unnamed: J1.9, J2.2
unnamed: J1.10, J2.1
unnamed: J3.1, J4.2
unnamed: J3.2, J4.1

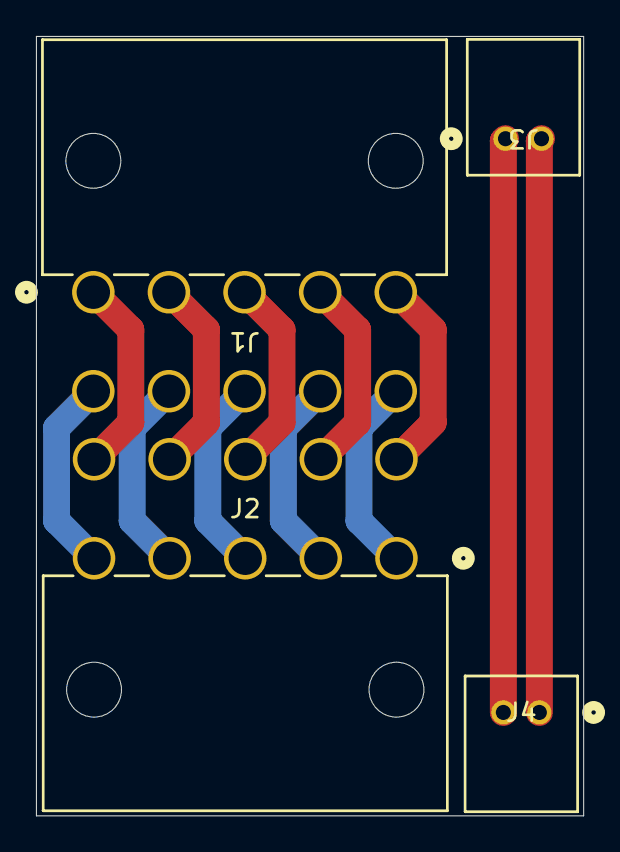
[picture p54: board Electrical Harness.kicad_pcb from above]

Board: 4 copper layers, 30.4 x 43.3 mm, 4 parts (0 on the bottom side), 12 nets.
