FilipaRibeiro2020/Invictus2.0_Hardware/Boards/Rocket Systems/Elytra/Elytra.kicad_pcb

## KiCad design Boards/Rocket Systems/Elytra/Elytra.kicad_pcb (2025-10-10)

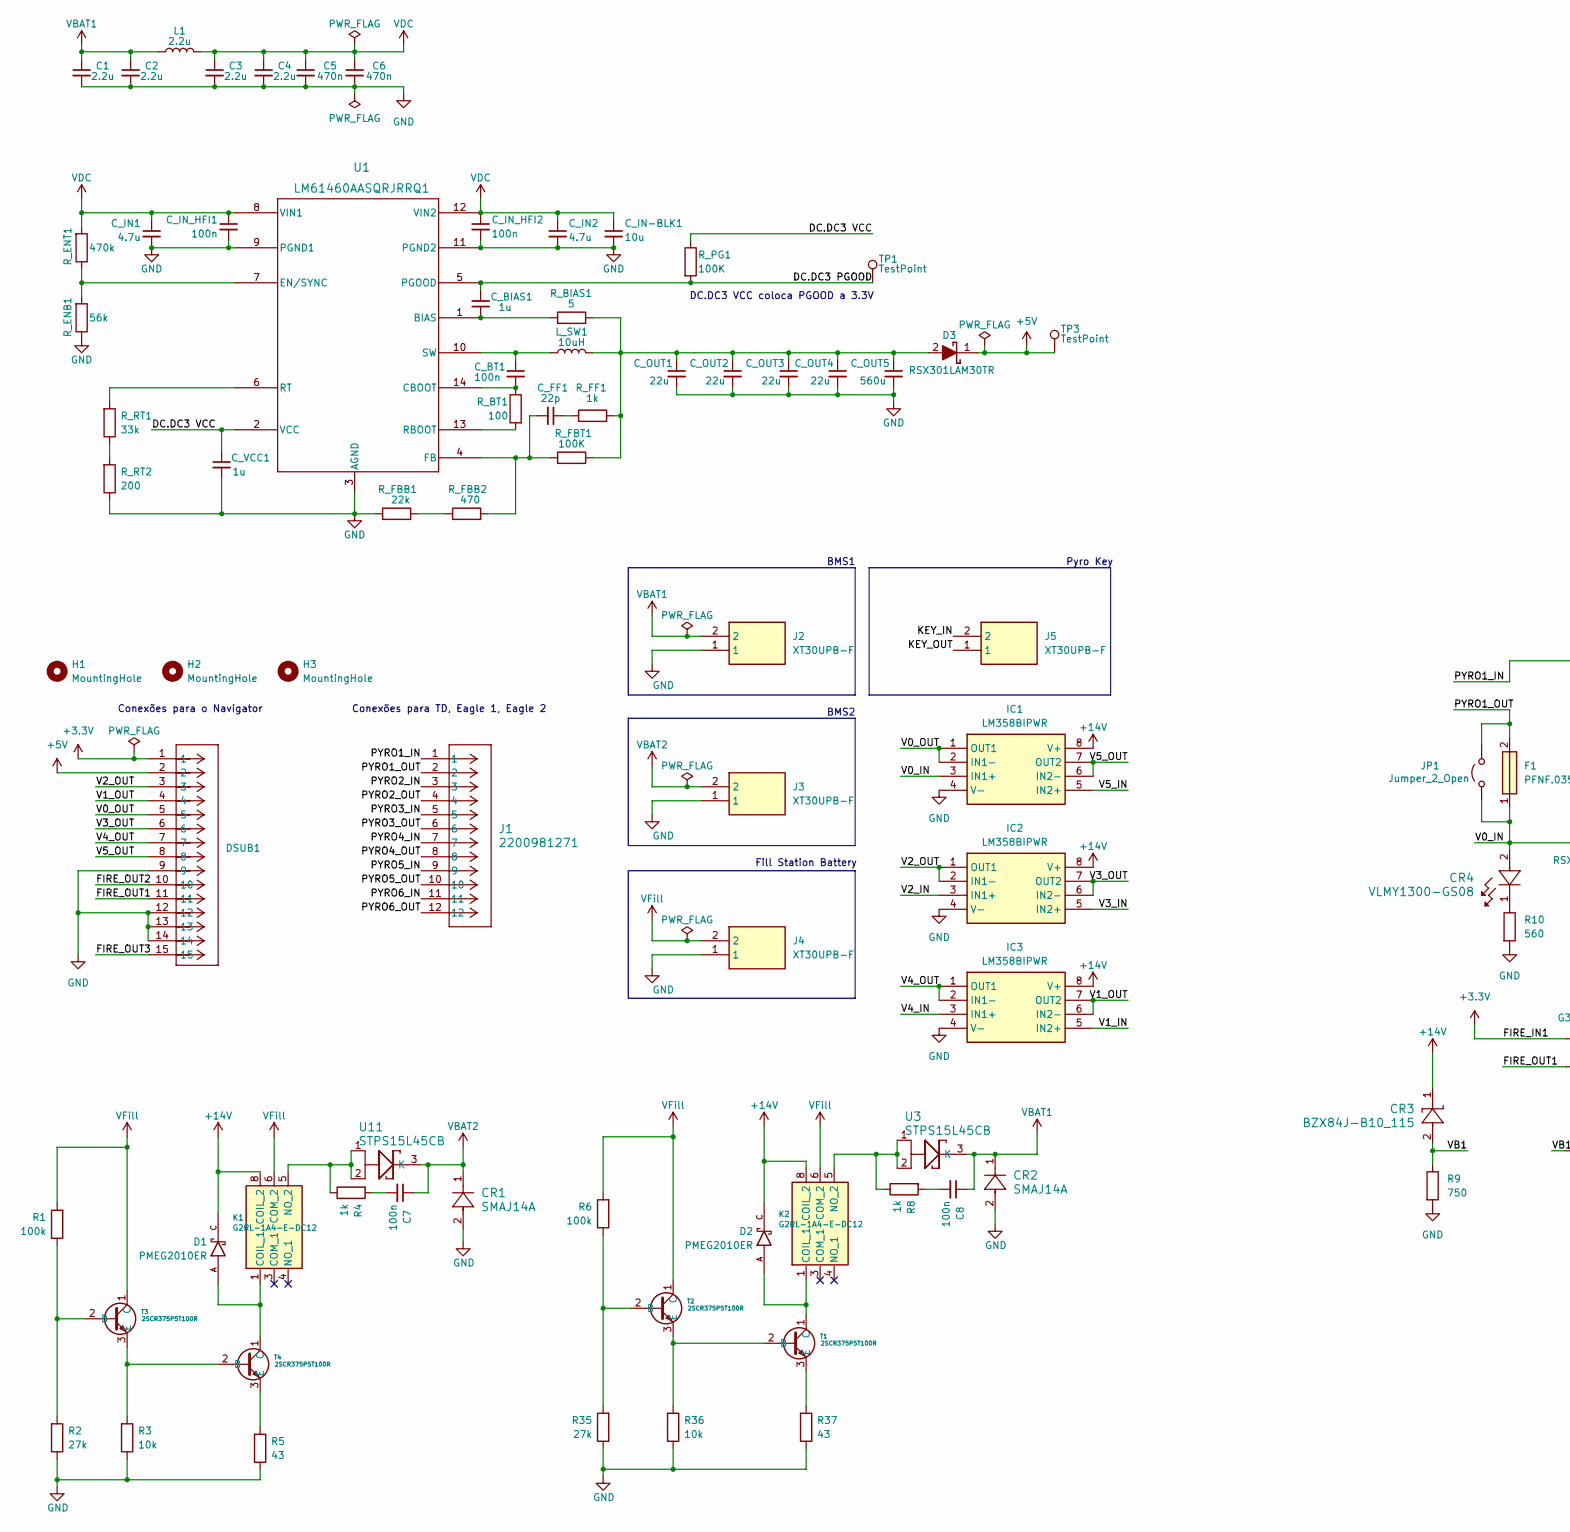
[picture p55: schematic Elytra.kicad_sch, Power Delivery Unit - Elytra, part in row 1, column 1]

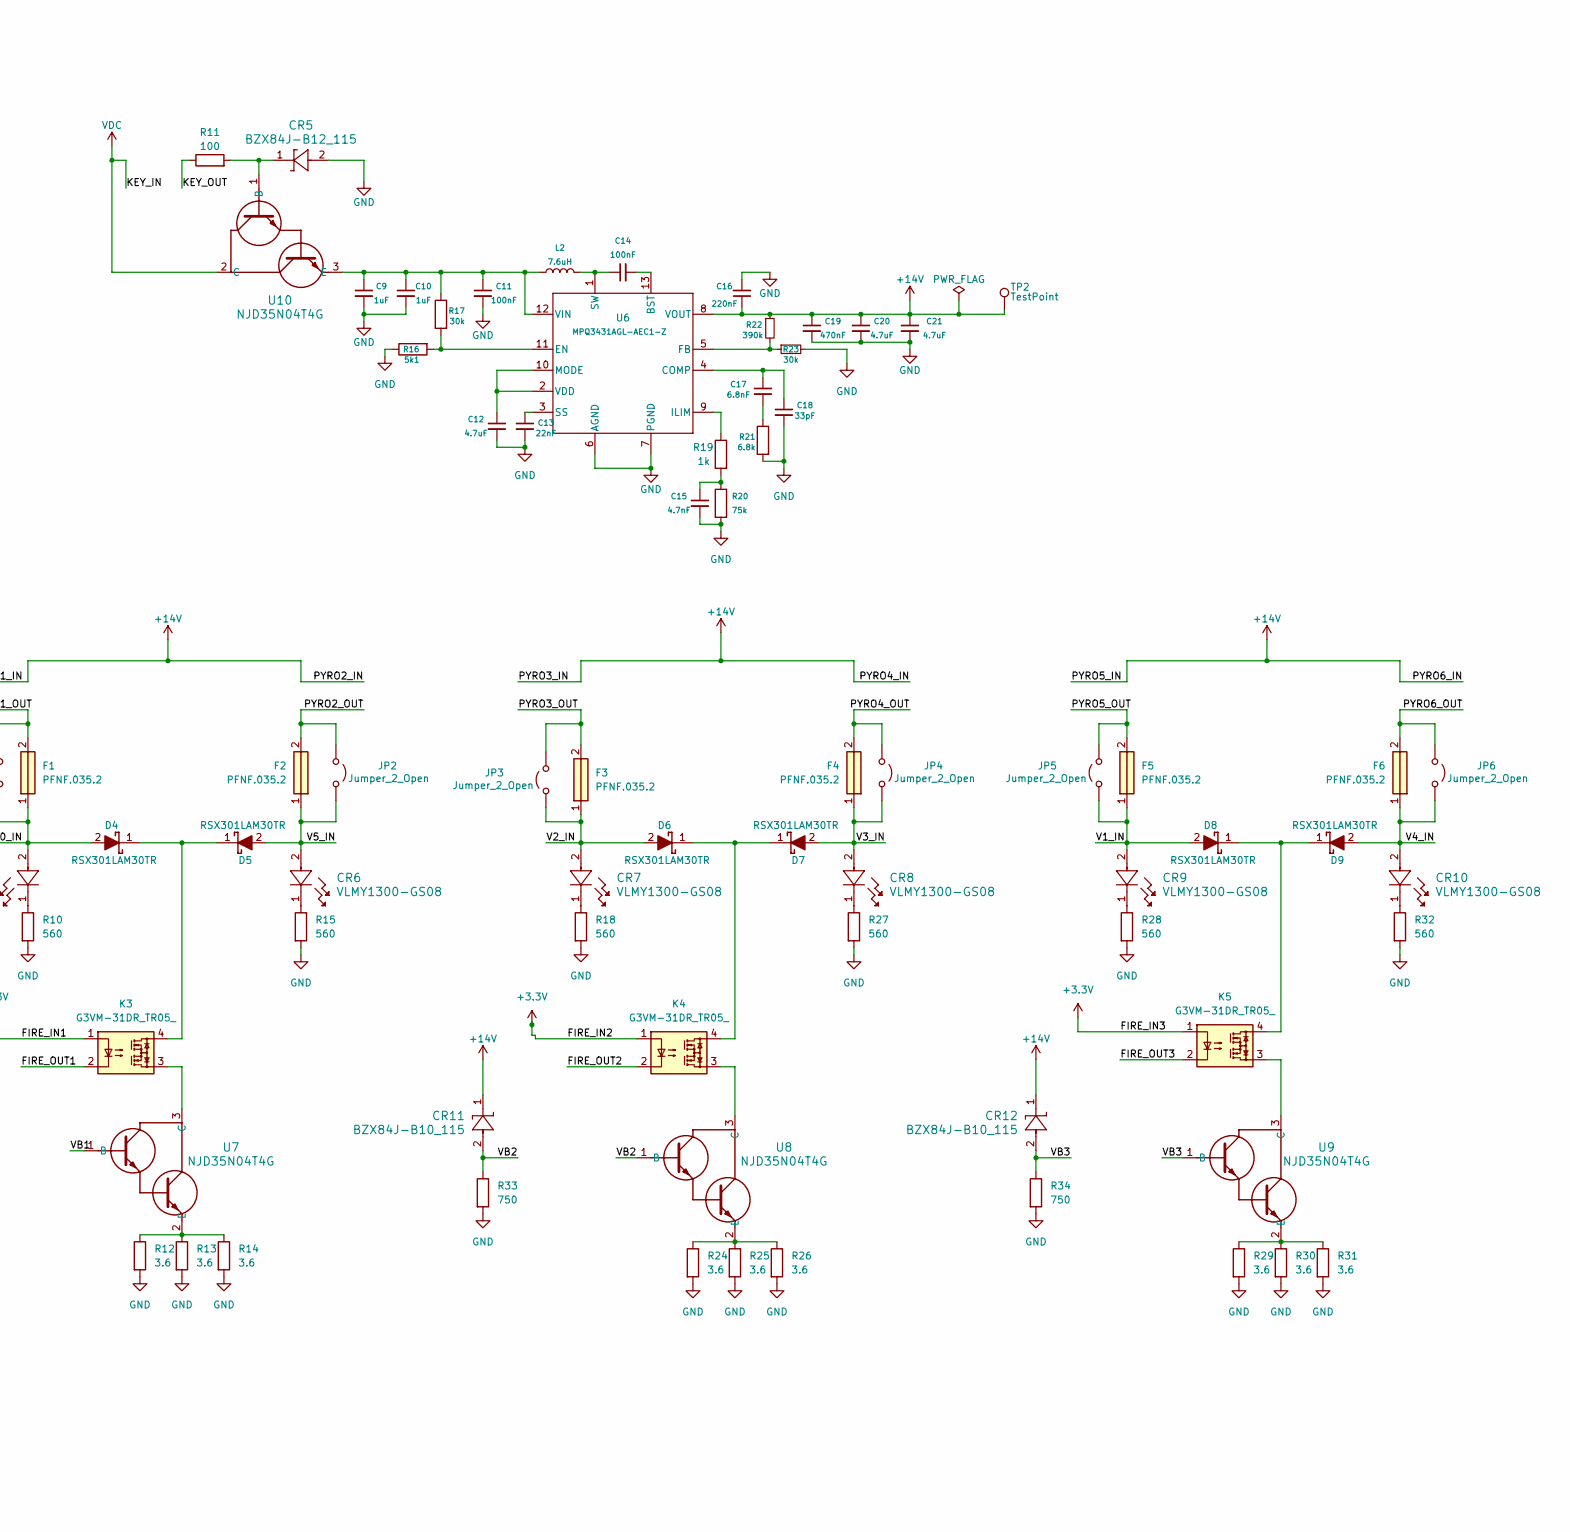
[picture p56: schematic Elytra.kicad_sch, Power Delivery Unit - Elytra, part in row 1, column 2]

Parts:
C1, C2, C3, C4: 2.2u; Capacitor_1206
C5, C6: 470n; Capacitor_1206
C7, C8: 100n; Capacitor_0603
C9, C10: 1uF; Capacitor_0603
C11, C14: 100nF; Capacitor_0603
C12: 4.7uF; Capacitor_0603
C13: 22nF; Capacitor_0603
C15: 4.7nF; Capacitor_0603
C16: 220nF; Capacitor_0603
C17: 6.8nF; Capacitor_0603
C18: 33pF; Capacitor_0603
C19: 470nF; Capacitor_0603
C20, C21: 4.7uF; Capacitor_0805
CR1, CR2: SMAJ14A; SMASeries_LTF
CR3, CR11, CR12: BZX84J-B10_115; CR_SC-90_NEX
CR4, CR6, CR7, CR8, CR9, CR10: VLMY1300-GS08; LEDC1608X100N
CR5: BZX84J-B12_115; CR_SC-90_NEX
C_BIAS1: 1u; Capacitor_0603
C_BT1: 100n; Capacitor_0603
C_FF1: 22p; Capacitor_0402
C_IN1, C_IN2: 4.7u; Capacitor_1206
C_IN-BLK1: 10u; Capacitor_4mm
C_IN_HFI1, C_IN_HFI2: 100n; Capacitor_0603
C_OUT1, C_OUT2, C_OUT3, C_OUT4: 22u; Capacitor_0805
C_OUT5: 560u; Capacitor_8mm
C_VCC1: 1u; Capacitor_0603
D1, D2: PMEG2010ER; SODFL3517X110N; PARTREV 01
D3, D4, D5, D6, D7, D8, D9: RSX301LAM30TR; DIOM5026X220N; Mouser Part Number 755-RSX301L-30DDTE25
DSUB1: HDL15-SL-B
F1, F2, F3, F4, F5, F6: PFNF.035.2; FUS1206_24N_SCH; Mouser Part Number 693-PFNF.035.2
H1, H2, H3: MountingHole; MountingHole_3.2mm_M3_ISO7380
IC1, IC2, IC3: LM358BIPWR; SOP65P640X120-8N; Mouser Part Number 595-LM358BIPWR
J1: 2200981271; CONN_2200980000-SD_12_MOL
J2, J3, J4, J5: XT30UPB-F; XT30UPBF; Manufacturer_Part_Number XT30UPB-F
JP1, JP2, JP3, JP4, JP5, JP6: Jumper_2_Open; SolderJumper-2_P1.3mm_Open_RoundedPad1.0x1.5mm
K1, K2: G2RL-1A4-E-DC12; G2RL1A4EDC12; Mouser Part Number 653-G2RL-1A4-E-DC12
K3, K4, K5: G3VM-31DR_TR05_; G3VM31DRTR05; Mouser Part Number 653-G3VM-31DR(TR05)
L1: 2.2u; IND_SPM10065VT-2R2M-D
L2: 7.6uH; IND_BOURNS_SRR1260
L_SW1: 10uH; SRP7028A3R3M
R1, R6: 100k; RES_0603
R2, R35: 27k; RES_0603
R3, R36: 10k; RES_0603
R4, R8: 1k; RES_0805
R5, R37: 43; RES_0603
R9, R33, R34: 750; RES_0805
R10, R15, R18, R27, R28, R32: 560; RES_0805
R11: 100; RES_0805
R12, R13, R14, R24, R25, R26, R29, R30, R31: 3.6; RESC3263X80N
R16: 5k1; RES_0603
R17, R23: 30k; RES_0603
R19: 1k; RES_0603
R20: 75k; RES_0603
R21: 6.8k; RES_0603
R22: 390k; RES_0603
R_BIAS1: 5; RES_0603
R_BT1: 100; RES_0603
R_ENB1: 56k; RES_0603
R_ENT1: 470k; RES_0603
R_FBB1: 22k; RES_0603
R_FBB2: 470; RES_0603
R_FBT1: 100K; RES_0603
R_FF1: 1k; RES_0603
R_PG1: 100K; RES_0603
R_RT1: 33k; RES_0603
R_RT2: 200; RES_0603
T1, T2, T3, T4: 2SCR375P5T100R; TRANS_2SA2071P_ROM
TP1, TP2, TP3: TestPoint; TestPoint_Pad_2.0x2.0mm
U1: LM61460AASQRJRRQ1; VQFN-HR14_RJR_TEX
U3, U11: STPS15L45CB; DPAK_STM
U6: MPQ3431AGL-AEC1-Z; QFN-13_MPQ3431A_MNP
U7, U8, U9, U10: NJD35N04T4G; DPAK-4_6P22X6P73_ONS

Connections:
+3.3V: DSUB1.1, K3.1, K4.1, K5.1
+5V: D3.1 (K), DSUB1.2, TP3.1
+14V: C16.1, C19.1, C20.1, C21.1, CR3.1, CR11.1, CR12.1, D1.C, D2.C, IC1.8 (V+), IC2.8 (V+), IC3.8 (V+), J1.1, J1.3, J1.5, J1.7, J1.9, J1.11, K1.8 (COIL_2), K2.8 (COIL_2), R22.1, TP2.1, U6.8 (VOUT)
/DC.DC3 PGOOD: C_BIAS1.2, R_PG1.2, TP1.1, U1.5 (PGOOD)
/DC.DC3 VCC: C_VCC1.1, R_PG1.1, U1.2 (VCC)
/FIRE_OUT1: DSUB1.11, K3.2
/FIRE_OUT2: DSUB1.10, K4.2
/FIRE_OUT3: DSUB1.15, K5.2
/KEY_OUT: J5.1, R11.1
/PYRO1_OUT: F1.2, J1.2, JP1.2 (B)
/PYRO2_OUT: F2.2, J1.4, JP2.2 (B)
/PYRO3_OUT: F3.2, J1.6, JP3.2 (B)
/PYRO4_OUT: F4.2, J1.8, JP4.2 (B)
/PYRO5_OUT: F5.2, J1.10, JP5.2 (B)
/PYRO6_OUT: F6.2, J1.12, JP6.2 (B)
/V0_IN: CR4.2, D4.2 (A), F1.1, IC1.3 (IN1+), JP1.1 (A)
/V0_OUT: DSUB1.5, IC1.1 (OUT1), IC1.2 (IN1-)
/V1_IN: CR9.2, D8.2 (A), F5.1, IC3.5 (IN2+), JP5.1 (A)
/V1_OUT: DSUB1.4, IC3.6 (IN2-), IC3.7 (OUT2)
/V2_IN: CR7.2, D6.2 (A), F3.1, IC2.3 (IN1+), JP3.1 (A)
/V2_OUT: DSUB1.3, IC2.1 (OUT1), IC2.2 (IN1-)
/V3_IN: CR8.2, D7.2 (A), F4.1, IC2.5 (IN2+), JP4.1 (A)
/V3_OUT: DSUB1.6, IC2.6 (IN2-), IC2.7 (OUT2)
/V4_IN: CR10.2, D9.2 (A), F6.1, IC3.3 (IN1+), JP6.1 (A)
/V4_OUT: DSUB1.7, IC3.1 (OUT1), IC3.2 (IN1-)
/V5_IN: CR6.2, D5.2 (A), F2.1, IC1.5 (IN2+), JP2.1 (A)
/V5_OUT: DSUB1.8, IC1.6 (IN2-), IC1.7 (OUT2)
/VB1: CR3.2, R9.1, U7.1 (B)
/VB2: CR11.2, R33.1, U8.1 (B)
/VB3: CR12.2, R34.1, U9.1 (B)
GND: C1.2, C2.2, C3.2, C4.2, C5.2, C6.2, C9.2, C10.2, C11.2, C12.2, C13.2, C15.2, C16.2, C18.2, C19.2, C20.2, C21.2, CR1.2, CR2.2, CR5.2, C_IN1.2, C_IN2.2, C_IN-BLK1.2, C_IN_HFI1.2, C_IN_HFI2.2, C_OUT1.2, C_OUT2.2, C_OUT3.2, C_OUT4.2, C_OUT5.2, C_VCC1.2, DSUB1.9, DSUB1.12, DSUB1.13, DSUB1.14, IC1.4 (V-), IC2.4 (V-), IC3.4 (V-), J2.1, J3.1, J4.1, R2.1, R3.1, R5.1, R9.2, R10.2, R12.2, R13.2, R14.2, R15.2, R16.1, R18.2, R20.2, R21.2, R23.2, R24.2, R25.2, R26.2, R27.2, R28.2, R29.2, R30.2, R31.2, R32.2, R33.2, R34.2, R35.1, R36.1, R37.1, R_ENB1.1, R_FBB1.1, R_RT2.1, U1.3 (AGND), U1.9 (PGND1), U1.11 (PGND2), U6.6 (AGND), U6.7 (PGND)
unnamed: C7.2, R4.2
unnamed: C8.2, R8.2
unnamed: C15.1, R19.2, R20.1
unnamed: C17.2, R21.1
unnamed: CR4.1, R10.1
unnamed: CR6.1, R15.1
unnamed: CR7.1, R18.1
unnamed: CR8.1, R27.1
unnamed: CR9.1, R28.1
unnamed: CR10.1, R32.1
unnamed: C_FF1.1, R_FF1.2
unnamed: C_OUT1.1, C_OUT2.1, C_OUT3.1, C_OUT4.1, C_OUT5.1, D3.2 (A), L_SW1.2, R_BIAS1.2, R_FBT1.1, R_FF1.1
unnamed: D4.1 (K), D5.1 (K), K3.4
unnamed: D6.1 (K), D7.1 (K), K4.4
unnamed: D8.1 (K), D9.1 (K), K5.4
unnamed: D1.A, K1.1 (COIL_1), T4.1 (C)
unnamed: K1.5 (NO_2), R4.1, U11.1, U11.2
unnamed: D2.A, K2.1 (COIL_1), T1.1 (C)
unnamed: K2.5 (NO_2), R8.1, U3.1, U3.2
unnamed: R_FBB1.2, R_FBB2.1
unnamed: R_RT1.1, R_RT2.2
unnamed: R36.2, T1.2 (B), T2.3 (E)
unnamed: R37.2, T1.3 (E)
unnamed: R6.1, R35.2, T2.2 (B)
unnamed: R1.1, R2.2, T3.2 (B)
unnamed: R3.2, T3.3 (E), T4.2 (B)
unnamed: R5.2, T4.3 (E)
unnamed: C_BIAS1.1, R_BIAS1.1, U1.1 (BIAS)
unnamed: C_BT1.2, R_BT1.1, U1.14 (CBOOT)
unnamed: R_ENB1.2, R_ENT1.1, U1.7 (EN/SYNC)
unnamed: C_FF1.2, R_FBB2.2, R_FBT1.2, U1.4 (FB)
unnamed: R_BT1.2, U1.13 (RBOOT)
unnamed: R_RT1.2, U1.6 (RT)
unnamed: C_BT1.1, L_SW1.1, U1.10 (SW)
unnamed: C14.2, U6.13 (BST)
unnamed: C17.1, C18.1, U6.4 (COMP)
unnamed: R16.2, R17.2, U6.11 (EN)
unnamed: R22.2, R23.1, U6.5 (FB)
unnamed: R19.1, U6.9 (ILIM)
unnamed: C12.1, U6.2 (VDD), U6.10 (MODE)
unnamed: C13.1, U6.3 (SS)
unnamed: C14.1, L2.2, U6.1 (SW)
unnamed: K3.3, U7.3 (C)
unnamed: R12.1, R13.1, R14.1, U7.2 (E)
unnamed: K4.3, U8.3 (C)
unnamed: R24.1, R25.1, R26.1, U8.2 (E)
unnamed: K5.3, U9.3 (C)
unnamed: R29.1, R30.1, R31.1, U9.2 (E)
unnamed: CR5.1, R11.2, U10.1 (B)
unnamed: C9.1, C10.1, C11.1, L2.1, R17.1, U6.12 (VIN), U10.3 (E)
VBAT1: C1.1, C2.1, C8.1, CR2.1, J2.2, L1.1, U3.3 (K)
VBAT2: C7.1, CR1.1, J3.2, U11.3 (K)
VDC: C3.1, C4.1, C5.1, C6.1, C_IN1.1, C_IN2.1, C_IN-BLK1.1, C_IN_HFI1.1, C_IN_HFI2.1, J5.2, L1.2, R_ENT1.2, U1.8 (VIN1), U1.12 (VIN2), U10.2 (C)
VFill: J4.2, K1.6 (COM_2), K2.6 (COM_2), R1.2, R6.2, T2.1 (C), T3.1 (C)

Notes on the sheet:
Fill Station Battery
Conexões para o Navigator
DC.DC3 VCC coloca PGOOD a 3.3V
BMS1
BMS2
Pyro Key
Conexões para TD, Eagle 1, Eagle 2
