FilipaRibeiro2020/Invictus2.0_Hardware/Boards/Rocket Systems/Elytra/Elytra.kicad_pcb

## KiCad design Boards/Rocket Systems/Elytra/Elytra.kicad_pcb (continued)

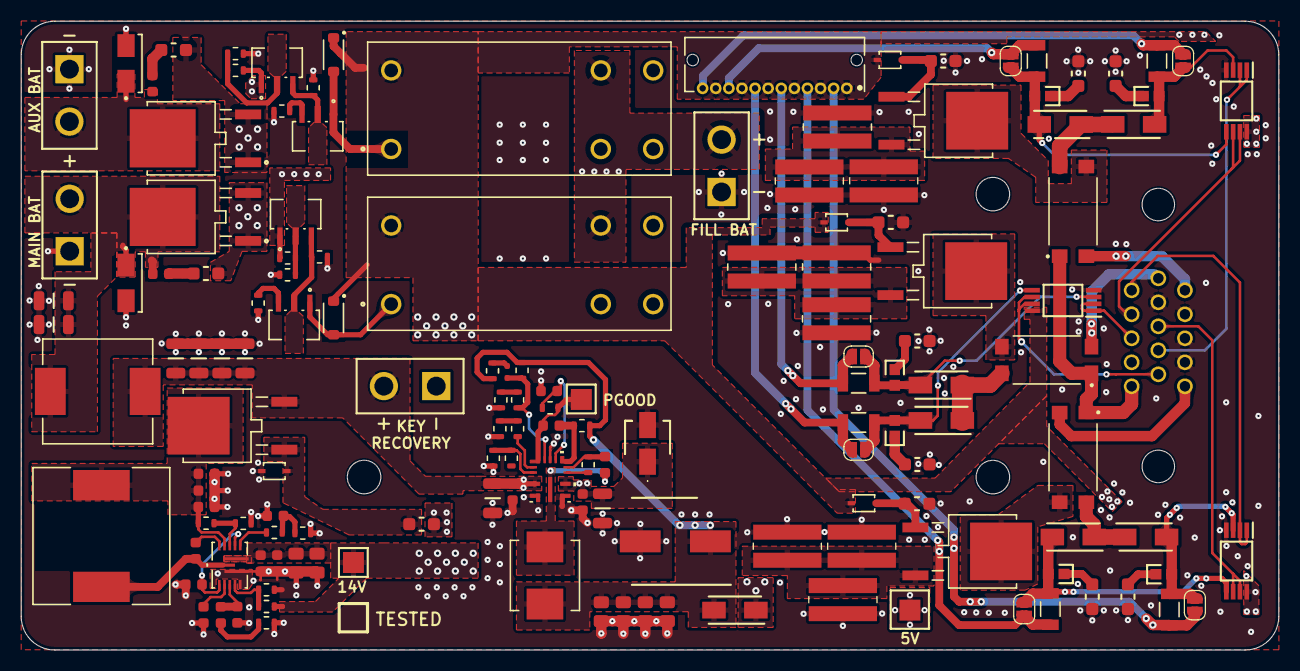
[picture p57: board Elytra.kicad_pcb from above]

Board: 4 copper layers, 120.0 x 60.0 mm, 150 parts (0 on the bottom side), 85 nets.
