FilipaRibeiro2020/Invictus2.0_Hardware/Boards/Rocket Systems/OBC/OBC.kicad_pcb

## KiCad design Boards/Rocket Systems/OBC/OBC.kicad_pcb (2025-10-10)

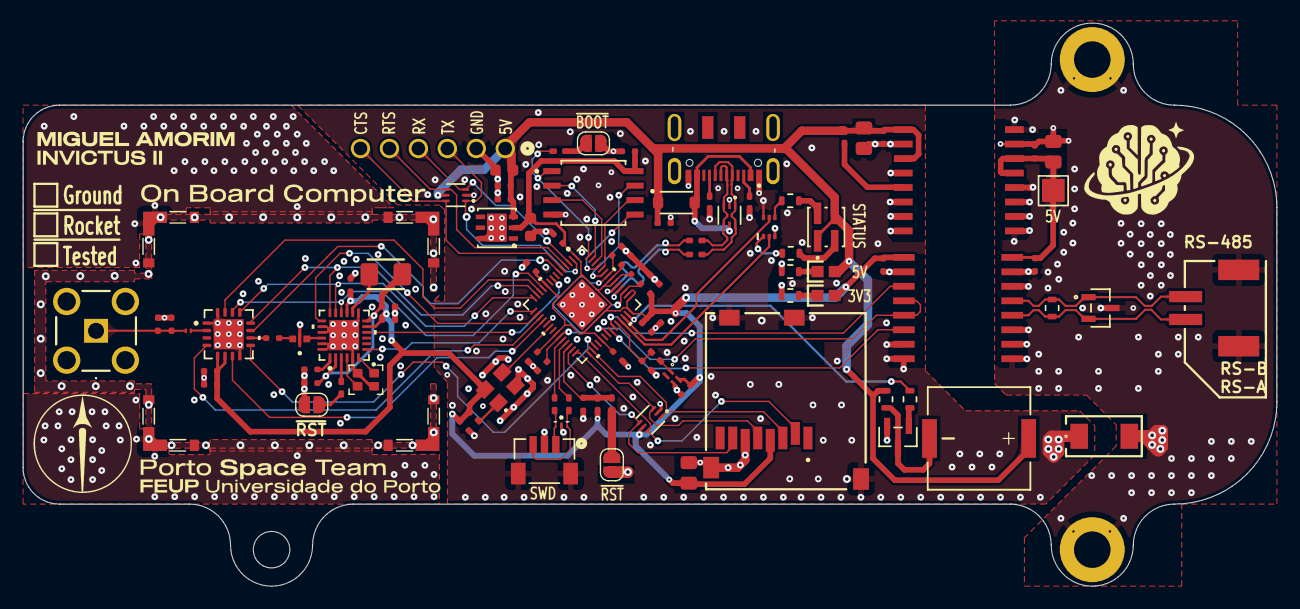
[picture p58: board OBC.kicad_pcb from above]

Board: 4 copper layers, 110.0 x 49.4 mm, 103 parts (1 on the bottom side), 78 nets.

Parts:
C1, C3: 10nF; Capacitor_0402
C2: 4.7u; Capacitor_0603
C4: 1u; Capacitor_0402
C5, C9, C10, C20, C23, C25, C26, C28, C29, C30, C31, C32, C33, C35, C40, C43: 100nF; Capacitor_0402
C6, C17, C18, C36, C37, C42: 100n; Capacitor_0402
C7: 470nF; Capacitor_0402
C8: 300pF; C1808
C12: 10u; Capacitor_0805
C15: 1p; Capacitor_0402
C16, C39: 10uF; Capacitor_0805
C19: 0.9p; Capacitor_0402
C21: 0.3p; Capacitor_0402
C22, C24, C27, C34: 1uF; Capacitor_0402
C38: 4.7uF; Capacitor_0603
C41: 470n; Capacitor_0402
CR1, CR2: VLMY1300-GS08; LEDC1608X100N
CR3: SP712-02HTG; SOT23-3_LTF
D1, D2, D3: SP3004-04XTG; SOT563_LTF
D4: PMEG2010ER; SODFL3517X110N
D5: ESD122DMYR; DIO_ESD122DMYR
FL1: ADFC15-2450.00-A-T; FIL_ADFC15-2450.00-A-T
H1: MountingHole; MountingHole_3.2mm_M3_ISO7380
H2, H3: MountingHole_Pad; MountingHole_3.2mm_M3_ISO7380_Pad
IC1: NSVT30010MXV6T1G; SOTFL50P160X60-6N
IC2: BC846BLT1G; SOT-23_ONS
J1: 1718560006; CONN06_1718560006_MOL
J2: 5024430270; CONN_502443-02xx_MOL
J3: MEM2061-01-188-00-A_REVA; GCT_MEM2061-01-188-00-A_REVA
J4: PCB.RPSMAFRA.HT; PCBRPSMAFRAHT
J5: BM03B-SRSS-TBLFSN; CONN_BM03B-SRSS-TBLFSN_JST
J6: DX07S016JA1R1500; JAE_DX07S016JA1R1500
J7, J8, J9, J10: S0981-46R; HARWIN_S0981-46R
JP1, JP2, JP3: Jumper_2_Open; SolderJumper-2_P1.3mm_Open_RoundedPad1.0x1.5mm
L1: 15uH; Inductor_0805
L4: 1.9nH; Inductor_0201
LS1: PKMCS0909E4000-R1; SPKR_PKMCS0909E4000-R1
MCU1: RP2040; QFN56_7X7_RPI
R1, R15, R20, R24: 1k; RES_0402
R4, R5: 100; RES_0603
R6, R7: 1k; RES_0603
R10: 100K; RES_0402
R13: 62; RES_0603
R14: 150; RES_0603
R16, R17: 27; RES_0402
R18, R19: 100; RES_0402
R21: 10k; RES_0402
R22, R23: 5k1; RES_0402
R25: 36k; RES_0402
R55: 120; RES_0603
S1: RFI Shield 20x25; RFI Shield
TP6: TestPoint; TestPoint_Pad_2.0x2.0mm
U1: SX1280IMLTRT; QFN24_4X4_SEM
U2: STLM20DD9F; UDFN-4L_STM
U3: NRF21540-QDAA-R; QFN16_4X4_NOR
U5: VLMKG3400-GS08; SMT_00-GS08_VIS
U6: W25Q128JVSIQ TR; SOIC_208MIL_WIN
U7: ST1L05APU33R; DFN_5APU33R_STM
U12: ISO1410BDW; DW0016B_N
U14: UCC12050DVE; DVE0016A
XTAL1: NX2016SA-52MHZ-EXS00A-CS07103; OSCCC200X160X50N
XTAL2: ASE-12.000MHZ-LC-T; ASE24576MHZLCT

Connections:
+3.3V: C5.1, C9.1, C10.1, C12.1, C17.1, C18.1, C26.1, C27.1, C28.1, C29.1, C30.1, C31.1, C32.1, C33.1, C34.1, C35.1, C36.1, C38.2, C40.1, CR1.2, D2.5 (VCC), J3.4 (VDD), MCU1.1 (IOVDD), MCU1.10 (IOVDD), MCU1.22 (IOVDD), MCU1.33 (IOVDD), MCU1.42 (IOVDD), MCU1.43 (ADC_AVDD), MCU1.44 (VREG_IN), MCU1.48 (USB_VDD), MCU1.49 (IOVDD), R15.1, R21.2, U1.11 (VBAT_IO), U1.15 (VBAT), U2.4 (VCC), U3.5 (VDD), U3.6 (VDD), U6.8 (VCC), U7.2 (V0), U12.1 (VCC1), XTAL2.4 (VDD)
+5V: C2.2, C4.2, C6.2, C16.1, C37.1, C43.1, CR2.2, D1.5 (VCC), D4.C, J1.1, LS1.1, R7.1, R10.1, U5.1 (C_RED), U5.3 (C_Green), U7.3 (V1), U14.1 (EN), U14.3 (VINP)
+5VA: C20.1, C39.1, C42.2, TP6.1, U12.16 (VCC2), U14.13 (SEL), U14.14 (VISO)
/BUSY SX1280: MCU1.15 (GPIO12), U1.7 (BUSY)
/Buzzer: MCU1.41 (GPIO29_ADC3), R6.2
/DIO3 SX1280: MCU1.8 (GPIO6), U1.10 (DIO3)
/ENABLE_RS: MCU1.35 (GPIO23), U12.4 (~RE), U12.5 (DE)
/Green Status: IC1.2 (B2), MCU1.39 (GPIO27_ADC1)
/MODE NRF21540: MCU1.17 (GPIO14), U3.4 (MODE)
/NRF21540 ~CS SPI: MCU1.12 (GPIO9), U3.15 (CSN)
/Nav CTS UART: D1.6 (IO4), J1.6, MCU1.5 (GPIO3)
/Nav RTS UART: D1.4 (IO3), J1.5, MCU1.4 (GPIO2)
/Nav RX UART: D1.1 (IO1), J1.3, MCU1.2 (GPIO0)
/Nav TX UART: D1.3 (IO2), J1.4, MCU1.3 (GPIO1)
/RADIO MISO SPI: MCU1.11 (GPIO8), U1.16 (MISO_TX), U3.14 (MISO)
/RADIO MOSI SPI: MCU1.14 (GPIO11), U1.17 (MOSI_RX), U3.13 (MOSI)
/RADIO SCK SPI: MCU1.13 (GPIO10), U1.18 (SCK_RTSN), U3.12 (SCK)
/READ_RS: MCU1.37 (GPIO25), U12.3 (R)
/RP2040/CLK SWD: D5.2, J5.1, R18.1
/RP2040/Crystal: MCU1.20 (XIN), XTAL2.3 (OUTPUT)
/RP2040/MCU SCLK SPI: MCU1.52 (QSPI_SCLK), U6.6 (CLK)
/RP2040/MCU SD0 SPI: MCU1.53 (QSPI_SD0), U6.5 (DI(IO0))
/RP2040/MCU SD1 SPI: MCU1.55 (QSPI_SD1), U6.2 (DO(IO1))
/RP2040/MCU SD2 SPI: MCU1.54 (QSPI_SD2), U6.3 (/WP(IO2))
/RP2040/MCU SD3 SPI: MCU1.51 (QSPI_SD3), U6.7 (/HOLD_/RESET)
/RP2040/MCU ~CS SPI: MCU1.56 (QSPI_SS), R24.2, U6.1 (/CS)
/RP2040/SWD: D5.3, J5.3, R19.1
/RP2040/USB_D+: MCU1.47 (USB_DP), R16.2
/RP2040/USB_D-: MCU1.46 (USB_DM), R17.2
/RP2040/USB_DN: D3.1 (IO1), D3.6 (IO4), J6.5 (D-), J6.8 (D-), R17.1
/RP2040/USB_DP: D3.3 (IO2), D3.4 (IO3), J6.6 (D+), J6.7 (D+), R16.1
/RP2040/~RST: JP2.2 (B), R20.1
/RP2040/~USB_BOOT: JP3.2 (B), R24.1
/RS_DN: CR3.2, J2.2, R55.1, U12.12 (A)
/RS_DP: CR3.1, J2.1, R55.2, U12.13 (B)
/RX_EN NRF21540: MCU1.18 (GPIO15), U3.7 (RX_EN)
/Red Status: IC1.5 (B1), MCU1.40 (GPIO28_ADC2)
/SD-Card ~CS SPI: D2.6 (IO4), J3.2 (CD/DAT3), MCU1.28 (GPIO17)
/SD-Card MISO SPI: D2.4 (IO3), J3.7 (DAT0), MCU1.27 (GPIO16)
/SD-Card MOSI SPI: D2.1 (IO1), J3.3 (CMD), MCU1.30 (GPIO19)
/SD-Card SCK SPI: D2.3 (IO2), J3.5 (CLK), MCU1.29 (GPIO18)
/SX1280 XTA -: U1.4 (XTA), XTAL1.3
/SX1280 XTB +: U1.6 (XTB), XTAL1.1
/SX1280 ~CS SPI: MCU1.16 (GPIO13), U1.19 (NSS_CTS)
/TX_EN NRF21540: MCU1.31 (GPIO20), U3.9 (TX_EN)
/Temp_Sense: C41.2, MCU1.38 (GPIO26_ADC0), R25.1
/WRITE_RS: MCU1.36 (GPIO24), U12.6 (D)
/~PDN NRF21540: MCU1.6 (GPIO4), U3.11 (PDN)
/~RST SX1280: R1.2, U1.3 (NRESET)
AGND: C8.2, C20.2, C39.2, C42.1, CR3.3, H2.1, H3.1, J2.3 (MP1), J2.4 (MP2), U12.9 (GND2), U12.10 (NC), U12.11 (NC), U12.14 (NC), U12.15 (GND2), U14.9 (GNDS), U14.10 (NCS), U14.11 (NCS), U14.12 (NCS), U14.15 (GNDS), U14.16 (NCS)
GND: C1.2, C2.1, C3.2, C4.1, C5.2, C6.1, C7.2, C8.1, C9.2, C10.2, C12.2, C16.2, C17.2, C18.2, C19.2, C21.2, C22.2, C23.1, C24.2, C25.1, C26.2, C27.2, C28.2, C29.2, C30.2, C31.2, C32.2, C33.2, C34.2, C35.2, C36.2, C37.2, C38.1, C40.2, C41.1, C43.2, D1.2 (GND), D2.2 (GND), D3.2 (GND), D5.1, FL1.1 (GND), FL1.3 (GND), IC1.3 (C1), IC1.6 (C2), IC2.2 (E), J1.2, J3.6 (VSS), J3.9 (CD1), J3.10 (CD2), J3.11 (GND), J3.12 (GND), J4.2, J4.3, J4.4, J4.5, J5.2, J5.4 (EP), J5.5 (EP), J6.1 (GND), J6.12 (GND), J7.SH1 (SHIELD), J7.SH2 (SHIELD), J7.SH3 (SHIELD), J8.SH1 (SHIELD), J8.SH2 (SHIELD), J8.SH3 (SHIELD), J9.SH1 (SHIELD), J9.SH2 (SHIELD), J9.SH3 (SHIELD), J10.SH1 (SHIELD), J10.SH2 (SHIELD), J10.SH3 (SHIELD), JP1.1 (A), JP2.1 (A), JP3.1 (A), MCU1.19 (TESTEN), MCU1.57 (GND), R13.1, R14.1, R22.1, R23.2, U1.5 (GND), U1.13 (GND), U1.20 (GND), U1.21 (GND), U1.23 (GND), U1.24 (GND), U1.25 (GND), U2.3 (GND), U3.1 (VSS), U3.8 (ANT_SEL), U3.16 (VSS), U3.17 (VSS), U6.4 (GND), U7.6 (GND), U7.7 (GND), U12.2 (GND1), U12.7 (NC), U12.8 (GND1), U14.2 (GNDP), U14.4 (SYNC), U14.6 (NCP), U14.7 (NCP), U14.8 (NCP), XTAL1.2 (GND), XTAL1.4 (GND__1), XTAL2.2 (GND/CASE)
unnamed: C19.1, C21.1, J4.1, L4.2
unnamed: CR1.1, R13.2
unnamed: CR2.1, R14.2
unnamed: C15.1, FL1.4 (IN/OUT)
unnamed: FL1.2 (OUT/IN), U1.22 (RFIO)
unnamed: IC1.4 (E1), R5.1
unnamed: IC1.1 (E2), R4.2
unnamed: IC2.1 (B), R6.1
unnamed: IC2.3 (C), LS1.2, R7.2
unnamed: J6.3 (CC1), R22.2
unnamed: J6.9 (CC2), R23.1
unnamed: JP1.2 (B), R1.1
unnamed: C22.1, MCU1.26 (RUN), R15.2, R20.2
unnamed: MCU1.24 (SWCLK), R18.2
unnamed: MCU1.25 (SWD), R19.2
unnamed: C23.2, C24.1, C25.2, MCU1.23 (DVDD), MCU1.45 (VREG_VOUT), MCU1.50 (DVDD)
unnamed: C3.1, C7.1, L1.1, U1.2 (VDD_INN), U1.12 (DCC_FB)
unnamed: L1.2, U1.14 (DCC_SW)
unnamed: C1.1, U1.1 (VR_PA)
unnamed: R25.2, U2.1 (VOUT)
unnamed: L4.1, U3.2 (ANT1)
unnamed: C15.2, U3.10 (TRX)
unnamed: R4.1, U5.2 (A_Green)
unnamed: R5.2, U5.4 (A_Red)
unnamed: R10.2, U14.5 (FAULT_N)
unnamed: R21.1, XTAL2.1 (TRI-STATE(STBY))
VBUS: D3.5 (VCC), D4.A, J6.2 (VBUS), J6.11 (VBUS)
