FilipaRibeiro2020/Invictus2.0_Hardware/Boards/Rocket Systems/Navigator/Navigator.kicad_pcb

## KiCad design Boards/Rocket Systems/Navigator/Navigator.kicad_pcb (2025-10-10)

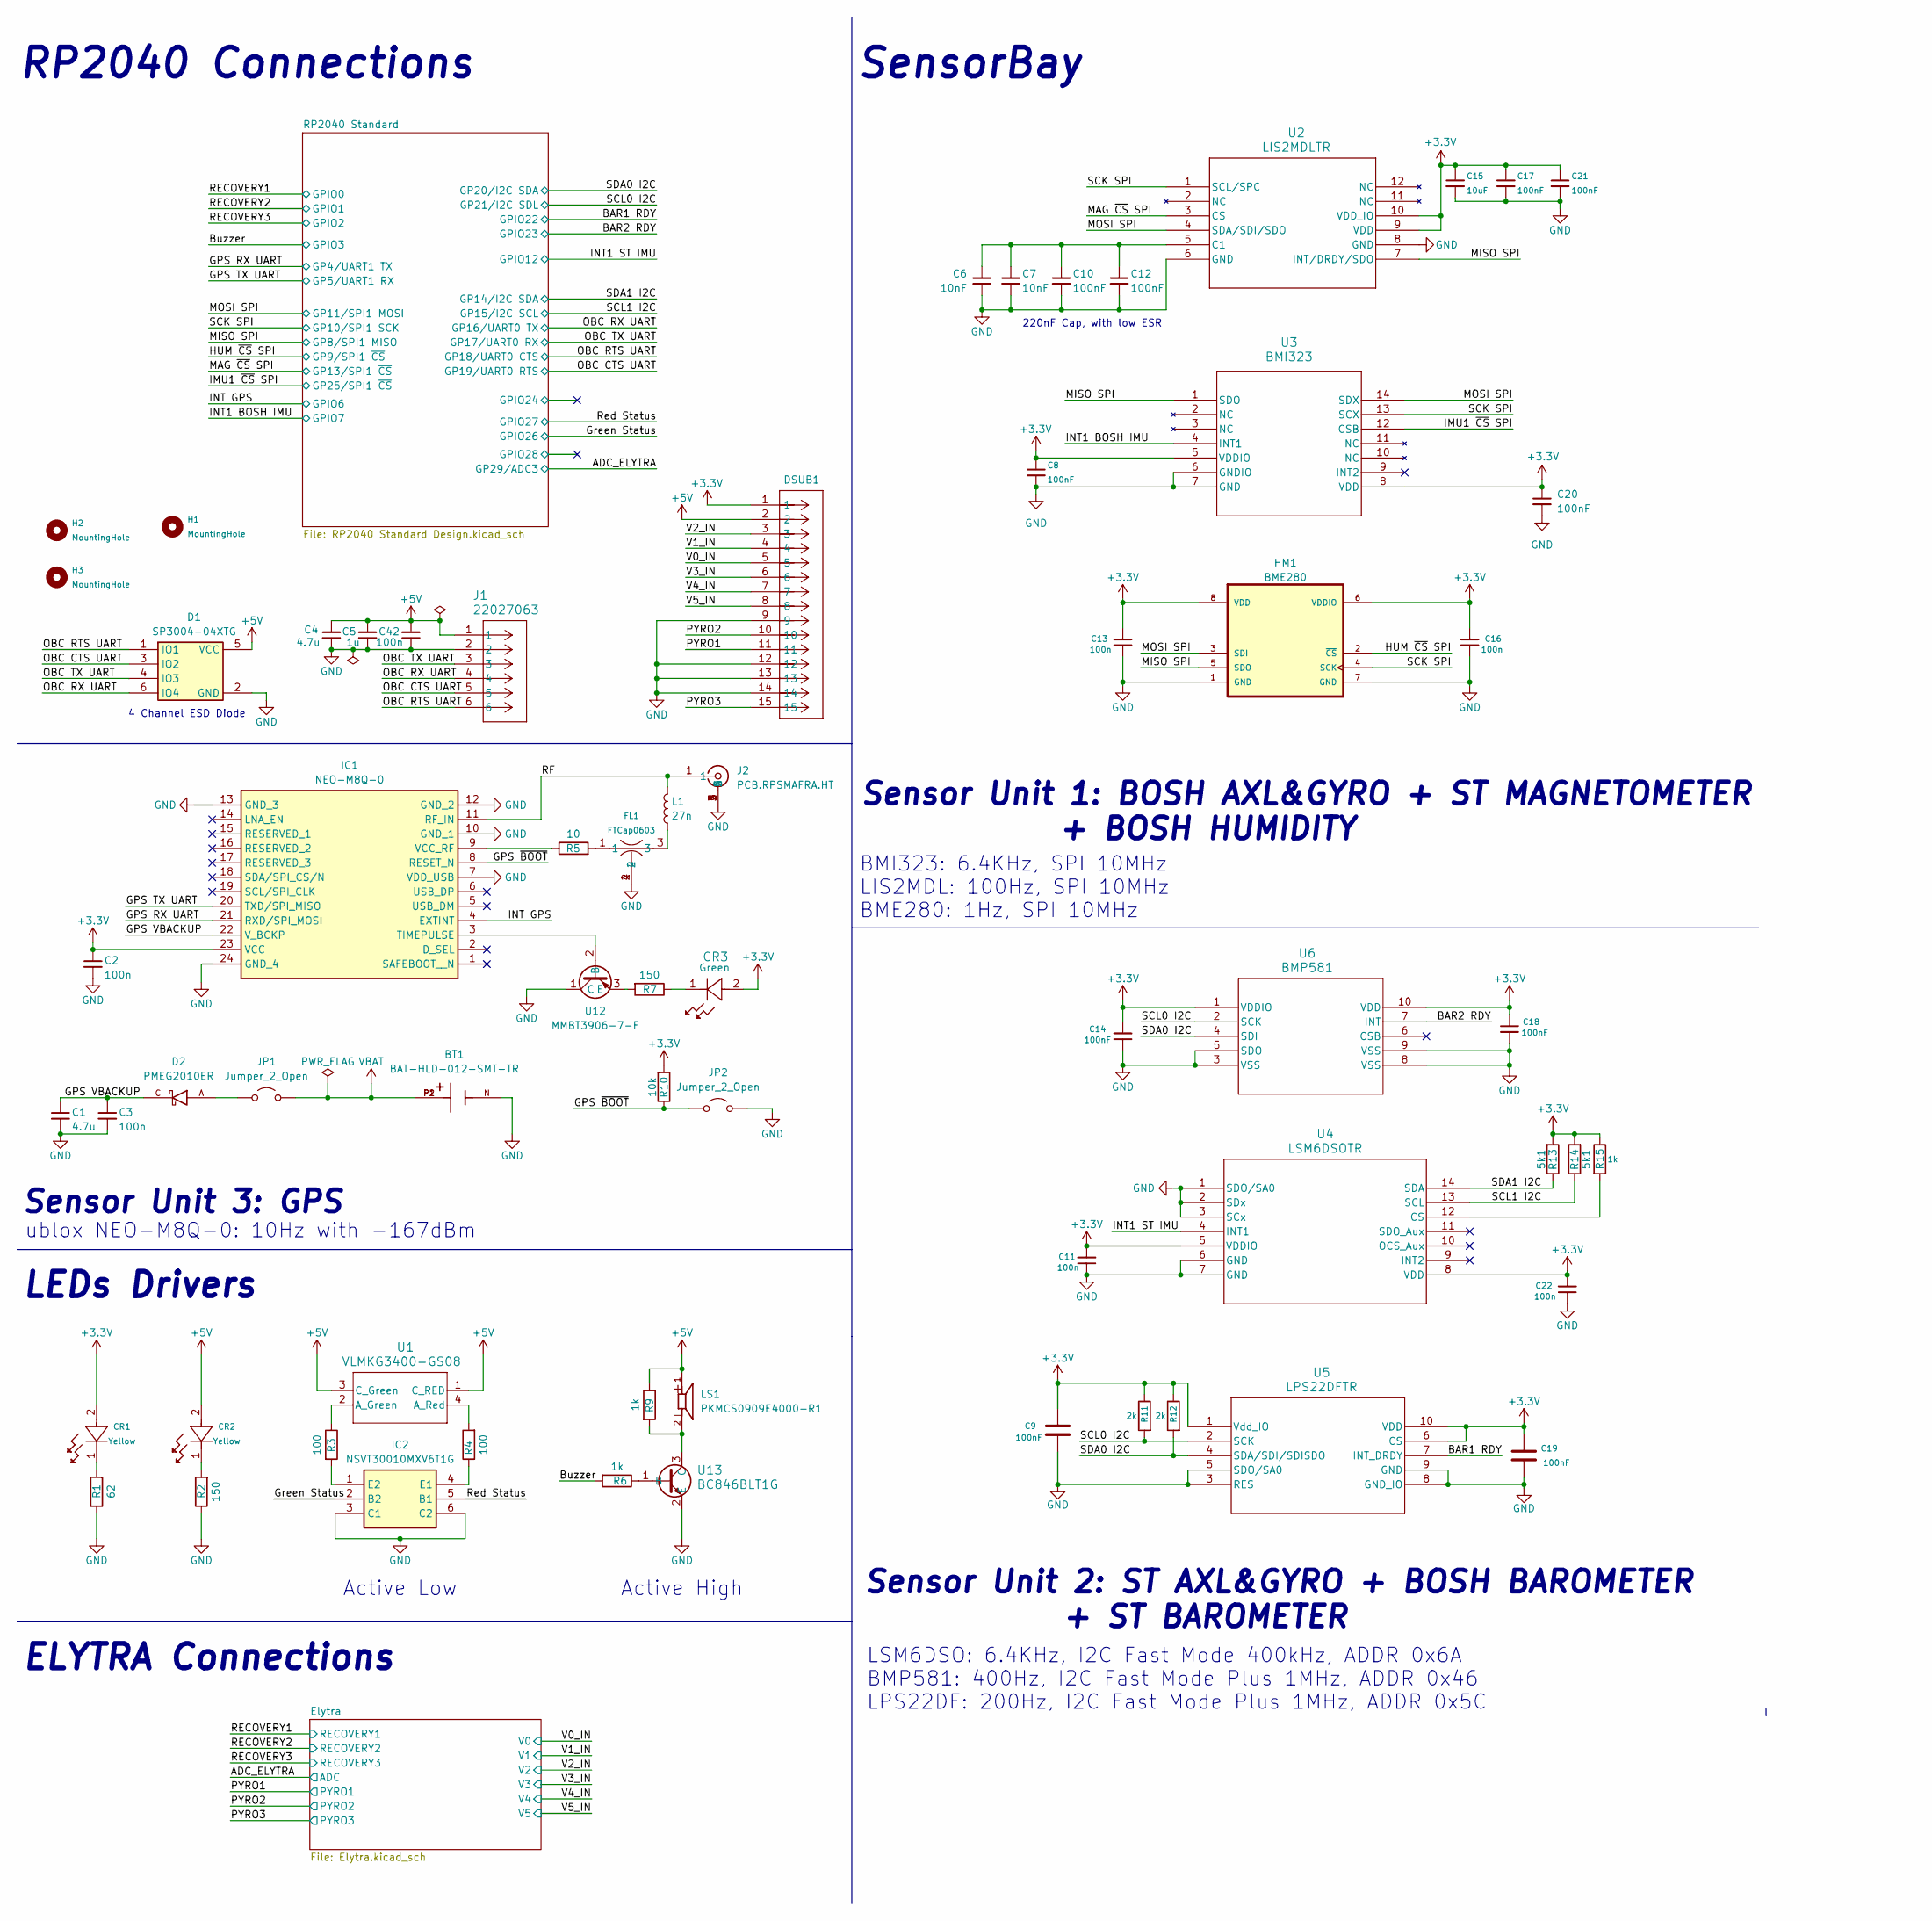
[picture p59: schematic Navigator.kicad_sch]

Parts:
BT1: BAT-HLD-012-SMT-TR; BAT_BAT-HLD-012-SMT-TR; PARTREV A
C1, C4: 4.7u; Capacitor_0402
C2, C3, C11, C13, C16, C22, C42: 100n; Capacitor_0402
C5: 1u; Capacitor_0402
C6, C7: 10nF; Capacitor_0402
C8, C9, C10, C12, C14, C17, C18, C19, C20, C21: 100nF; Capacitor_0402
C15: 10uF; Capacitor_0805
CR1, CR2: VLMY1300-GS08; LEDC1608X100N
CR3: VLMC3100-GS08; LED_PLCC_VSMB
D1: SP3004-04XTG; SOT563_LTF; Mouser Part Number 576-SP3004-04XTG
D2: PMEG2010ER; SODFL3517X110N; PARTREV 01
DSUB1: HDL15-SL-B
FL1: FTCap0603; FTCap_0603
H1, H2, H3: MountingHole; MountingHole_3.2mm_M3_ISO7380
HM1: BME280; Mouser Part Number 262-BME280
IC1: NEO-M8Q-0; NEO-M8_UBL; Mouser Part Number 377-NEO-M8Q-0
IC2: NSVT30010MXV6T1G; SOTFL50P160X60-6N; Mouser Part Number 863-NSVT30010MXV6T1G
J1: 22027063; CONN6X1_22027063_MOL
J2: PCB.RPSMAFRA.HT; PCBRPSMAFRAHT; Mouser Part Number 960-PCB.RPSMAFRA.HT
JP1, JP2: Jumper_2_Open; SolderJumper-2_P1.3mm_Open_RoundedPad1.0x1.5mm
L1: 27n; Inductor_0402
LS1: PKMCS0909E4000-R1; SPKR_PKMCS0909E4000-R1; PARTREV May 22, 2020
R1: 62; RES_0603
R2, R7: 150; RES_0603
R3, R4: 100; RES_0603
R5: 10; RES_0402
R6, R9: 1k; RES_0603
R10: 10k; RES_0402
R11, R12: 2k; RES_0402
R13, R14: 5k1; RES_0402
R15: 1k; RES_0402
U1: VLMKG3400-GS08; SMT_00-GS08_VIS
U2: LIS2MDLTR; LGA-12_2X2X1_STM
U3: BMI323; BMI323_BOS
U4: LSM6DSOTR; LGA-14L_2P5X3X0P86_STM
U5: LPS22DFTR; QFN_22DFTR_STM
U6: BMP581; QFN10_BMP581_BOS
U12: MMBT3906-7-F; SOT103P240X110-3N; MPN MMBT3906-7-F
U13: BC846BLT1G; SOT-23_ONS

Connections:
+3.3V: C2.1, C8.1, C9.2, C11.2, C13.2, C14.2, C15.1, C16.2, C17.1, C18.1, C19.2, C20.1, C21.1, C22.2, CR1.2, CR3.2, DSUB1.1, HM1.6 (VDDIO), HM1.8 (VDD), IC1.23 (VCC), R10.2, R11.1, R12.1, R13.2, R14.2, R15.1, U2.9 (VDD), U2.10 (VDD_IO), U3.5 (VDDIO), U3.8 (VDD), U4.5 (VDDIO), U4.8 (VDD), U5.1 (Vdd_IO), U5.6 (CS), U5.10 (VDD), U6.1 (VDDIO), U6.10 (VDD); also elsewhere on the board
+5V: C4.2, C5.2, C42.2, CR2.2, D1.5 (VCC), DSUB1.2, J1.1, LS1.1, R9.1, U1.1 (C_RED), U1.3 (C_Green); also elsewhere on the board
/BAR1 RDY: U5.7 (INT_DRDY); also elsewhere on the board
/BAR2 RDY: U6.7 (INT); also elsewhere on the board
/Buzzer: R6.2; also elsewhere on the board
/GPS RX UART: IC1.21 (RXD/SPI_MOSI); also elsewhere on the board
/GPS TX UART: IC1.20 (TXD/SPI_MISO); also elsewhere on the board
/GPS VBACKUP: C1.1, C3.1, D2.C, IC1.22 (V_BCKP)
/GPS ~BOOT: IC1.8 (RESET_N), JP2.1 (A), R10.1
/Green Status: IC2.2 (B2); also elsewhere on the board
/HUM ~CS SPI: HM1.2 (~CS); also elsewhere on the board
/IMU1 ~CS SPI: U3.12 (CSB); also elsewhere on the board
/INT1 BOSH IMU: U3.4 (INT1); also elsewhere on the board
/INT1 ST IMU: U4.4 (INT1); also elsewhere on the board
/INT GPS: IC1.4 (EXTINT); also elsewhere on the board
/MAG ~CS SPI: U2.3 (CS); also elsewhere on the board
/MISO SPI: HM1.5 (SDO), U2.7 (INT/DRDY/SDO), U3.1 (SDO); also elsewhere on the board
/MOSI SPI: HM1.3 (SDI), U2.4 (SDA/SDI/SDO), U3.14 (SDX); also elsewhere on the board
/OBC CTS UART: D1.3 (IO2), J1.5; also elsewhere on the board
/OBC RTS UART: D1.1 (IO1), J1.6; also elsewhere on the board
/OBC RX UART: D1.6 (IO4), J1.4; also elsewhere on the board
/OBC TX UART: D1.4 (IO3), J1.3; also elsewhere on the board
/PYRO1: DSUB1.11; also elsewhere on the board
/PYRO2: DSUB1.10; also elsewhere on the board
/PYRO3: DSUB1.15; also elsewhere on the board
/RF: IC1.11 (RF_IN), J2.1, L1.2
/Red Status: IC2.5 (B1); also elsewhere on the board
/SCK SPI: HM1.4 (SCK), U2.1 (SCL/SPC), U3.13 (SCX); also elsewhere on the board
/SCL0 I2C: R11.2, U5.2 (SCK), U6.2 (SCK); also elsewhere on the board
/SCL1 I2C: R14.1, U4.13 (SCL); also elsewhere on the board
/SDA0 I2C: R12.2, U5.4 (SDA/SDI/SDISDO), U6.4 (SDI); also elsewhere on the board
/SDA1 I2C: R13.1, U4.14 (SDA); also elsewhere on the board
/V0_IN: DSUB1.5; also elsewhere on the board
/V1_IN: DSUB1.4; also elsewhere on the board
/V2_IN: DSUB1.3; also elsewhere on the board
/V3_IN: DSUB1.6; also elsewhere on the board
/V4_IN: DSUB1.7; also elsewhere on the board
/V5_IN: DSUB1.8; also elsewhere on the board
GND: BT1.N, C1.2, C2.2, C3.2, C4.1, C5.1, C6.2, C7.2, C8.2, C9.1, C10.2, C11.1, C12.2, C13.1, C14.1, C15.2, C16.1, C17.2, C18.2, C19.1, C20.2, C21.2, C22.1, C42.1, D1.2 (GND), DSUB1.9, DSUB1.12, DSUB1.13, DSUB1.14, FL1.2, FL1.4, HM1.1 (GND), HM1.7 (GND), IC1.7 (VDD_USB), IC1.10 (GND_1), IC1.12 (GND_2), IC1.13 (GND_3), IC1.24 (GND_4), IC2.3 (C1), IC2.6 (C2), J1.2, J2.2, J2.3, J2.4, J2.5, JP2.2 (B), R1.1, R2.1, U2.6 (GND), U2.8 (GND), U3.6 (GNDIO), U3.7 (GND), U4.1 (SDO/SA0), U4.2 (SDx), U4.3 (SCx), U4.6 (GND), U4.7 (GND), U5.3 (RES), U5.5 (SDO/SA0), U5.8 (GND_IO), U5.9 (GND), U6.3 (VSS), U6.5 (SDO), U6.8 (VSS), U6.9 (VSS), U12.1 (C), U13.2 (E); also elsewhere on the board
unnamed: CR1.1, R1.2
unnamed: CR2.1, R2.2
unnamed: CR3.1, R7.1
unnamed: FL1.1, R5.2
unnamed: FL1.3, L1.1
unnamed: IC1.3 (TIMEPULSE), U12.2 (B)
unnamed: IC1.9 (VCC_RF), R5.1
unnamed: IC2.4 (E1), R4.1
unnamed: IC2.1 (E2), R3.2
unnamed: D2.A, JP1.1 (A)
unnamed: R3.1, U1.2 (A_Green)
unnamed: R4.2, U1.4 (A_Red)
unnamed: C6.1, C7.1, C10.1, C12.1, U2.5 (C1)
unnamed: R15.2, U4.12 (CS)
unnamed: R7.2, U12.3 (E)
unnamed: R6.1, U13.1 (B)
unnamed: LS1.2, R9.2, U13.3 (C)
VBAT: BT1.P1, BT1.P2, JP1.2 (B)

Notes on the sheet:
BMI323: 6.4KHz, SPI 10MHz LIS2MDL: 100Hz, SPI 10MHz BME280: 1Hz, SPI 10MHz
Sensor Unit 2: ST AXL&GYRO + BOSH BAROMETER + ST BAROMETER
SensorBay
Active Low
ELYTRA Connections
RP2040 Connections
Sensor Unit 3: GPS
Active High
LEDs Drivers
Sensor Unit 1: BOSH AXL&GYRO + ST MAGNETOMETER + BOSH HUMIDITY
4 Channel ESD Diode
ublox NEO-M8Q-0: 10Hz with -167dBm
LSM6DSO: 6.4KHz, I2C Fast Mode 400kHz, ADDR 0x6A BMP581: 400Hz, I2C Fast Mode Plus 1MHz, ADDR 0x46 LPS22DF: 200Hz, I2C Fast Mode Plus 1MHz, ADDR 0x5C
220nF Cap, with low ESR

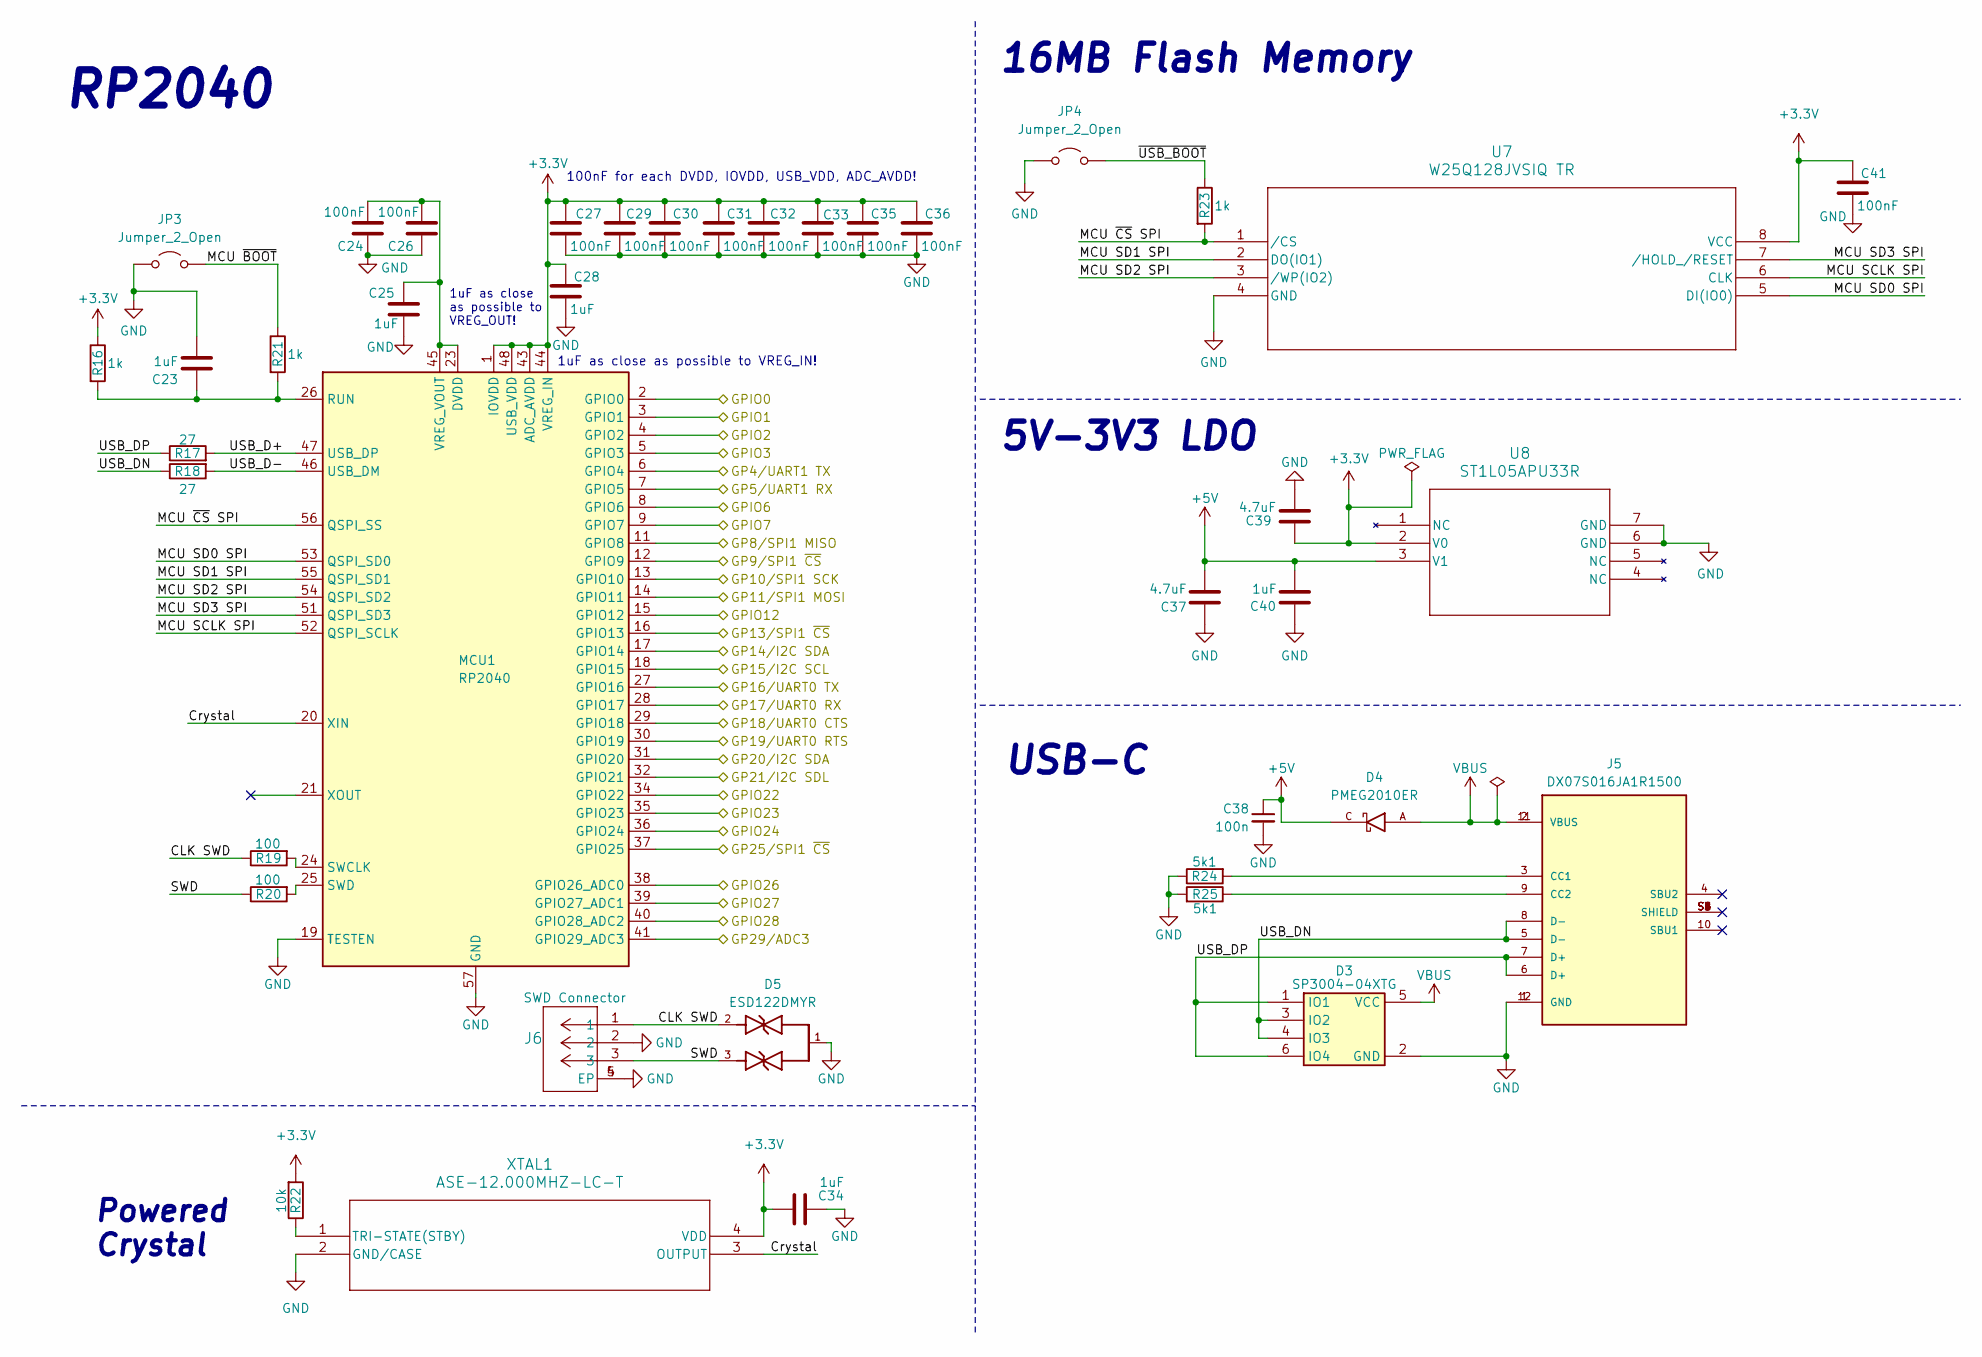
[picture p60: schematic RP2040 Standard Design.kicad_sch, RP2040 Standard]

Parts:
C23, C25, C28, C34, C40: 1uF; Capacitor_0402
C24, C26, C27, C29, C30, C31, C32, C33, C35, C36, C41: 100nF; Capacitor_0402
C37, C39: 4.7uF; Capacitor_0402
C38: 100n; Capacitor_0402
D3: SP3004-04XTG; SOT563_LTF; Mouser Part Number 576-SP3004-04XTG
D4: PMEG2010ER; SODFL3517X110N; PARTREV 01
D5: ESD122DMYR; DIO_ESD122DMYR; PARTREV A
J5: DX07S016JA1R1500; JAE_DX07S016JA1R1500; PARTREV 1
J6: BM03B-SRSS-TBLFSN; CONN_BM03B-SRSS-TBLFSN_JST
JP3, JP4: Jumper_2_Open; SolderJumper-2_P1.3mm_Open_RoundedPad1.0x1.5mm
MCU1: RP2040; QFN56_7X7_RPI
R16, R21, R23: 1k; RES_0402
R17, R18: 27; RES_0402
R19, R20: 100; RES_0402
R22: 10k; RES_0402
R24, R25: 5k1; RES_0402
U7: W25Q128JVSIQ TR; SOIC_208MIL_WIN
U8: ST1L05APU33R; DFN_5APU33R_STM
XTAL1: ASE-12.000MHZ-LC-T; ASE24576MHZLCT

Connections:
+3.3V: C27.1, C28.1, C29.1, C30.1, C31.1, C32.1, C33.1, C34.1, C35.1, C36.1, C39.2, C41.1, MCU1.1 (IOVDD), MCU1.10 (IOVDD), MCU1.22 (IOVDD), MCU1.33 (IOVDD), MCU1.42 (IOVDD), MCU1.43 (ADC_AVDD), MCU1.44 (VREG_IN), MCU1.48 (USB_VDD), MCU1.49 (IOVDD), R16.1, R22.2, U7.8 (VCC), U8.2 (V0), XTAL1.4 (VDD); also elsewhere on the board
+5V: C37.2, C38.1, C40.2, D4.C, U8.3 (V1); also elsewhere on the board
/ADC_ELYTRA: MCU1.41 (GPIO29_ADC3); also elsewhere on the board
/BAR1 RDY: MCU1.34 (GPIO22); also elsewhere on the board
/BAR2 RDY: MCU1.35 (GPIO23); also elsewhere on the board
/Buzzer: MCU1.5 (GPIO3); also elsewhere on the board
/GPS RX UART: MCU1.6 (GPIO4); also elsewhere on the board
/GPS TX UART: MCU1.7 (GPIO5); also elsewhere on the board
/Green Status: MCU1.38 (GPIO26_ADC0); also elsewhere on the board
/HUM ~CS SPI: MCU1.12 (GPIO9); also elsewhere on the board
/IMU1 ~CS SPI: MCU1.37 (GPIO25); also elsewhere on the board
/INT1 BOSH IMU: MCU1.9 (GPIO7); also elsewhere on the board
/INT1 ST IMU: MCU1.15 (GPIO12); also elsewhere on the board
/INT GPS: MCU1.8 (GPIO6); also elsewhere on the board
/MAG ~CS SPI: MCU1.16 (GPIO13); also elsewhere on the board
/MISO SPI: MCU1.11 (GPIO8); also elsewhere on the board
/MOSI SPI: MCU1.14 (GPIO11); also elsewhere on the board
/OBC CTS UART: MCU1.30 (GPIO19); also elsewhere on the board
/OBC RTS UART: MCU1.29 (GPIO18); also elsewhere on the board
/OBC RX UART: MCU1.27 (GPIO16); also elsewhere on the board
/OBC TX UART: MCU1.28 (GPIO17); also elsewhere on the board
/RECOVERY1: MCU1.2 (GPIO0); also elsewhere on the board
/RECOVERY2: MCU1.3 (GPIO1); also elsewhere on the board
/RECOVERY3: MCU1.4 (GPIO2); also elsewhere on the board
/RP2040 Standard/CLK SWD: D5.2, J6.1, R19.1
/RP2040 Standard/Crystal: MCU1.20 (XIN), XTAL1.3 (OUTPUT)
/RP2040 Standard/GPIO24: MCU1.36 (GPIO24)
/RP2040 Standard/GPIO28: MCU1.40 (GPIO28_ADC2)
/RP2040 Standard/MCU SCLK SPI: MCU1.52 (QSPI_SCLK), U7.6 (CLK)
/RP2040 Standard/MCU SD0 SPI: MCU1.53 (QSPI_SD0), U7.5 (DI(IO0))
/RP2040 Standard/MCU SD1 SPI: MCU1.55 (QSPI_SD1), U7.2 (DO(IO1))
/RP2040 Standard/MCU SD2 SPI: MCU1.54 (QSPI_SD2), U7.3 (/WP(IO2))
/RP2040 Standard/MCU SD3 SPI: MCU1.51 (QSPI_SD3), U7.7 (/HOLD_/RESET)
/RP2040 Standard/MCU ~BOOT: JP3.2 (B), R21.1
/RP2040 Standard/MCU ~CS SPI: MCU1.56 (QSPI_SS), R23.2, U7.1 (/CS)
/RP2040 Standard/SWD: D5.3, J6.3, R20.1
/RP2040 Standard/USB_D+: MCU1.47 (USB_DP), R17.2
/RP2040 Standard/USB_D-: MCU1.46 (USB_DM), R18.2
/RP2040 Standard/USB_DN: D3.3 (IO2), D3.4 (IO3), J5.5 (D-), J5.8 (D-), R18.1
/RP2040 Standard/USB_DP: D3.1 (IO1), D3.6 (IO4), J5.6 (D+), J5.7 (D+), R17.1
/RP2040 Standard/~USB_BOOT: JP4.2 (B), R23.1
/Red Status: MCU1.39 (GPIO27_ADC1); also elsewhere on the board
/SCK SPI: MCU1.13 (GPIO10); also elsewhere on the board
/SCL0 I2C: MCU1.32 (GPIO21); also elsewhere on the board
/SCL1 I2C: MCU1.18 (GPIO15); also elsewhere on the board
/SDA0 I2C: MCU1.31 (GPIO20); also elsewhere on the board
/SDA1 I2C: MCU1.17 (GPIO14); also elsewhere on the board
GND: C23.2, C24.1, C25.2, C26.1, C27.2, C28.2, C29.2, C30.2, C31.2, C32.2, C33.2, C34.2, C35.2, C36.2, C37.1, C38.2, C39.1, C40.1, C41.2, D3.2 (GND), D5.1, J5.1 (GND), J5.12 (GND), J6.2, J6.4 (EP), J6.5 (EP), JP3.1 (A), JP4.1 (A), MCU1.19 (TESTEN), MCU1.57 (GND), R24.1, R25.2, U7.4 (GND), U8.6 (GND), U8.7 (GND), XTAL1.2 (GND/CASE); also elsewhere on the board
unnamed: J5.3 (CC1), R24.2
unnamed: J5.9 (CC2), R25.1
unnamed: C23.1, MCU1.26 (RUN), R16.2, R21.2
unnamed: MCU1.24 (SWCLK), R19.2
unnamed: MCU1.25 (SWD), R20.2
unnamed: C24.2, C25.1, C26.2, MCU1.23 (DVDD), MCU1.45 (VREG_VOUT), MCU1.50 (DVDD)
unnamed: R22.1, XTAL1.1 (TRI-STATE(STBY))
VBUS: D3.5 (VCC), D4.A, J5.2 (VBUS), J5.11 (VBUS)

Notes on the sheet:
1uF as close as possible to VREG_OUT!
Powered Crystal
RP2040
5V-3V3 LDO
16MB Flash Memory
1uF as close as possible to VREG_IN!
100nF for each DVDD, IOVDD, USB_VDD, ADC_AVDD!
USB-C

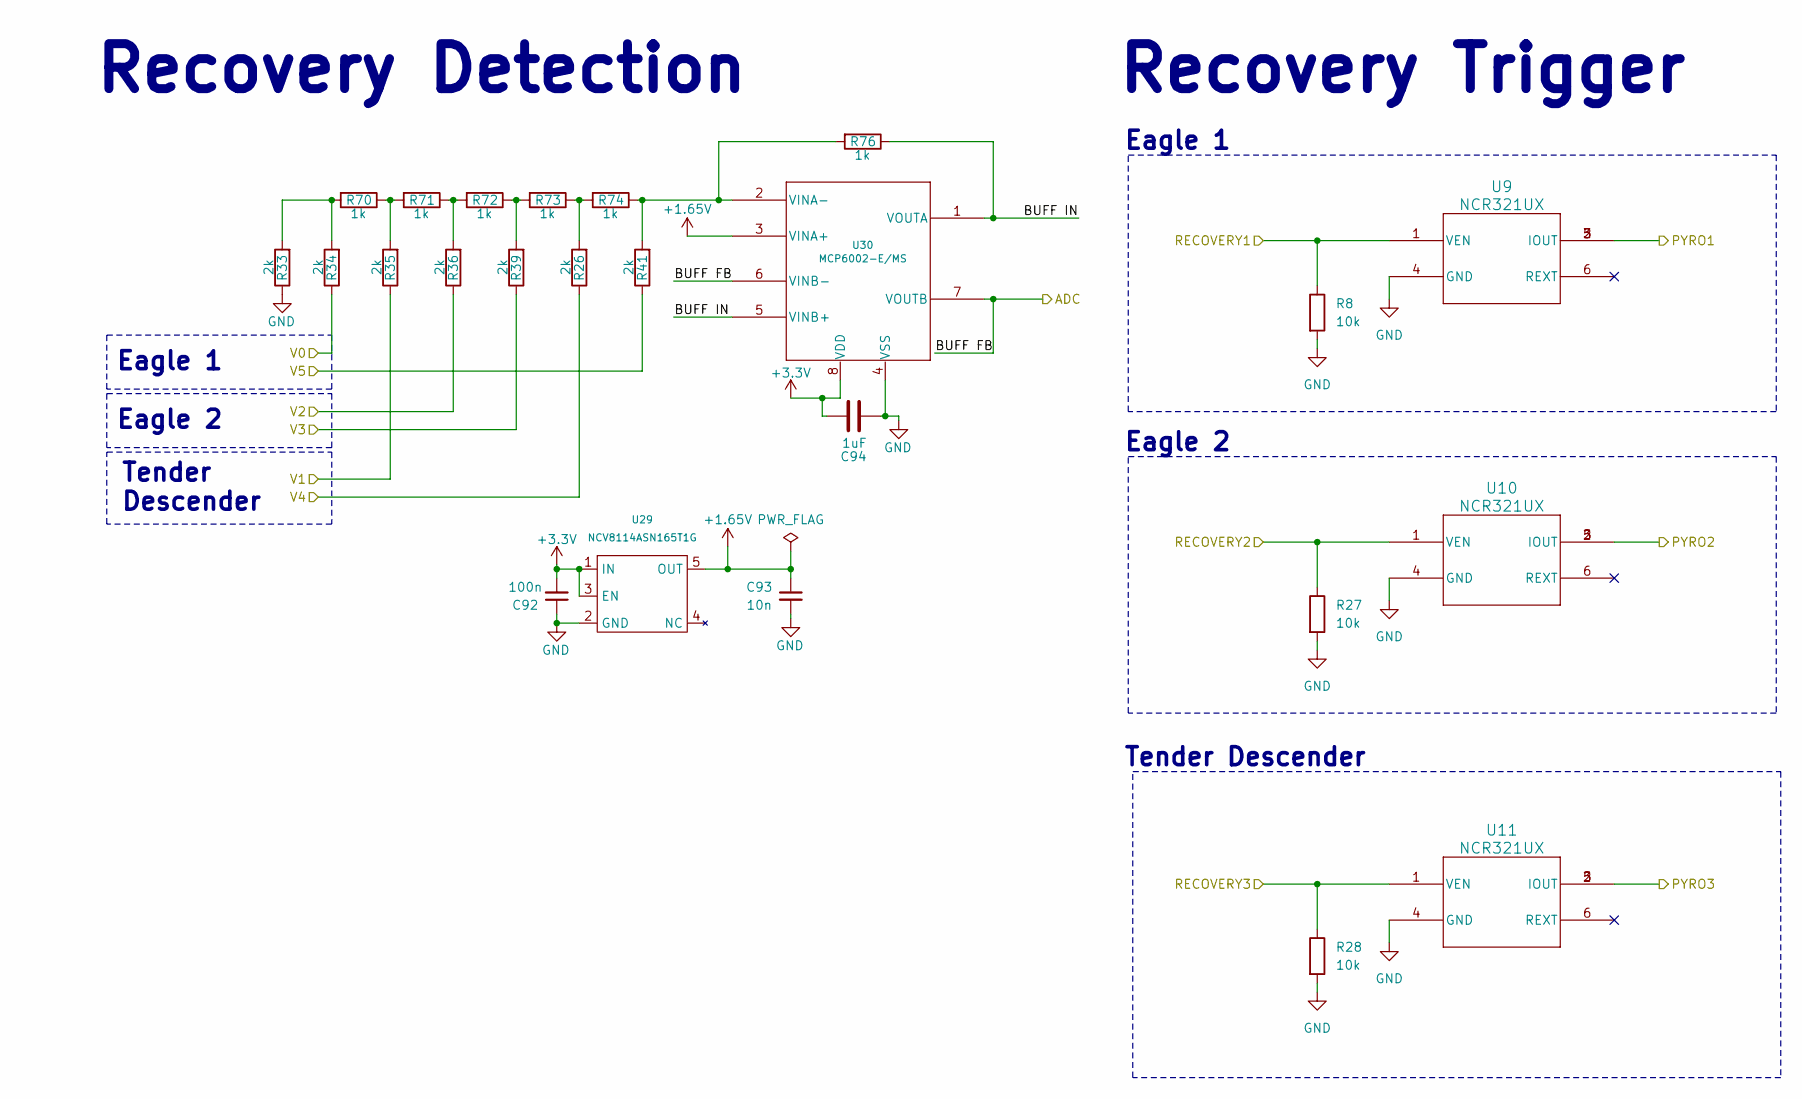
[picture p61: schematic Elytra.kicad_sch]

Parts:
C92: 100n; Capacitor_0402
C93: 10n; Capacitor_0402
C94: 1uF; Capacitor_0402
R8, R27, R28: 10k; RES_0402
R26, R33, R34, R35, R36, R39, R41: 2k; RES_0603
R70, R71, R72, R73, R74: 1k; RES_0603
R76: 1k; RES_0402
U9, U10, U11: NCR321UX; TSOP6_SOT457_NEX
U29: NCV8114ASN165T1G; SOT95P275X120-5N
U30: MCP6002-E/MS; MSOP8_MC_MCH

Connections:
+1.65V: C93.1, U29.5 (OUT), U30.3 (VINA+)
+3.3V: C92.2, C94.1, U29.1 (IN), U29.3 (EN), U30.8 (VDD); also elsewhere on the board
/ADC_ELYTRA: U30.6 (VINB-), U30.7 (VOUTB); also elsewhere on the board
/Elytra/BUFF IN: R76.1, U30.1 (VOUTA), U30.5 (VINB+)
/PYRO1: U9.2 (IOUT), U9.3 (IOUT), U9.5 (IOUT); also elsewhere on the board
/PYRO2: U10.2 (IOUT), U10.3 (IOUT), U10.5 (IOUT); also elsewhere on the board
/PYRO3: U11.2 (IOUT), U11.3 (IOUT), U11.5 (IOUT); also elsewhere on the board
/RECOVERY1: R8.1, U9.1 (VEN); also elsewhere on the board
/RECOVERY2: R27.1, U10.1 (VEN); also elsewhere on the board
/RECOVERY3: R28.1, U11.1 (VEN); also elsewhere on the board
/V0_IN: R34.1; also elsewhere on the board
/V1_IN: R35.1; also elsewhere on the board
/V2_IN: R36.1; also elsewhere on the board
/V3_IN: R39.1; also elsewhere on the board
/V4_IN: R26.1; also elsewhere on the board
/V5_IN: R41.1; also elsewhere on the board
GND: C92.1, C93.2, C94.2, R8.2, R27.2, R28.2, R33.1, U9.4 (GND), U10.4 (GND), U11.4 (GND), U29.2 (GND), U30.4 (VSS); also elsewhere on the board
unnamed: R26.2, R73.1, R74.2
unnamed: R33.2, R34.2, R70.2
unnamed: R35.2, R70.1, R71.2
unnamed: R36.2, R71.1, R72.2
unnamed: R39.2, R72.1, R73.2
unnamed: R41.2, R74.1, R76.2, U30.2 (VINA-)

Notes on the sheet:
Recovery Trigger
Recovery Detection
Tender Descender
Tender Descender
Eagle 2
Eagle 1
