FilipaRibeiro2020/Invictus2.0_Hardware/Boards/Rocket Systems/Navigator/Navigator.kicad_pcb

## KiCad design Boards/Rocket Systems/Navigator/Navigator.kicad_pcb (continued)

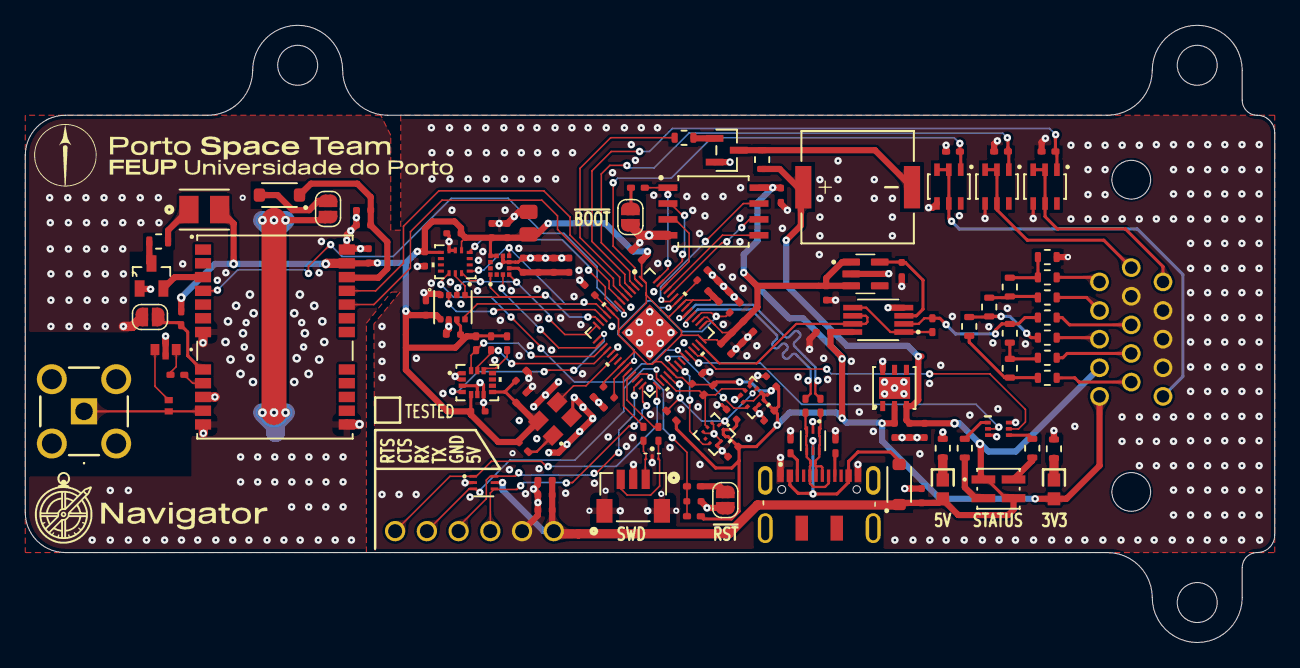
[picture p62: board Navigator.kicad_pcb from above]

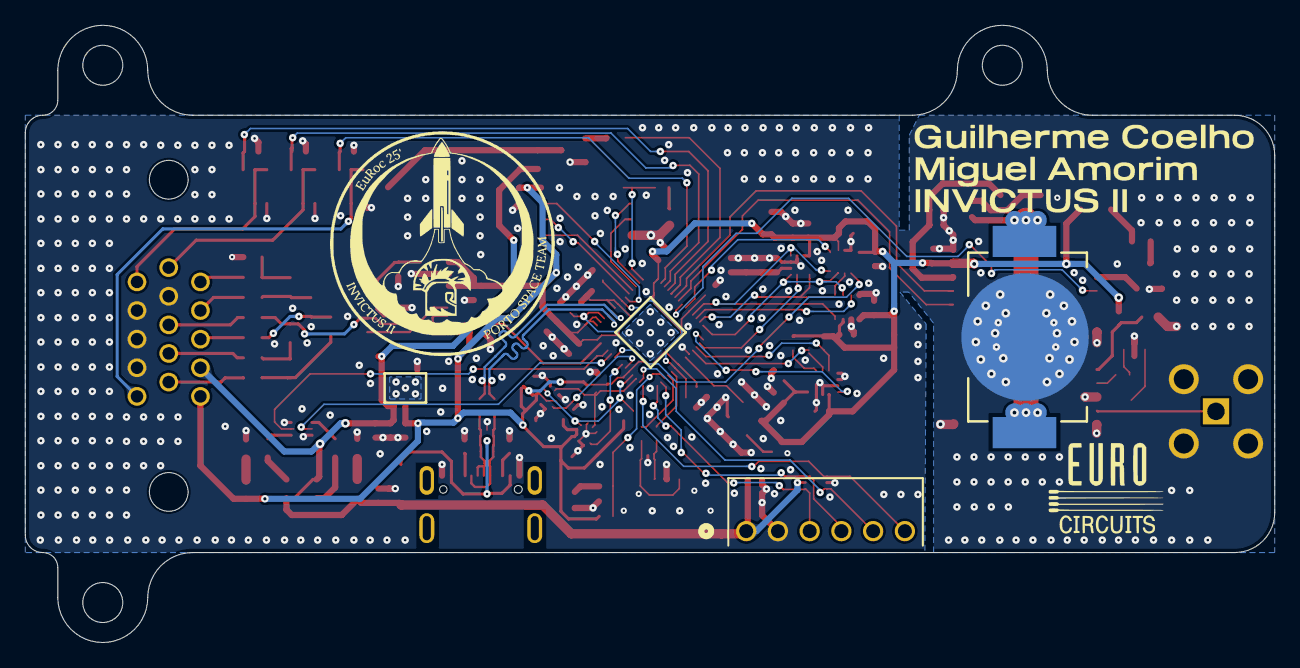
[picture p63: board Navigator.kicad_pcb from below]

Board: 4 copper layers, 100.0 x 49.4 mm, 129 parts (2 on the bottom side), 92 nets.
